Oszimilian/Kabeltester/03_Dokumente/02_Projektdokumentation/01_Dokumentation_Latex/Abschlussprojekt_LaTeX_002/BA_Auftragsdurchführung.tex

%%%%%%%%%%%%%%%%%%%%%%%%%%%%%%%%%%%%%%%%%%%%%%%%%%%%%%%%%%%%%%%%%%%%%%%%%%%%%%%%%%%%%%%%%%%%%%%%%%%%%%%%%%%%%%%%%%%%%%%%%																																						%
%														Versorgung														%
%																														%
%%%%%%%%%%%%%%%%%%%%%%%%%%%%%%%%%%%%%%%%%%%%%%%%%%%%%%%%%%%%%%%%%%%%%%%%%%%%%%%%%%%%%%%%%%%%%%%%%%%%%%%%%%%%%%%%%%%%%%%%%

\section{Schaltplanentwurf}

In den hier abgebildeten Schaltplanausschnitte werden vereinzelt Fehler markiert. Diese sind dabei schon behoben und werden im Kapitel Fehleranalyse behandelt. 

\subsection{Versorgung}

\subsubsection{Schutzbeschaltung}

\begin{center}
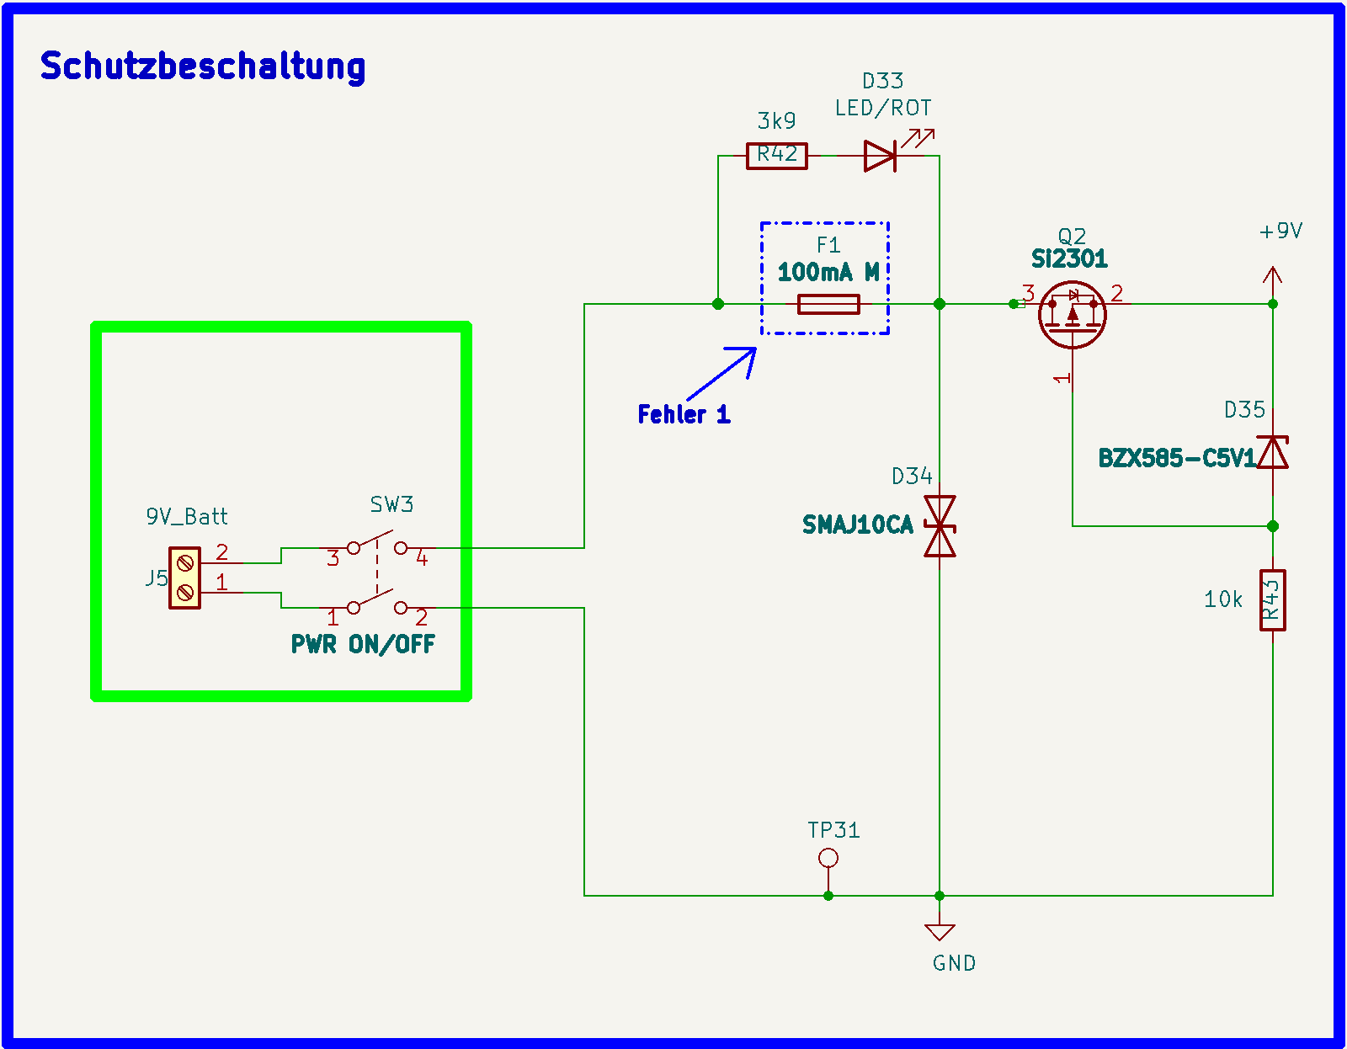
[picture p1: 03_Dokumente/02_Projektdokumentation/01_Dokumentation_Latex/Abschlussprojekt_LaTeX_002/Bilder/Schutzbeschaltung.png]

\end{center}

Um die Schaltung zu schützen wurde auf eine umfangreiche Eingangsschutzbeschaltung gesetzt. Die Versorgungsspannung kann dabei zweipolig durch den Schalter \glqq Power ON/OFF SW3 \grqq{} abgeschaltet werden.
\\
\\
Die mittelträge Sicherung F1 ist für den Überstromschutz verantwortlich. Löst diese aus, so fließt ein Strom über R42 und D33. Dabei wird der gesamte Stromfluss in der Schaltung auf ein Maximum von 2mA begrenzt. Als Ergebnis leuchtet D33 rot.
\\
Im Normalbetrieb werden R42 und D33 durch den ohmschen Widerstand der Sicherung F1 (12R) überbrückt.
\\
\\
Um den Eingang des DC/DC Wandlers vor Überspannungsspitzen zu schützen, kommt eine 10V TVS Diode zum Einsatz. Die Eingangsspannung dieser Schaltung wird dadurch auf ein Spannungsmaximum von 10V begrenzt. 
\\
\\
Da es bei einer Batterieanwendung sehr schnell zu einer ungewollten Verpolung der Anschlüsse kommen kann, wird ein Verpolungsschutz benötigt.
\\
Liegt eine korrekt gepolte Spannung an, so fließt der Strom durch die Z-Diode D35 und den strombegrenzenden Widerstand R43. Die über die Z-Diode abfallende Spannung von 5,1V liegt somit auch an den Anschlüssen \glqq Source\grqq{} und \glqq Gate\grqq des P-Channel MOSFET Q2 an.
In diesem Fall liegt eine um ca. 5V negativere Spannung an Gate gegenüber Source an. Die Drain-Source Strecke leitet und es kann Strom fließen.
\\ 
Wird die Versorgungsspannung verpolt, so fließt der Strom durch den Widerstand R43 und durch die Diode D35. Die Diode D35 befindet sich dabei in Durchlassrichtung und besitzt somit die Eigenschaften einer Si-Diode.
Die Spannung an dem Gate ist dabei um ca. 5V positiver gegenüber Source. Der P-Channel MOSFET sperrt und unterbindet einen Stromfluss.
\\

\subsubsection{DC/DC Wandler}

\begin{center}
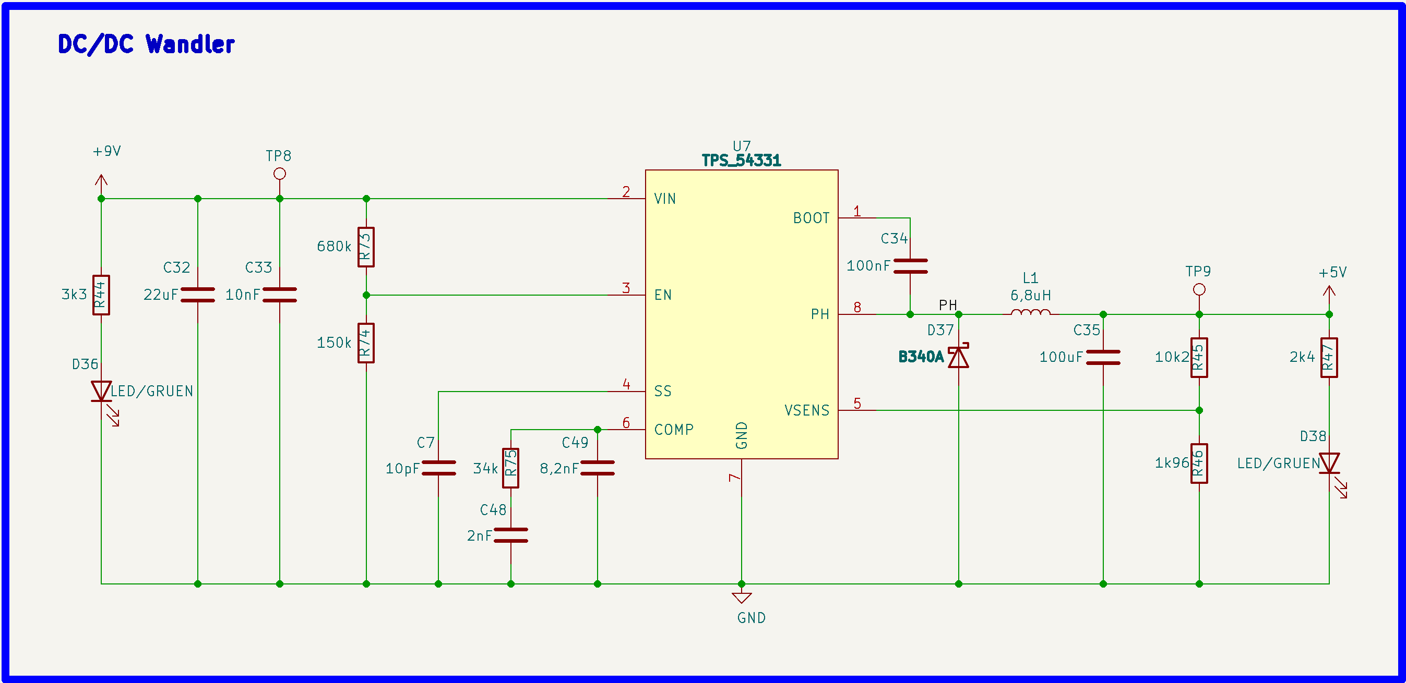
[picture p2: 03_Dokumente/02_Projektdokumentation/01_Dokumentation_Latex/Abschlussprojekt_LaTeX_002/Bilder/DCDCWandler.png]

\end{center}

Bei der Auswahl des DC/DC Wandlers wurde auf die Verfügbarkeit bei BMK im Haus geachtet.
\\
Die Dimensionierung der externen Bauelemente wurde mit Hilfe des \glqq Texas Instruments Power Designer\grqq{} Web-Tool durchgeführt.
\\
Die grünen LED's D36 und D38 sorgen für ein optisches Feedback der Versorgungsspannungen.
\\
Allgemein wurde der Wandler für eine Ausgangsspannung von +5V und einen Ausgangsstrom von ca. 1,5A dimensioniert. Mit den Widerständen R73 und R74 kann der Schaltregler bei Über/-Unterspannung abschalten. Dafür wird eine oberer sowie untere Schaltschwelle berechnet.

\begin{center}
\begin{align*}
	R73 &= \dfrac{V_{\Delta}}{3uA} = \dfrac{2V}{3uA} = 666k  \Rightarrow 680k\\
	\\
	R74 &= \dfrac{1,25V}{\dfrac{Vs - 1,25V}{R73} + 1uA} = \dfrac{1,25V}{\dfrac{8V - 1,25V}{680k} + 1uA} = 126k \Rightarrow 150k	\\
	\\
	V_{OUT}	&= V_{REF} + (\dfrac{R45}{R46} + 1) = 0,8V + (\dfrac{10,2k}{1,96k} + 1) = 4,96V
\end{align*}
\end{center}

\newpage

%%%%%%%%%%%%%%%%%%%%%%%%%%%%%%%%%%%%%%%%%%%%%%%%%%%%%%%%%%%%%%%%%%%%%%%%%%%%%%%%%%%%%%%%%%%%%%%%%%%%%%%%%%%%%%%%%%%%%%%%%																																						%
%														NE555 Taktgeber													%
%																														%
%%%%%%%%%%%%%%%%%%%%%%%%%%%%%%%%%%%%%%%%%%%%%%%%%%%%%%%%%%%%%%%%%%%%%%%%%%%%%%%%%%%%%%%%%%%%%%%%%%%%%%%%%%%%%%%%%%%%%%%%%

\subsection{NE555 Taktgeber}

\subsubsection{Takt}

\begin{center}
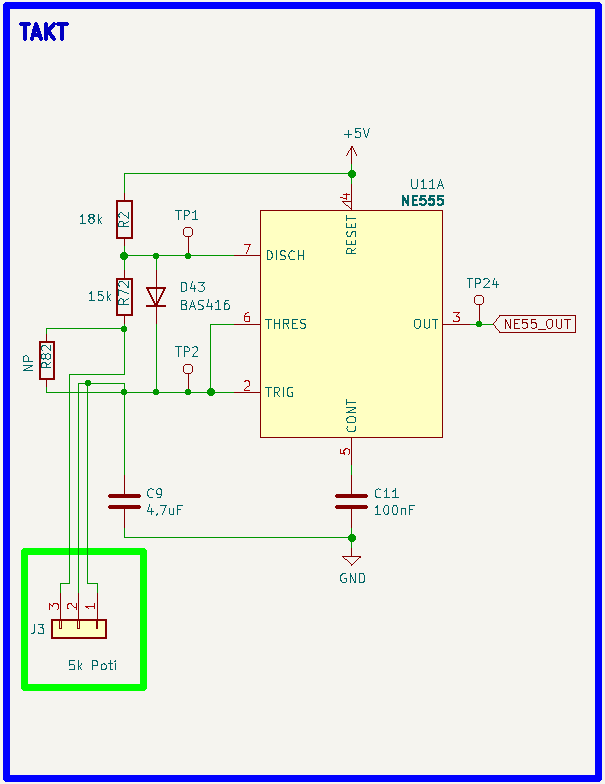
[picture p3: 03_Dokumente/02_Projektdokumentation/01_Dokumentation_Latex/Abschlussprojekt_LaTeX_002/Bilder/Takt.png]

\end{center}

Als Taktgeber kommt der \glqq NE555 \grqq{} zum Einsatz. Dieser wird als astabile Kippstufe betrieben und versorgt die Schaltung mit einem rechteckförmigen Taktsignal. Mit Hilfe der Diode D43 kommt eis zu einem symetrischen Verhältnis des Tastgrad. Über das Poti (Connector) J3 soll die Ausgangsfrequenz auf ca. 10Hz eingestellt werden können. 
\\
\\
Im Einschaltmoment ist C9 entladen (Kurzschluss). Somit liegt das Signal am Triggereingang (PIN 2) unterhalb von $\frac{1}{3} VCC$. Das interne FlipFlop wird gesetzt und der Ausgang (PIN 3) erfährt einen High-Pegel. Der Kondensator C9 lädt sich nun über R2, J3 und D43 auf. Der Ladevorgang hält so lange an, bis das Spannungspotential an Pin 6 (Threshold) einen höheren Wert als $\frac{2}{3} VCC$ aufweist. Das interne FlipFlop wird zurückgesetzt und der Ausgang schaltet auf Low. Der Kondensator C9 entlädt sich nun über R72 und den (auf GND durchgeschaltenen) Pin 7 (Discharge). Hat sich der Kondensator nun wieder auf ein Spannungspotential unterhalb von $\frac{1}{3}$ entladen, so wird er Ausgang erneut gesetzt und der Entladevorgang über Pin 7 unterbunden. Dieser Vorgang wiederholt sich solange eine Versorgungsspannung anliegt. 

\begin{center}
\begin{align*}
	f_{OUT} &= \dfrac{1}{0,69*R2*C9 + 0,69*(R72+R_{J3})* C9} = \dfrac{1}{0,69*18k*4,7uF*2} = 8,5Hz
\end{align*} 
\end{center}

\newpage
\subsubsection{Taktumschaltung}

\begin{center}
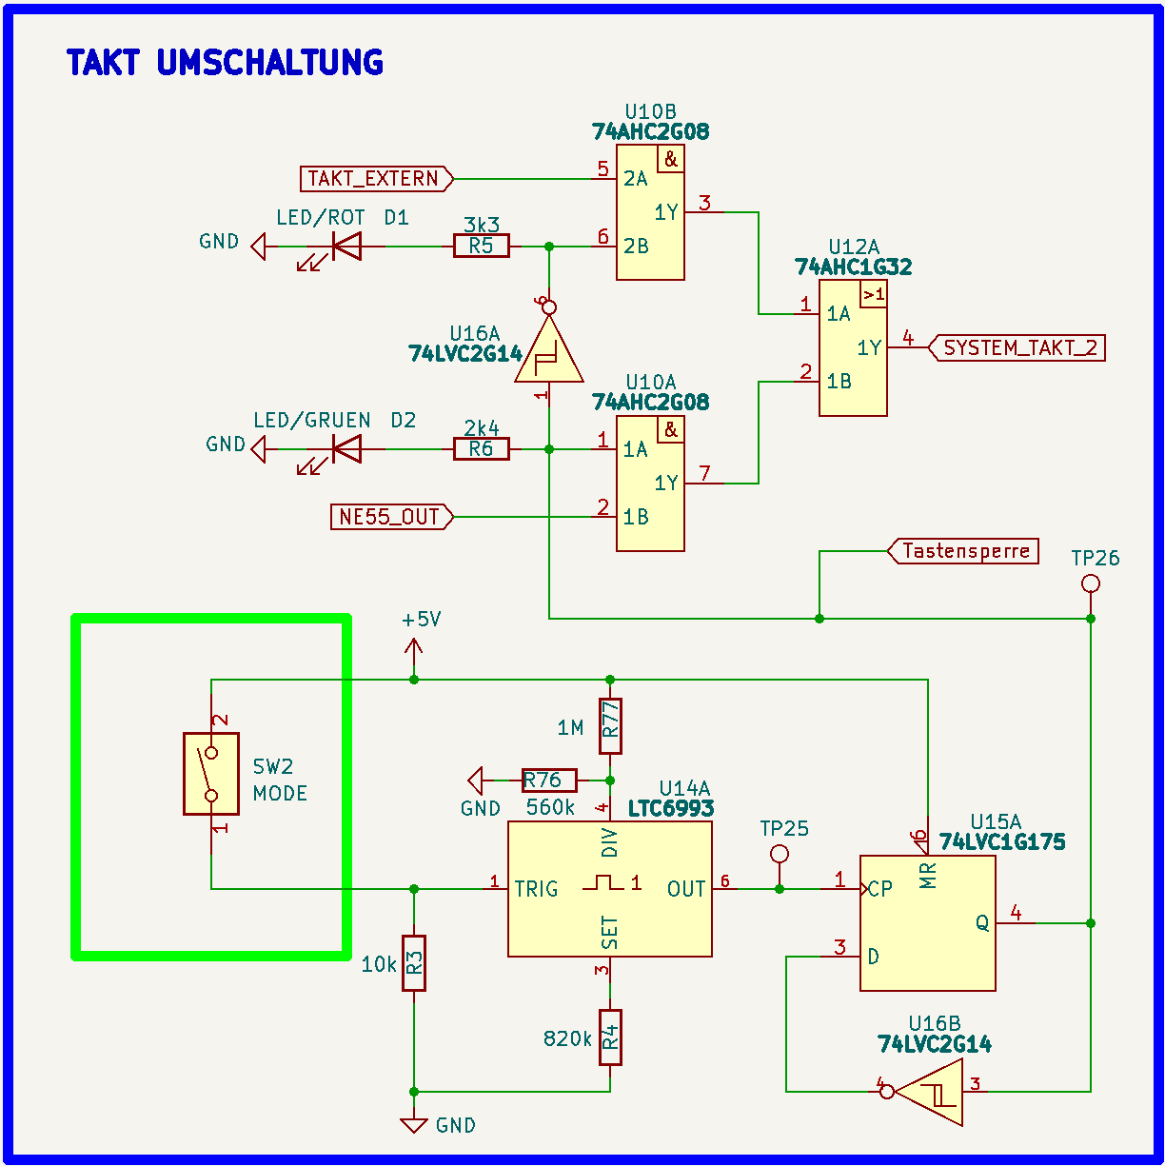
[picture p4: 03_Dokumente/02_Projektdokumentation/01_Dokumentation_Latex/Abschlussprojekt_LaTeX_002/Bilder/Taktumschaltung.png]

\end{center}

\textbf{Funktionsbeschreibung LTC6993 U14}
\\
Das IC „LTC6993“ ist eine monostabile Kippstufe mit einer einstellbaren Pulsweite von 1us – 33,6s. Dabei wird bei einem Impuls über den Trigger-Eingang (Pin 1) der Ausgangszustand für eine einstellbare Zeit gespeichert, bevor der Ausgang wieder in den stabilen Zustand zurück kippt. Über die Außenbeschaltung der Pins „DIV“ und „SET“ kann die Pulsweite (Kipp-Zeit) konfiguriert werden. Der Pin „DIV“ ist dabei intern mit einem 4 Bit A/D-Wandler beschalten. Dieser führt drei seiner Datenleitungen einem Taktteiler zu. Dieser Taktteiler ist dadurch zwischen 1 und 2 097 152 einstellbar. Die vierte Datenleitung (MSB) übergibt ihren Zustand dem Block „Output Polarity“. Dieser bestimmt den stabilen Ausgangspegel des Monoflops. Ein Widerstand zwischen GND und dem Pin „SET“ ist dabei für die Oszillator-Frequenz zuständig. Die Spannung zwischen „SET“ und GND wird dabei konstant auf 1V gehalten, was einen konstanten Stromfluss hervorruft. Die dabei möglichen Widerstandswerte liegen zwischen 50k und 800k (1,25uA-20uA), was einem Frequenzbereich von 1Mhz bis 62,5kHz entspricht. Die durch den Taktteiler geteilte Oszillatorfrequenz setzt dabei ein RS-FlipFlop periodisch zurück. Ein Impuls am Trigger-Eingang setzt das FlipFlop, so dass es erst nach einer bestimmten Kipp-Zeit zurückgesetzt werden kann. Der FlipFlop-Ausgang ist dabei über den „Output Polarity“ Block mit dem Ausgang des IC‘s verbunden.

\newpage

\textbf{Funktion}
\\
Der Schaltungsteil \glqq Taktumschaltung \grqq{} ist für das Umschalten der zwei Taktquellen verantwortlich. Es kann zwischen den intern (durch den NE555 generierten) Takt und externen (durch eine vorgeschaltene Messplatine zugeführten) Takt umgeschalten werden . Ausschlaggebend dafür sind zwei Schaltungsteile. Durch betätigen des Tasters SW2 (MODE), wird zwischen den Taktquellen umgeschaltet. Da jede Tasterbetätigung ein mechanisch verursachtes Prellen der Kontakte verursacht, muss dies durch das nachgeschaltete  Monoflop (U14) unterbunden werden. Die Zeit, die das Monoflop benötigt mit seinem Ausgang auf einen eingangsseitigen Triggerimpuls zu reagieren, dauert länger als das prellende Signal selbst. Somit kommt am Ausgang des Monoflops eine saubere Signalflanke zustande. 
\\
\\
Das nachgeschaltete D-FlipFlop ist in seiner Verschaltung mit den auf den Dateneingang zurückgeführten invertierten Ausgang als Toggle FlipFlop zu betrachten. Für einen Pegelwechsel am Ausgang Q des Toggle-FlipFlops ist eine steigende und fallende Flanke notwendig. Eine Betätigung mit zwei dynamischen Flanken verursacht demnach einen ausgangsseitigen Pegelwechsel an TP28 mit nur einer Flanke. 
\\
\\
Die auf TP28 folgende Schaltung bildet eine zweifach TOR-Schaltung mit nur einem Steuereingang.
\\
Ein High-Signal an TP28 führt dazu, dass die an den Pin 2 (U10A) anliegenden Taktsignale auf den Ausgang übertragen werden. Durch die Invertierung von TP28 werden Taktsignale, die an Pin 5 (U10B) anliegen, unterdrückt. Der Ausgang bleibt Low.
\\
Ein Low-Signal an TP28 führt zur Unterdrückung der an Pin 2 (U10A) anliegenden Signale. Das durch eine vorgeschaltene Messplatine der Schaltung zugeführte Signal an Pin 5 (U10B) wird nun an den Ausgang übertragen.
\\
Das Oder-Gatter überträgt entweder das Signal von U10B oder das Signal von U10A auf seinen Ausgang. 
\\
\\
\textbf{Kippzeit für $N_{DIV} = 32 768$}
\\
\begin{align*}
	t_{Kipp} &= \frac{N_{DIV * R4}}{50k} * 1us = \frac{32768 * 820k}{50k} * 1us = 537ms
\end{align*}

\newpage

\subsubsection{Taktteilung}

\begin{center}
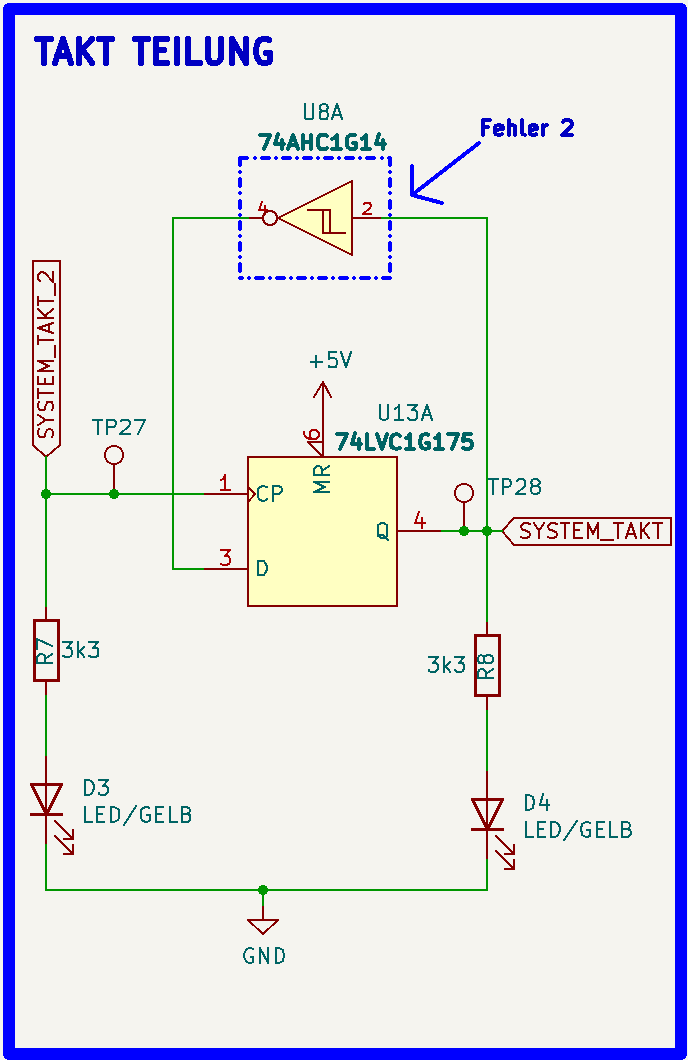
[picture p5: 03_Dokumente/02_Projektdokumentation/01_Dokumentation_Latex/Abschlussprojekt_LaTeX_002/Bilder/Taktteilung.png]

\end{center}

Für einen folgenden Schaltungsteil wird ein Takt, welcher die doppelte Frequenz des Messtaktes besitzt benötigt. Dazu wird der Grundtakt durch zwei geteilt und als Messtakt verwendet. Der externe oder interne Grundtakt wird vom folgenden Schaltungsteil verwendet.
\\
D3 und D4 geben ein optisches Feedback des Mess- und Grundtaktes. 

\subsection{Dezimal Zähler}

\subsubsection{Messung starten}

\begin{center}
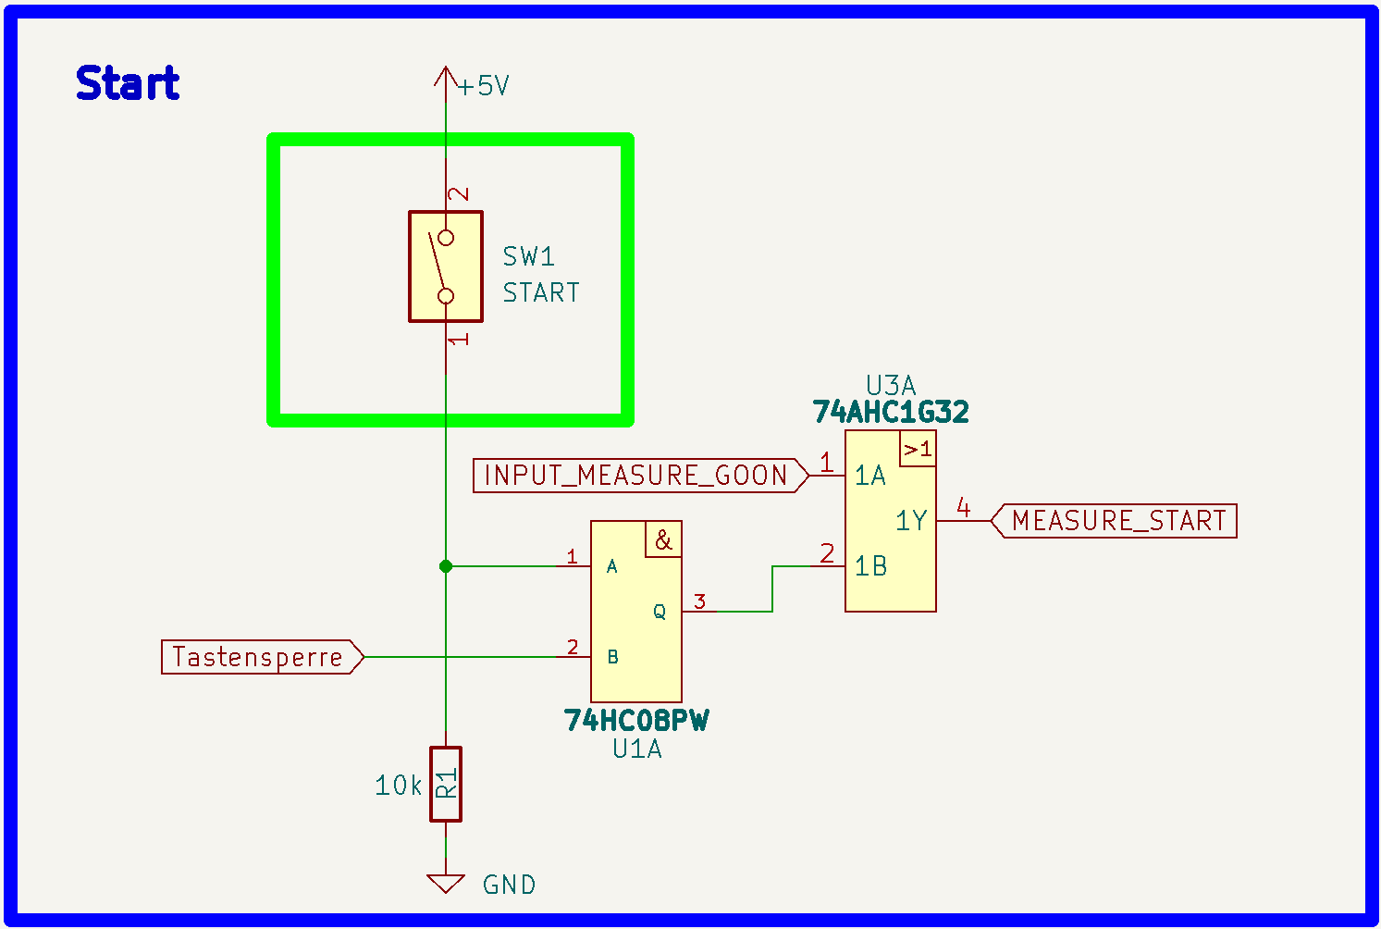
[picture p6: 03_Dokumente/02_Projektdokumentation/01_Dokumentation_Latex/Abschlussprojekt_LaTeX_002/Bilder/Start.png]

\end{center}

Die Messung kann über Betätigung des Tasters SW1 (START) oder über ein externes Signal (Label: INPUT MEASURE GOON) gestartet werden. In einem Verbund aus mehreren Messplatinen hintereinander, führt der Abschlussimpuls einer Messung auf einer Messplatine, auch zu einem Startimpuls für weitere Messplatinen.
\\
\\ 
Befindet sich die Messplatine im \glqq Master Mode / \grqq{} (\textbf{Master Mode:}  Grundtakt = Interner Takt \textbf{Slave Mode:} Grundtakt = Externer Takt), so kann die Messung durch den Tasters SW1 gestartet werden. Befindet sich die Messplatine im \glqq Slave Mode \grqq{} so kann nur durch ein externes Signal die Messung gestartet werden. Der Taster SW1 (START) ist gesperrt.

\newpage
\subsubsection{Reset}

\begin{center}
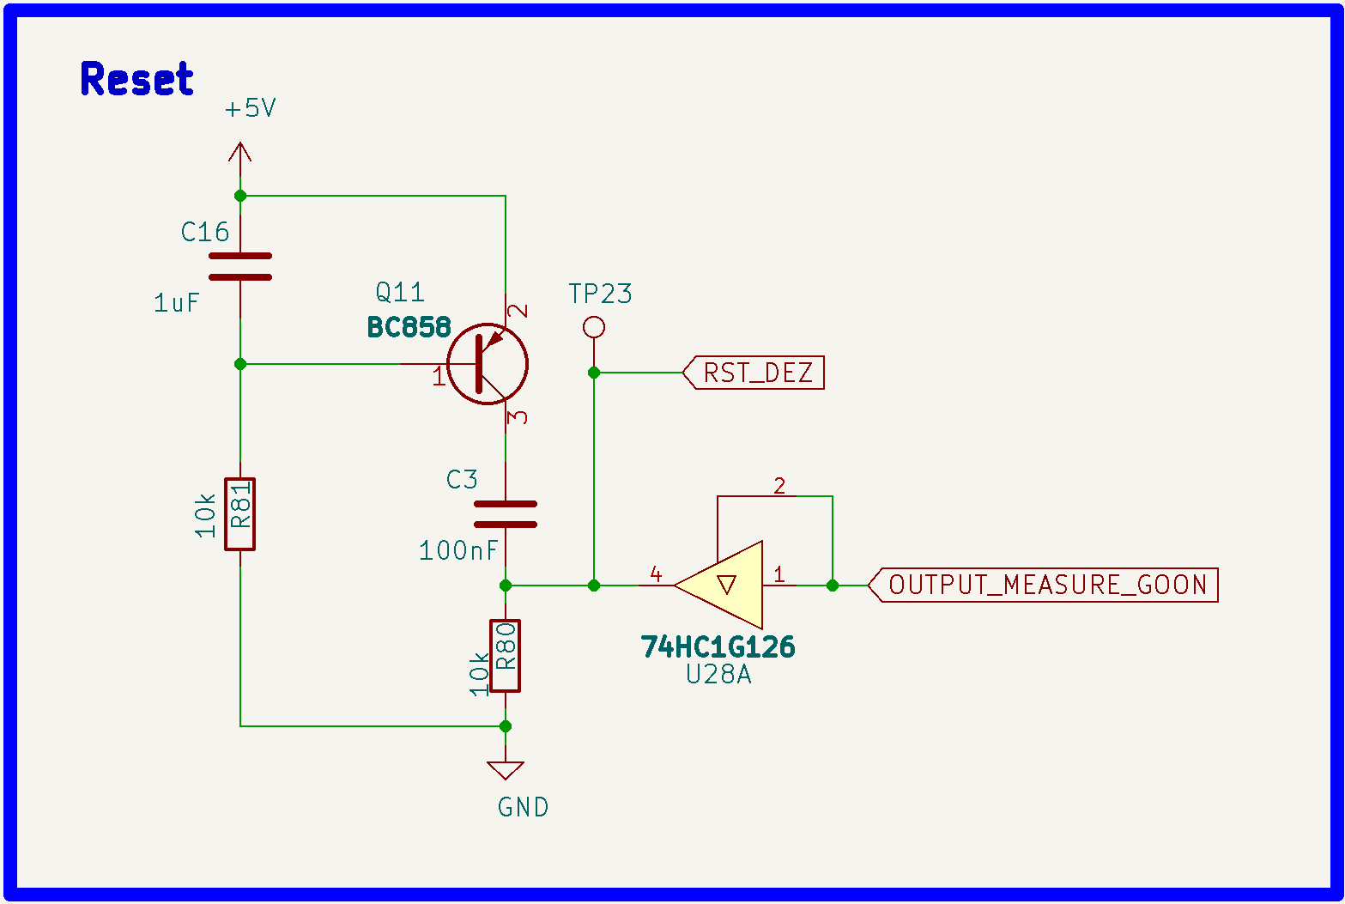
[picture p7: 03_Dokumente/02_Projektdokumentation/01_Dokumentation_Latex/Abschlussprojekt_LaTeX_002/Bilder/Reset.png]

\end{center}

Die Aufgabe dieser Schaltung besteht darin, kurze Zeit nach dem Einschalten einen Reset-Impuls für bestimmte Schaltungsteile zu generieren. Wird dies nicht gemacht, so kann es unter Umständen dazu kommen, dass die Messung nicht gestartet werden kann.
\\
\\
Im Einschaltmoment fließt Strom über C16 und R81. C16 liegt dabei parallel zu den Anschlüssen \glqq Emitter\grqq{} und \glqq Basis\grqq{} des PNP-Transistors Q11. Da im Einschaltmoment C16 als Kurzschluss zu betrachten ist, liegen Emitter und Basis auf dem selben Potential. Ein Stromfluss ist daher nicht möglich und der Transistor Q11 sperrt. C16 beginnt sich langsam aufzuladen. Liegt ein bestimmtes Spannungspotetial über C16 an (ca. 0,7V $U_{BE}$), so ist ein Stromfluss durch die Basis möglich. Nach einer bestimmten Verzögerung ist nun auch ein Stromfluss durch den Transistor Q11, durch den Kondensator C5 und den Widerstand R80 möglich. Da C3 ebenfalls im ersten Moment als Kurzschluss zu betrachten ist, fällt über R80 anfänglich ein 5V Pegel ab. Die Spannung über C3 baut sich dabei sehr schnell auf, was einen kurzen Nadelimpuls zur Folge hat. Das globale Label \glqq RST DEZ\grqq{} resetet die Schaltungsteile.  
\\
\\
Das IC U28A (IC mit Tri-State Funktion) dient zur Stromkreisentkopplung und soll beim Resetvorgang einen Kurzschluss vermeiden. Der Strom kann dabei nur in eine Richtung fließen.

\newpage
\subsubsection{Ablauf Steuerung}

\begin{center}
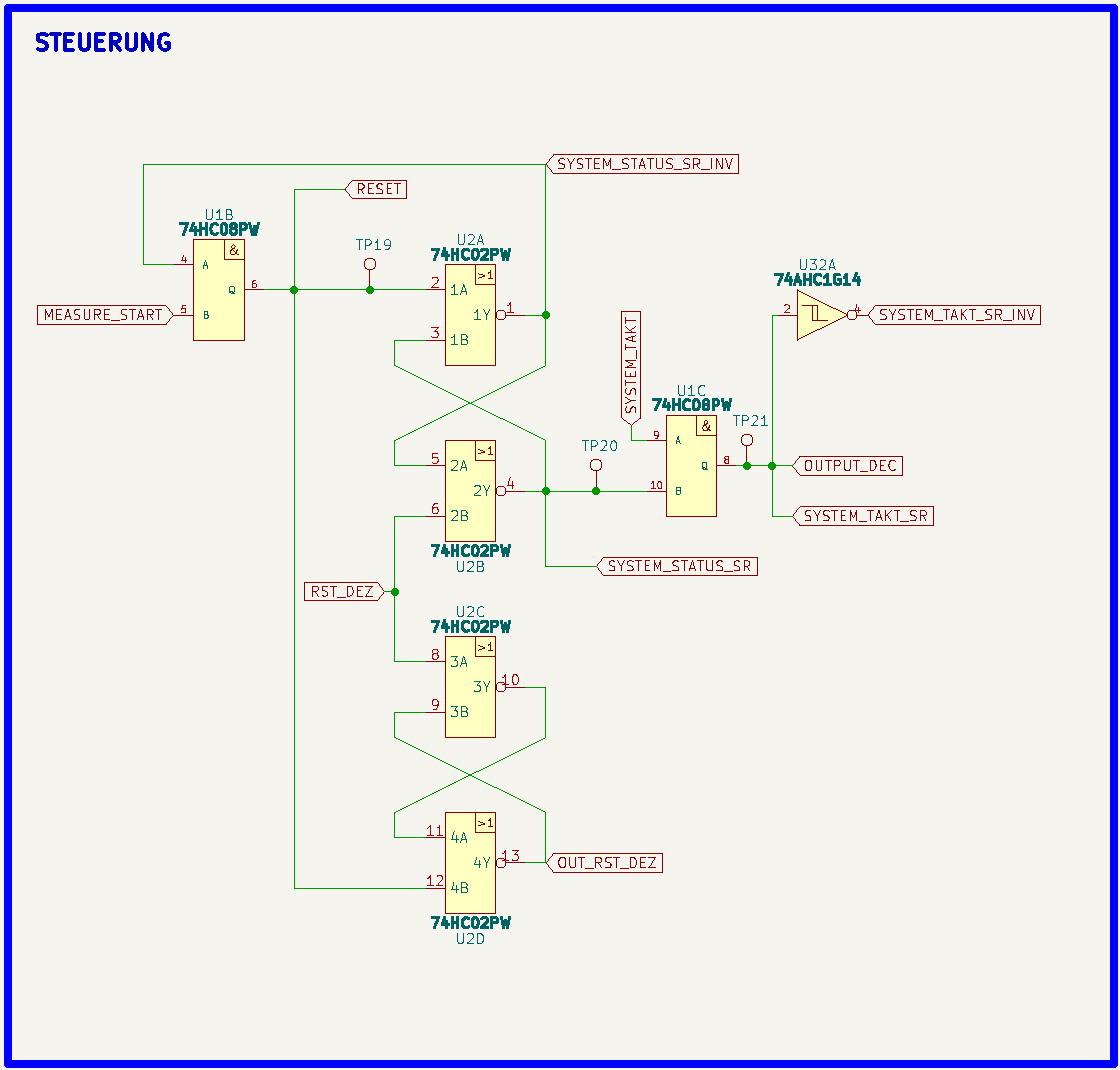
[picture p8: 03_Dokumente/02_Projektdokumentation/01_Dokumentation_Latex/Abschlussprojekt_LaTeX_002/Bilder/Controlling.png]

\end{center}

Durch die voran gegangene Schaltung, welche die FlipFlops \textbf{FF1:} U2A und U2B und \textbf{FF2:} U2C und U2D in die definierten Ausgangszustände bringt, kann nun ein einwandfreier Start der Messung durchgeführt werden. 
\\
\\
Zum Start der Messung muss das IC U2A einen ausgangsseitigen High-Pegel ausgeben. Der Ausgang ist dabei auf den Steuereingang des TOR-Gatter zurückgeführt.
\\
Das TOR-Gatter U1C erfährt an seinem Steuereingang Pin 10 einen Low-Pegel. Der anliegende Messtakt wird gesperrt.
\\
An dem Ausgang des IC U2D liegt ein Low-Signal an. Dieses Low-Signal resetet die folgende Schaltung dauerhaft.  
\\
\\
Ein High-Signal am Pin 5 (U1B \textbf{LABEL:} MEASURE START) wird auf den Ausgang übertragen. Das an TP19 zu messende High-Signal bleibt so lange aktiv, wie das folgende FlipFlop (U2A und U2B) für das Rücksetzen des Ausganges Pin 1 bzw. für das Setzen des Ausganges Pin 4 benötigt (Gatterlaufzeit). Ein eventuell prellendes Signal an U1B wird somit sofort unterdrückt.
\\
Das High-Signal an TP20 führt dazu, dass der Messtakt an Pin 8 (U1C) auf den Ausgang übertragen wird. 
\\ 
Der Nadelimpuls an TP19, führt dadurch zu einem Rücksetzen des IC U2D. Das daraus resultierende Low-Signal gibt die Folgeschaltung frei.

\newpage
\subsubsection{Dezimalzähler}

\begin{center}
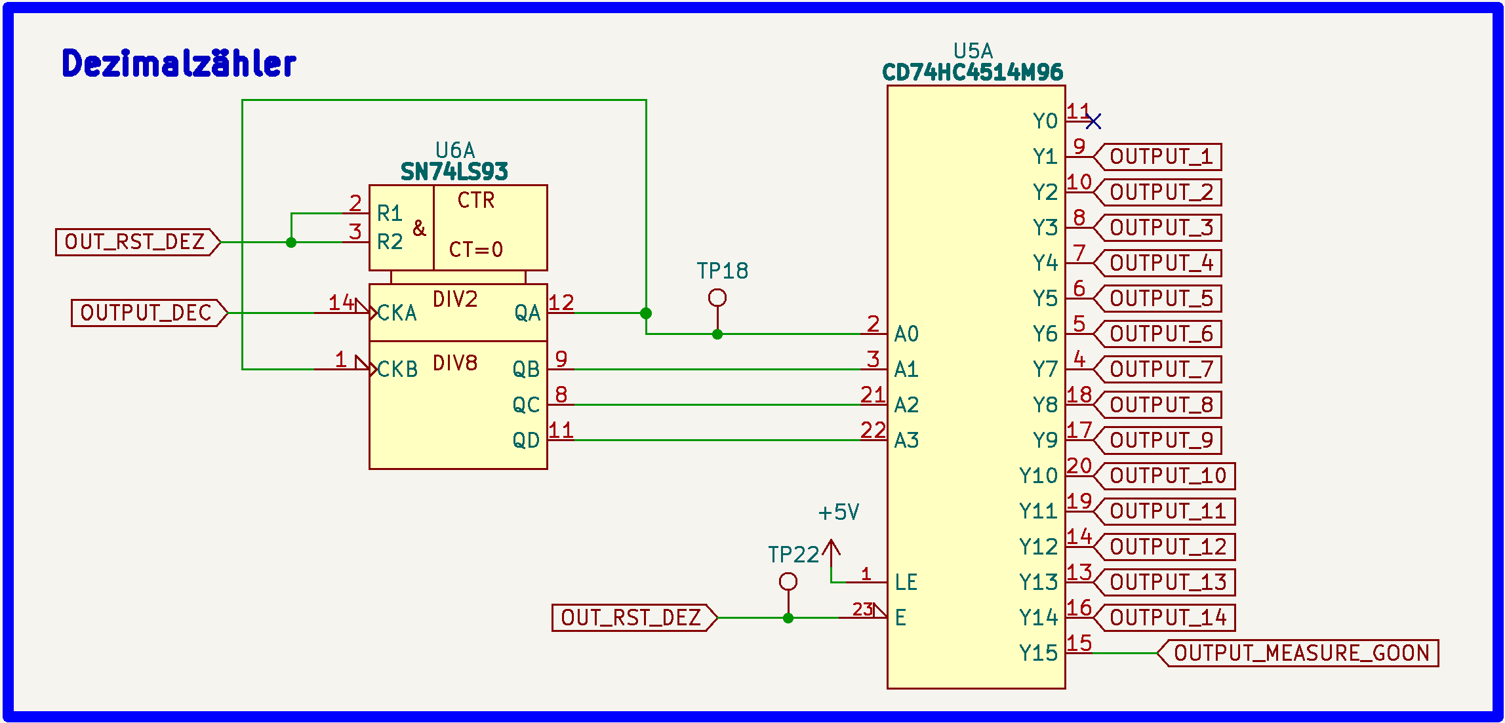
[picture p9: 03_Dokumente/02_Projektdokumentation/01_Dokumentation_Latex/Abschlussprojekt_LaTeX_002/Bilder/Dezimalzähler.png]

\end{center}

Die Aufgabe dieser Schaltung besteht darin, durch ein Eingangssignal \glqq OUTPUT DEC\grqq  von 0 bis 15 dezimal hochzuzählen. Dabei sollen alle Leitungen des zu prüfenden Kabels der Reihe nach ein Messsignal erhalten.
\\
\\
U6A ist dabei ein Binärzähler. Liegt an Pin 2 und 3 ein Low-Signal an, kann das Signal an Pin 4 binär hochgezählt werden. Liegt an Pin 2 und 3 ein High-Signal an,\\ werden die Ausgänge zurückgesetzt.
\\
\\
Der Encoder U5A wandelt dabei das 4 Bit Binärsignal in ein 16 Fach Dezimal Signal um. Liegt an Pin 23 ein Low-Signal, so werden alle Ausgänge freigeschalten. Liegt ein High-Signal an, werden die Ausgänge gesperrt.
\\
\\
Der Ausgang Y0 (Pin11) wird für die Messung nicht verwendet, da die Länge dieses Signales nicht konstant ist. 
\\
\\
Erreicht der Dezimalzähler den Wert 16, so wird die Schaltung zurückgesetzt und gegebenenfalls die Messung einer weiteren Messplatine gestartet.

\newpage
\subsection{Leitungstreiber und Umschaltung}

\begin{center}
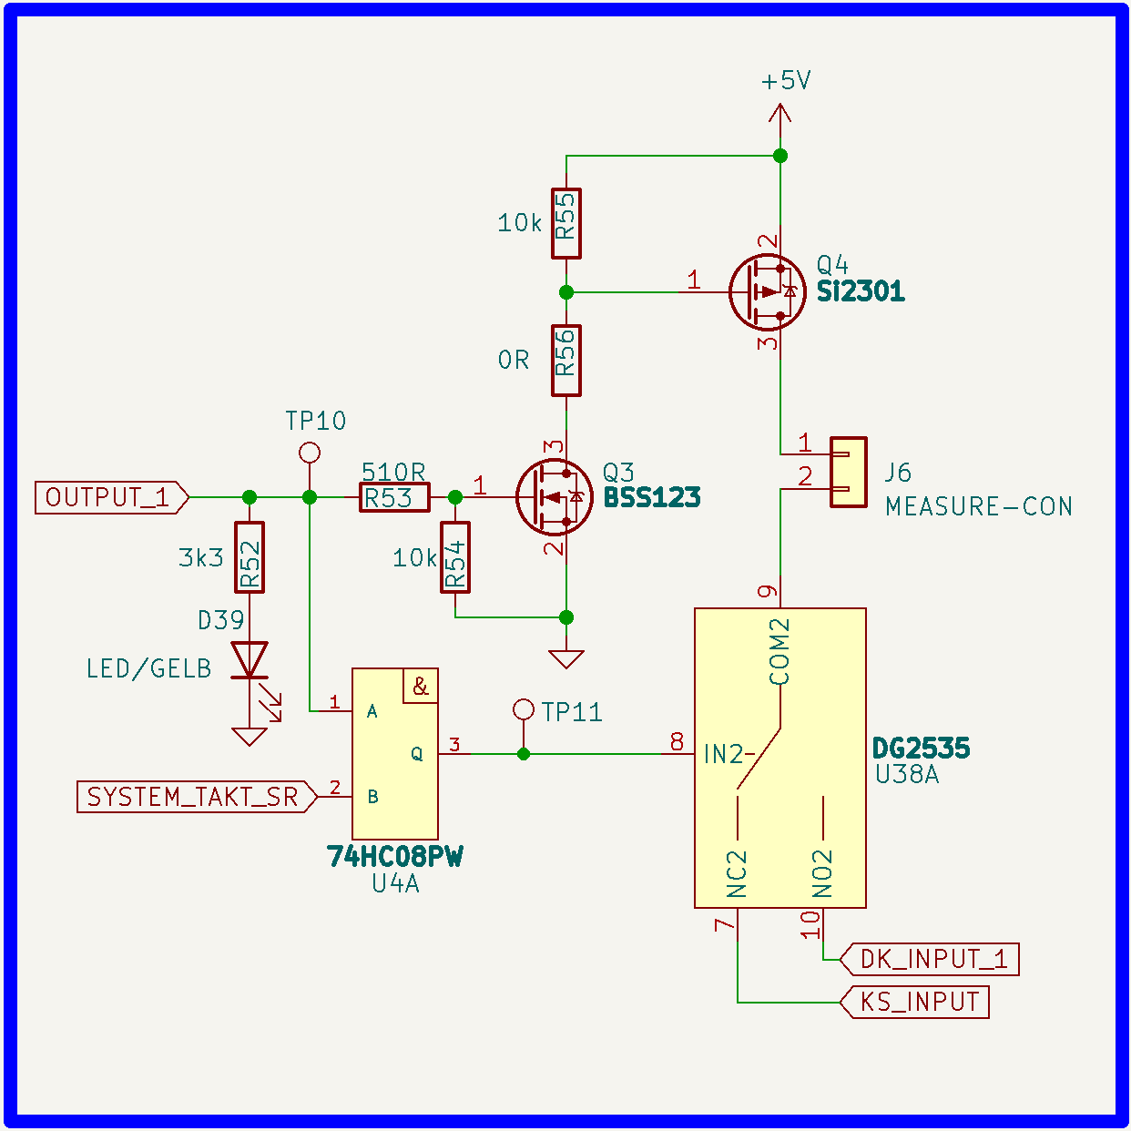
[picture p10: 03_Dokumente/02_Projektdokumentation/01_Dokumentation_Latex/Abschlussprojekt_LaTeX_002/Bilder/Leitungstreiber.png]

\end{center}

Liegt an TP10 ein High-Signal an, so leuchtet die LED D39.
\\
Q3 wird in Folge dessen leitend und zieht das Gate des P-Channel MOSFET auf GND. 
\\
Dadurch erlangt das Gate ein negativeres Potential als Source. Die Drain-Source Strecke von Q4 wird dadurch leitend. Ein 5V Messsignal liegt am Kabel zwischen J6 an. 
\\
\\
Nach der Hälfte des Messzyklus wechselt das Signal an TP11 durch das Signal an Pin 2 (U4A) von Low nach High. 
\\
Der Analogschalter ändert somit den Messbetrieb von Konstantstrommessung auf Durchgangs- und Kurzschlussmessung.
\\
Bei der Auswahl des Analogschalters, wurde auf einen geringen $R_{Switch-ON}$ Widerstand geachtet. Mit typ. 300mR bei 5V VCC wird diese Anforderung erfüllt. 

\newpage
\subsection{Durchgangs und Kurzschlussprüfung}

\begin{center}
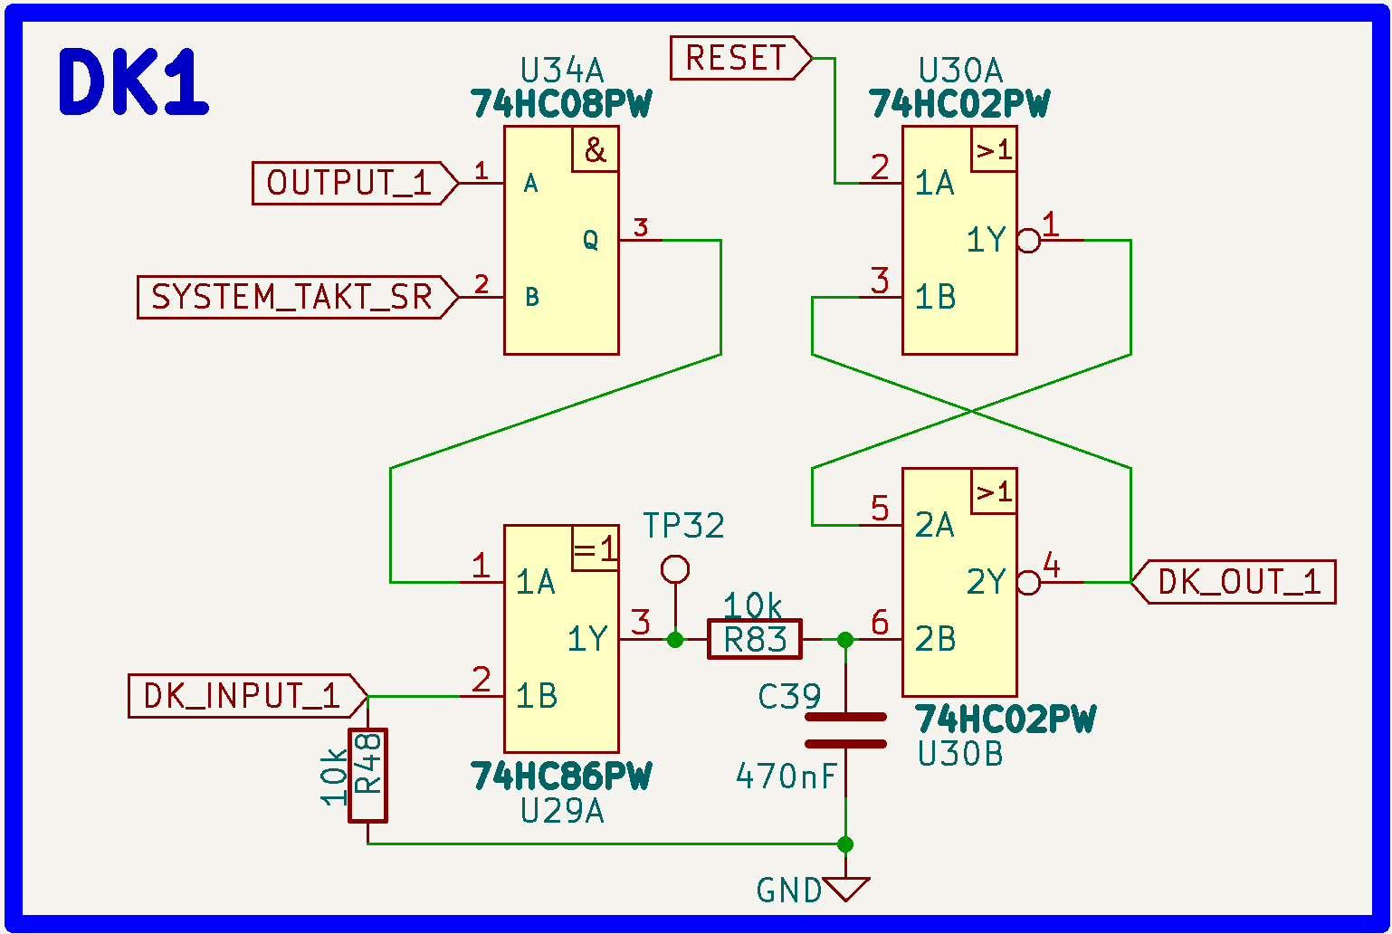
[picture p11: 03_Dokumente/02_Projektdokumentation/01_Dokumentation_Latex/Abschlussprojekt_LaTeX_002/Bilder/Durchgangsprüfung.png]

\end{center}

Beim Start der Messung wird durch das Signal an Pin 2 (U30A) der Ausgang Pin 4 (U30B) des FlipFlop gesetzt. 
\\
\\
Dabei gibt es folgende Zustände:

\begin{itemize}
	\item{Liegt an den Eingängen Pin 1 und 2 (U29A) ein High-Signal,  so hat der Ausgang Pin 3 einen Low-Pegel. Das FlipFlop wird nicht zurückgesetzt.}
	
	\item{Liegt an Pin 2 durch eine Fehler des Kabel ein Low-Signal an, so hat der Ausgang Pin 3 einen High-Pegel. Das FlipFlop wird dabei zurückgesetzt.}
	
	\item{Liegt durch einen Kurzschluss an Pin 2 ein High-Signal und an Pin 1 kein High-Signal, so hat der Ausgang Pin 3 ebenfalls ein High-Pegel vorzuweisen. Das FlipFlop wird zurückgesetzt.}
\end{itemize}

\newpage
\subsection{Konstantstrommessung}

\subsubsection{Konstantstrommessung}
\begin{center}
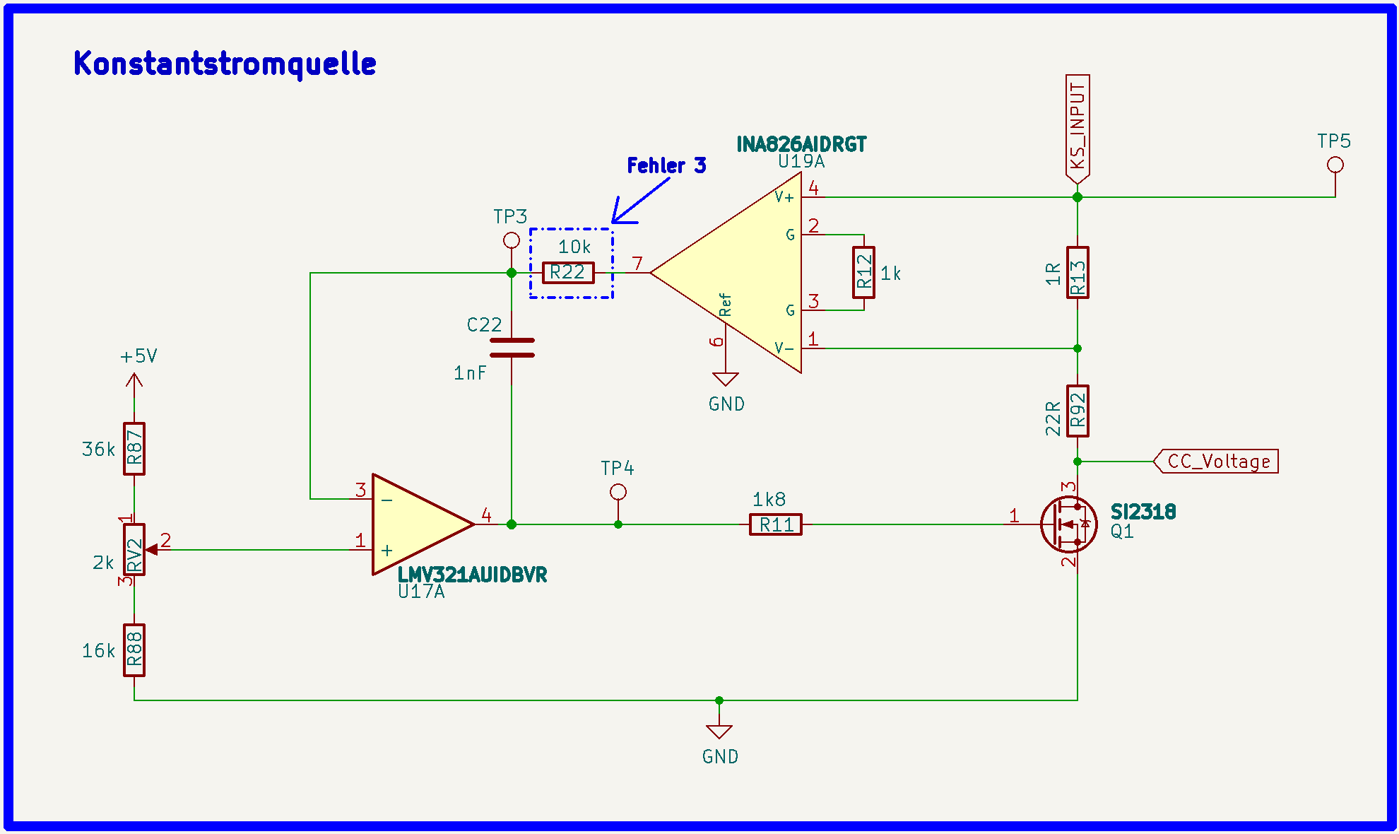
[picture p12: 03_Dokumente/02_Projektdokumentation/01_Dokumentation_Latex/Abschlussprojekt_LaTeX_002/Bilder/Konstantstromquelle.png]

\end{center}

Der Instrumentenverstärker U19A misst durch den Spannungsfall an R13 den durch das zu messende Kabel fließenden Strom. Das Kabel liegt dabei zwischen +5V und dam Label: KS INPUT.
\\
\\
Der Spannungsfall wird durch den INA um den Faktor 50,9 verstärkt. Diese Spannung wird dem\\ Operationsverstärker U17A zugeführt. Dieser versucht durch sein Regelverhalten, den Stromfluss durch das Kabel so anzupassen, dass keine Spannungsdifferenz zwischen seinen Eingängen anliegt.
\\
\\
Über den Spannungsteiler R88, RV2 und R87 wird der Messstrom eingestellt. 
\\
R92 begrenzt den Einschaltstrom, bis der Strom ausgeregelt ist. 
\\
Mit Hilfe der Spannung über Q1 wird der ohmsche Widerstand der Messleitung indirekt erfasst.
\\
\\
\textbf{30mA Messstrom}
\\
\begin{center}
\begin{align*}
	U_{PIN1_{U17A}} &= (1 + \dfrac{49,9k}{R12}) * (R13 * 0,03A) = (1 + \dfrac{49,9k}{1k}) * (1R * 0,03A) = 1,53V
\end{align*} 
\end{center}

\newpage
\subsubsection{Auswertung}
\begin{center}
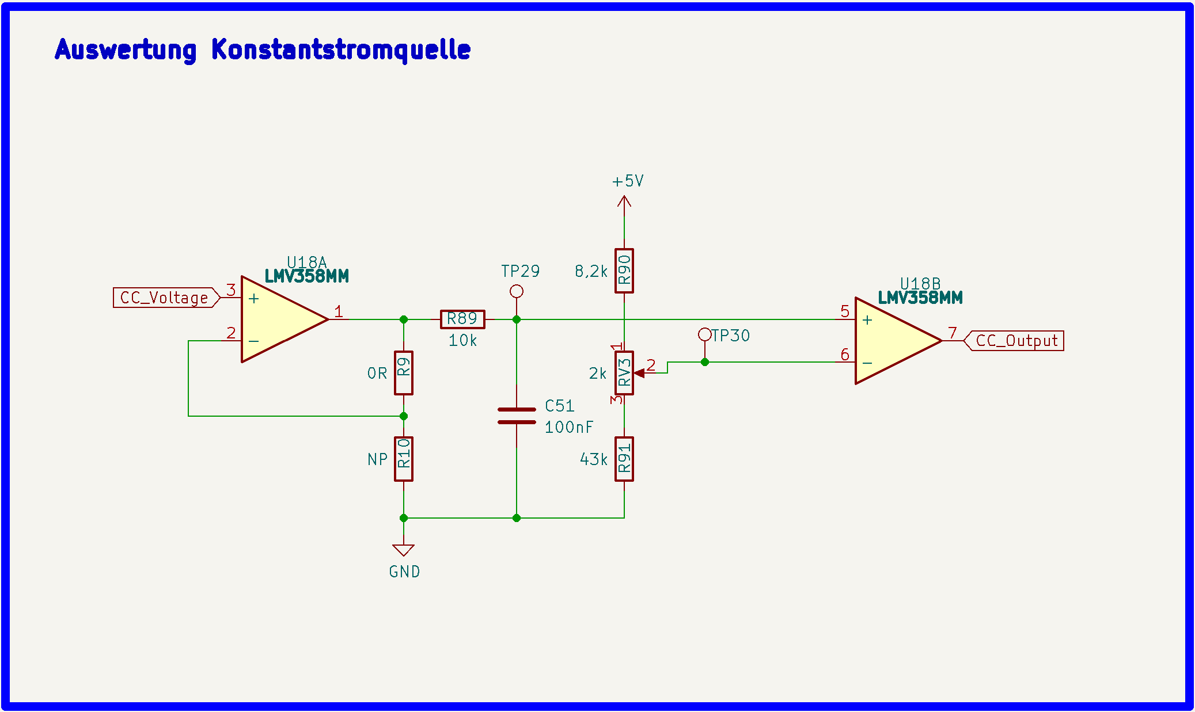
[picture p13: 03_Dokumente/02_Projektdokumentation/01_Dokumentation_Latex/Abschlussprojekt_LaTeX_002/Bilder/Auswertung.png]

\end{center}
NP = Not Placed
\\
\\
Der Operationsverstärker greift diese Spannung hochohmig an Q1 ab. 
\\
Über den nachfolgenden Low-Pass Filter R89 und C51, werden Störungen gefiltert.
\\
Der Komparator U18B vergleicht diese Spannung mit einer durch den Spannungsteiler R90, RV3 und R91 eingestellten Reverenzspannung. 
\\
Diese Reverenzspannung gibt den maximal zulässigen Leitungswiderstand des Prüflings an. 
\\
\\
\textbf{5R max. Aderwiderstand}
\\
\begin{center}
\begin{align*}
	U_{TP30} &= (\dfrac{5V}{30mA} - (R_{L_{MAX}} + R13 + R92)) * 0,03A = (\dfrac{5V}{30mA} - (5R + 1R + 22R)) * 0,03A = 4,16V
\end{align*}
\end{center}
\textbf{Grenzfrequenz:}
\begin{center}
\begin{align*}
	f_{g} &= \dfrac{1}{2 * \pi * R_{89} * C_{51}} = \dfrac{1}{2 * \pi * 10k * 100nF} = 159Hz
\end{align*}
\end{center}

\newpage
\subsubsection{Ausgabe}
\begin{center}
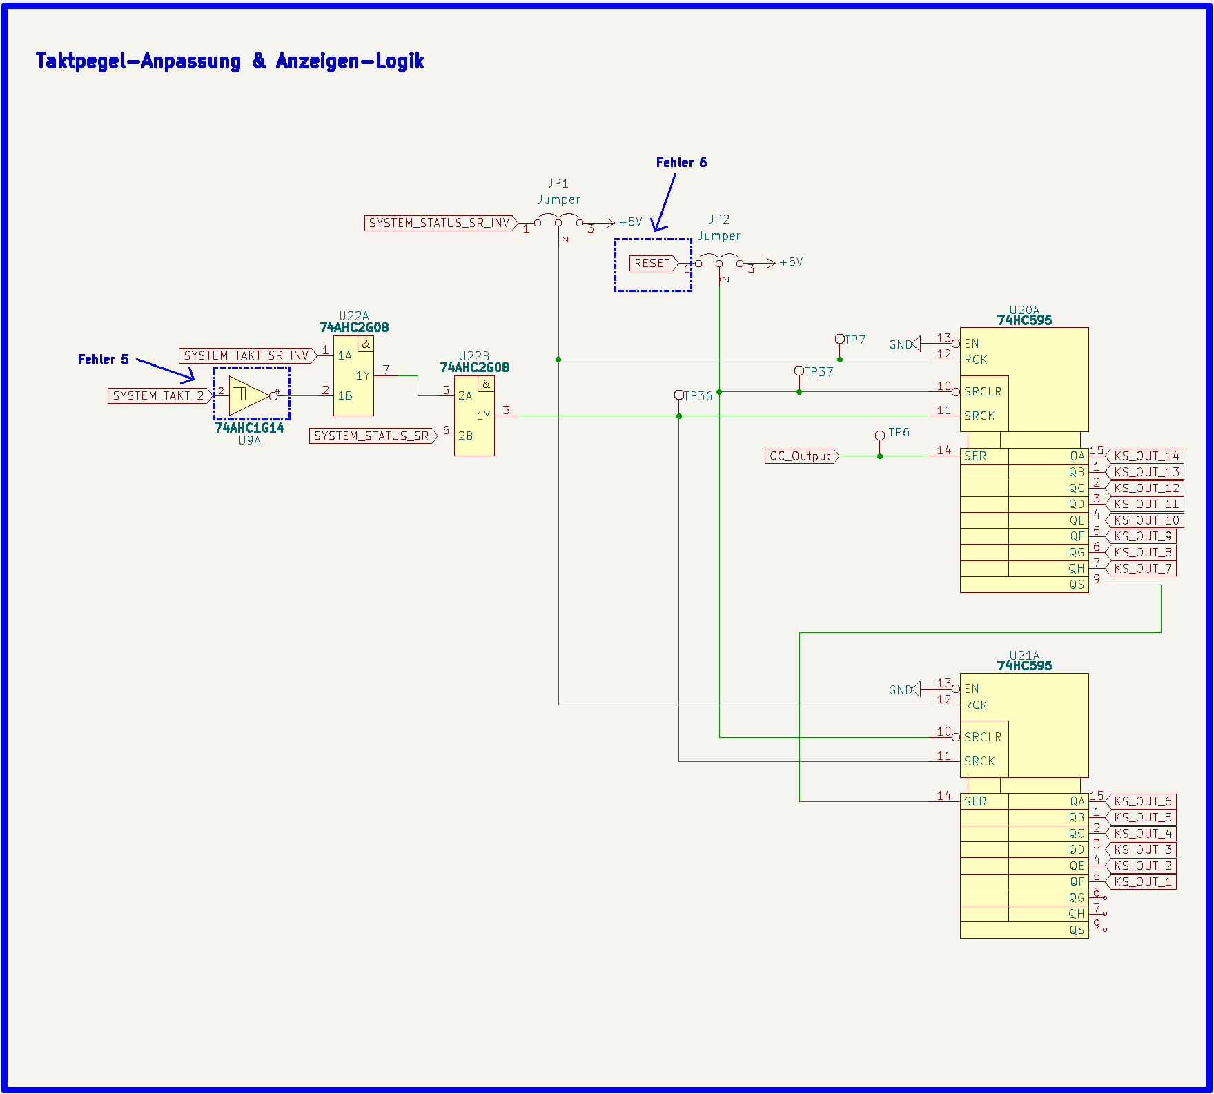
[picture p14: 03_Dokumente/02_Projektdokumentation/01_Dokumentation_Latex/Abschlussprojekt_LaTeX_002/Bilder/Anzeige-Logik.png]

\end{center}

Die Aufgabe der Schaltung ist es, die seriellen Widerstandsmessergebnisse parallel darzustellen. 
\\
Da das Schieberegister U20A die seriellen Daten mit steigender Taktflanke übernimmt und die Konstantstromquelle eine bestimmte Regelzeit zum Einstellen des Stromes benötigt, muss der Schiebetakt verzögert zur Messung erfolgen. Durch eine Teilung des NE555-Taktes kann nun durch Invertierung dieses Taktes eine Speicherung nach der Hälfte des Messzyklus der Konstantstromquelle erfolgen.
\\
Ist der Jumpermittelpunkt JP1 mit dem Label \glqq SYSTEM STATUS SR INV \grqq{} verbunden, so erfolgt die Ausgabe/Übergabe der Daten mit dem Ende der Messung. Ist der Jumper mit +5V verbunden, so werden die Daten sofort auf den Ausgang übertragen.
\\
Wird der Jumpermittelpunkt mit dem Label \glqq RESET \grqq{} verbunden, wird die Schaltung nicht funktionieren (Behandlung in Fehleranalyse). Eine Verbindung mit +5V führt zu keinem Rücksetzen.
\\
\\
U9A, U22A und U22B erzeugen den Takt für das Schieberegister. 

\newpage
\subsection{Anzeige}

\begin{center}
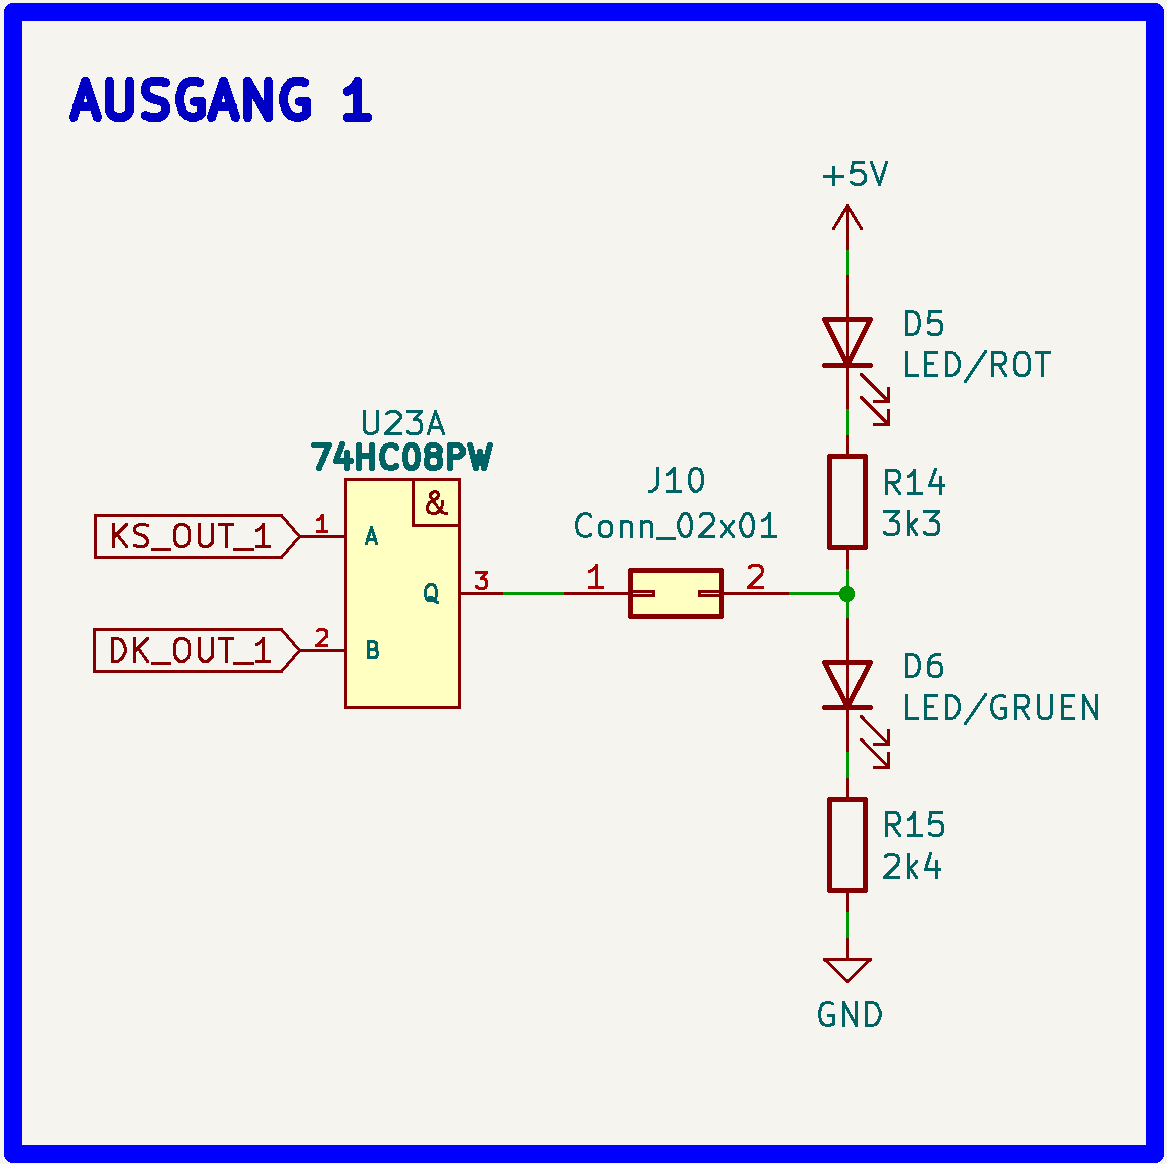
[picture p15: 03_Dokumente/02_Projektdokumentation/01_Dokumentation_Latex/Abschlussprojekt_LaTeX_002/Bilder/Anzeige.png]

\end{center}

Ist das Ergebnis beider Messungen positiv, so gibt das AND-Gatter U23A ein High-Signal aus. Die LED D6 leuchtet demnach grün. 
Ist das Ergebnis einer oder beider Messungen negativ, so liegt an dem Ausgang des AND-Gatter ein Low-Pegel. Die LED D5 leuchtet rot.
