Oszimilian/Kabeltester/03_Dokumente/02_Projektdokumentation/01_Dokumentation_Latex/Abschlussprojekt_LaTeX_002/BA_Ausgangssituation.tex

\section{Ausgangssituation}

\subsection{BMK-Entwicklung}
Neben der Tätigkeit als EMS-Dienstleister (Electronics Manufacturing Services), bietet die \glqq BMK Group GmbH  Co. KG\grqq{} auch eine kundenspezifische Elektronikentwicklung an. Die Entwicklung von Software, Hardware und Layout erfolgt unter dem Namen \glqq BMK-Entwicklung\grqq{} . 
Zu meinen Aufgaben in der BMK-Entwicklung gehört es, den Hardwareentwicklern und Softwareentwicklern bei ihren täglichen Aufgaben zur Seite zu stehen. 

\subsection{BMK-Testentwicklung / Testentwicklungslabor}
Eine weitere Dienstleistung der \glqq BMK Group\grqq{} ist die \glqq Testentwicklung\grqq{}. Im Haus gefertigte Baugruppen durchlaufen während des Fertigungsprozesses verschiedene Testschritte. Die Entwicklung von Testadaptern wird auf Kundenwunsch von der BMK-Testentwicklung übernommen. Standardisierte Testverfahren hierbei sind: ICT-Test (Integrated Circuit Test), FKT-Test (Funktionstest) und Boundary-Scan. Der Aufbau eines Testadapters wird dabei durch das Testentwicklungslabor übernommen. 

\subsection{Aktuelles Testverfahren für Programmierkabel sowie Flachbandkabel}
Das derzeitige Testverfahren für Programmierkabel in der Softwareentwicklung erfolgt nach dem \glqq Try and Error – Prinzip\grqq{} . Kann der Softwareentwickler mit dem BMK-IOT-Modul über einen Programmer keine Verbindung  aufbauen, so muss das Problem zeitaufwendig analysiert werden.
\\
Ist ein Testadapter des Testentwicklungslabors fertiggestellt, so wird dieser abschließend durch einen anderen Mitarbeiter überprüft. Dabei wird jede einzelne Leitung mit Hilfe eines Multimeters anhand des Schaltplanes überprüft. Flachbandkabel, welche Adapterkassette und Nadelbett miteinander verbinden, mussten sich bisher keinen Prüfungsprozess unterziehen.
