Oszimilian/Kabeltester/03_Dokumente/02_Projektdokumentation/01_Dokumentation_Latex/Abschlussprojekt_LaTeX_002/BA_Blockschaltplan.tex

\section{Blockschaltbild}
	
\begin{center}
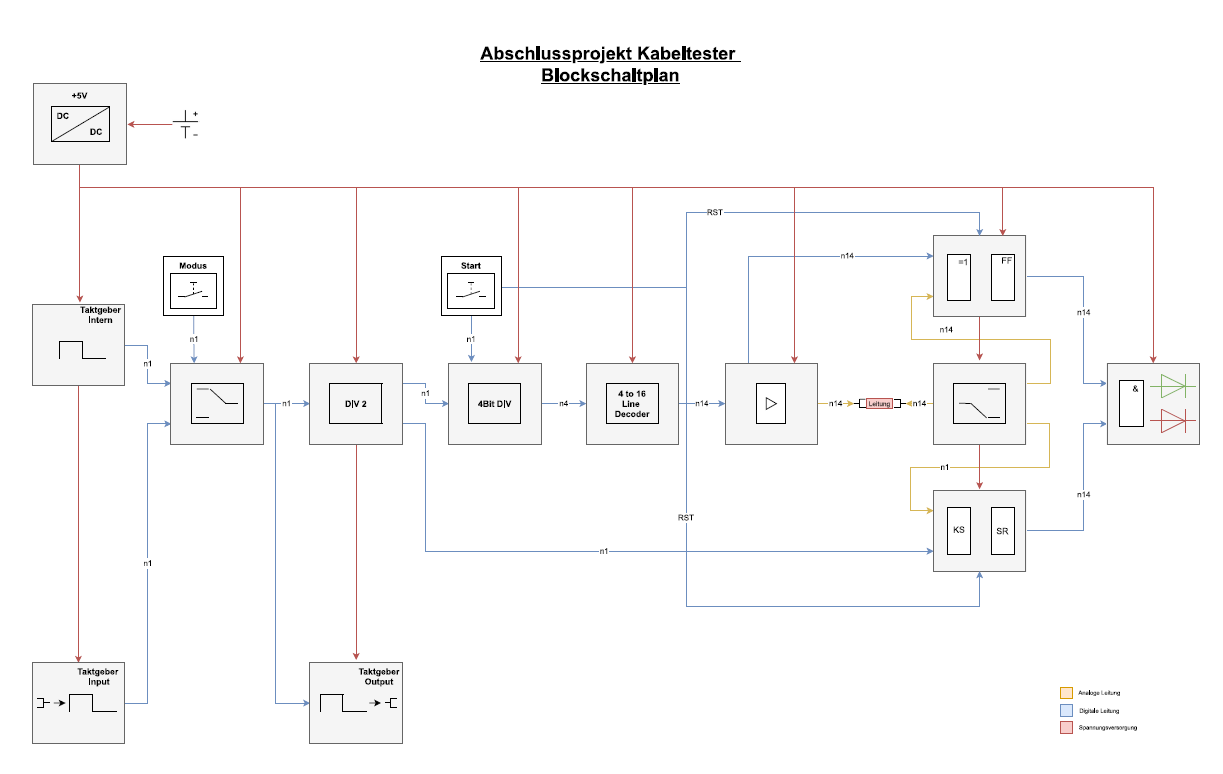
[picture p27: 03_Dokumente/02_Projektdokumentation/01_Dokumentation_Latex/Abschlussprojekt_LaTeX_002/Bilder/Blockschaltplan.png]

\end{center}

\newpage

\begin{center}
Die Kernfunktion der Messplatine wird in diesem Dokumentationsteil anhand des Blockschaltbildes erklärt. 
\end{center}

Die Versorgung der Platine wird aufgrund des niedrigen Verbrauches durch einen 9V Batterieblock erfolgen. Ein DC/DC-Wandler, wandelt dabei die Eingangsspannung auf einen 5V TTL Pegel. 
\\
\\
Ein interner sowie externen Takt kann Wahlweise als Systemtakt verwendet werden. Mit einem Taster wird zwischen den beiden Taktquellen umgeschaltet. Werden mehrere Messplatinen zusammengeschaltet, so wird der interne Takt der ersten Messplatine, als Takt für folgende Platinen verwendet. 
\\
\\
Um den Systemtakt auf mehreren hintereinander geschalteten Messplatinen verwenden zu können, wird dieser über einen Stecker herausgeführt.
\\
\\
Der Systemtakt wird nun durch den Faktor zwei geteilt und bildet den Messtakt. Synchron zu diesen Takt werden die einzelnen Adern geprüft.
\\
\\
Um jede einzelne Ader nacheinander messen zu können, wird mit Hilfe des Messtaktes durch einen 4 Bit Zählerbaustein von 0 bis 15 hochgezählt. Über einen Taster wird der Zählvorgang gestartet.
\\
\\
Der 4Bit Decoder schaltet dabei für jeden möglichen Zählerstand den passenden Ausgang auf High. Läuft keine Messung, so weisen alle Ausgänge ein Low-Pegel auf. 
\\
\\
Da bei der Konstantstrommessung ein Strom bis zu 100mA durch das Kabel fließen kann, steuert der 4 Bit Decoder mit seinen Ausgängen die Leistungsstufen an.
\\
\\
Zwischen den Leistungsstufen und dem Analogschalter wird das zu messende Kabel  (Ader) gesteckt. 
\\
\\
Der Analogschalter ist dafür verantwortlich, zwischen der Konstantstrommessung, der Kurzschlussmessung, sowie der Durchgangsmessung während der Prüfung umzuschalten. 
\\
\\
Während der Pausenzeit des Messtaktes, wird ein konstanter Strom durch das Kabel fließen. Mit Hilfe des Spannungsfalls über den strombegrenzenden MOSFET der Konstantstromquelle kann indirekt der Kabelwiderstand bestimmt werden. Das serielle Ergebnis dieser  Messung wird durch ein Schieberegister parallel ausgegeben. Da die Konstantstromquelle bei jedem Kabel den Strom neu regeln muss, wird durch den zugeführten Systemtakt erst nach der Hälfte der Messzeit das Ergebnis via Schiebetakt übernommen.
\\
\\
Während der Impulszeit des Messtaktes, wird das Kabel auf Kurzschluss sowie Durchgängigkeit überprüft. 
\\
\\
Liefern beide Messungen einer Ader ein High-Signal, leuchtet eine grüne LED. Liefert eine oder beide Messungen ein Low-Signal, leuchtet die rote LED.
