Oszimilian/Kabeltester/03_Dokumente/02_Projektdokumentation/02_Teilbereiche/09_Sonstiges/Leitungswiderstand/BA_Kabelanalyse.tex

\documentclass[a4paper,11pt]{scrartcl}

\usepackage[utf8]{inputenc}
\usepackage[ngerman]{babel}
\usepackage[T1]{fontenc}
\usepackage{amsmath}
\usepackage{graphicx}
\usepackage{tabularx}
\usepackage[a4paper, left=2cm, right=2cm, top=2.8cm, bottom=2.8cm]{geometry}
\usepackage{tikz}   
\usepackage[scaled]{helvet}
\usepackage{tabto} 
\usepackage{fancyhdr}
\usepackage{multirow}

\renewcommand*{\familydefault}{\sfdefault}

\pagestyle{fancy}

\setkomafont{section}{\huge}
\setkomafont{subsection}{\Large}

\lhead{Maximilian Hoffmann}
\chead{Betrieblicher Auftrag \\ \textbf{Kabeltester}}
\rhead{}

\begin{document}

\section{Analyse Leitungswiderstandes}

Ein weiterer Teilbereich dieser Dokumentation, ist die theoretische Analyse des maximal zulässigen Leitungswiderstandes eines Programmierkabels. Dabei wurde mit Hilfe des Simulationsprogramm \glqq LT-Spice\grqq{} ein Ersatzschaltbild eines typischen Programmieraufbaus erstellt.\\

\begin{center}
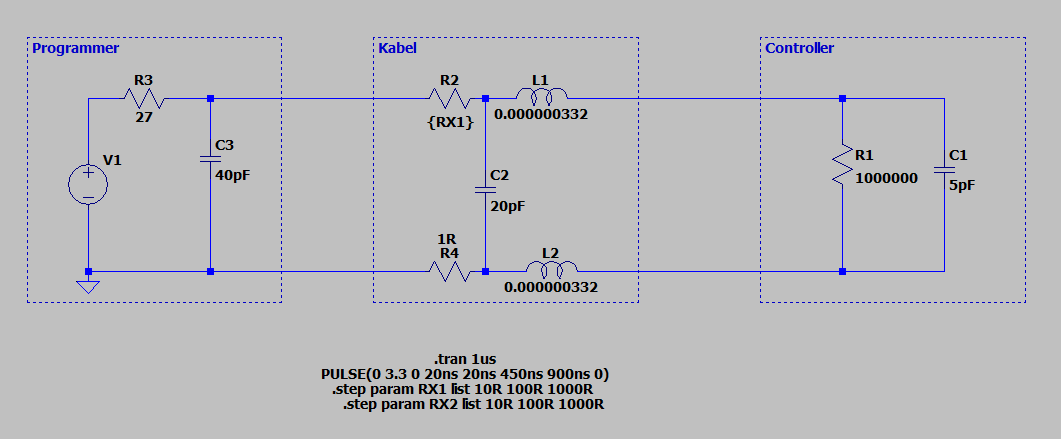
[picture p28: 03_Dokumente/02_Projektdokumentation/02_Teilbereiche/09_Sonstiges/Leitungswiderstand/Bilder/LTC-SCHALTBILD.png]

\end{center}

Anhand der Datenblätter, welche die Eingangs und Ausgangs Eigenschaften von Controller und Programmer der Firma ST beschreiben, wurden Ersatzschaltbilder erstellt. Die passenden Induktivitäten und Kapazitäten des Programmierkabels wurden mit Hilfe eines Online-Rechner für ein 20cm Kabel berechnet.
\\
\\
Um den Programmiervorgang simulieren zu können gibt die Spannungsquelle V1 ein Rechtecksignal mit ca. 1,1MHz aus. Dies entspricht laut Datenblatt den maximalen Programmiertakt eines ST-Link Programmer. Die zeitliche Dauer einer Signalflanke wurde dabei mit ca.20ns kalkuliert.
\\
\\
Bei der Betrachtung der Signalflanken über Programmer und Controller, mit 10R, 100R und 1000R Leitungswiderstand, wurde mir persönlich nicht sofort klar, warum ein geringer Leitungswiderstand so wichtig für den Programmiervorgang ist. 

\begin{center}
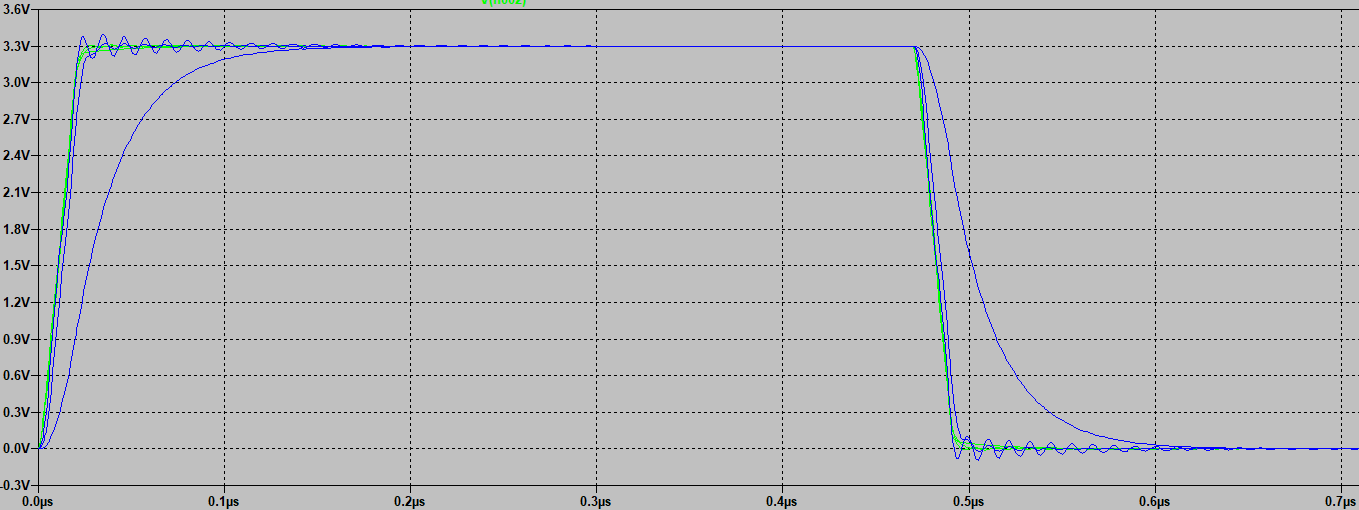
[picture p29: 03_Dokumente/02_Projektdokumentation/02_Teilbereiche/09_Sonstiges/Leitungswiderstand/Bilder/LTC-SIGNALVERLAUF1.png]

\end{center}

\newpage

Ein differenzielle Messung zwischen Programmer und Controller mit 10R, 100R und 1000R Leitungswiderstand  zeigt den Spannungsunterschied zwischen den beiden Punkten zur selben Zeit. Hierbei zeigt sich, dass während einer Signalflanke kurzzeitig zwischen Programmer und Kontroller einer Potentialunterschied auftritt. Dieser wird mit steigenden Leitungswiderstand größer. Der kleinste Ausbruch tritt bei einem Leitungswiderstand von 10R auf.

\begin{center}
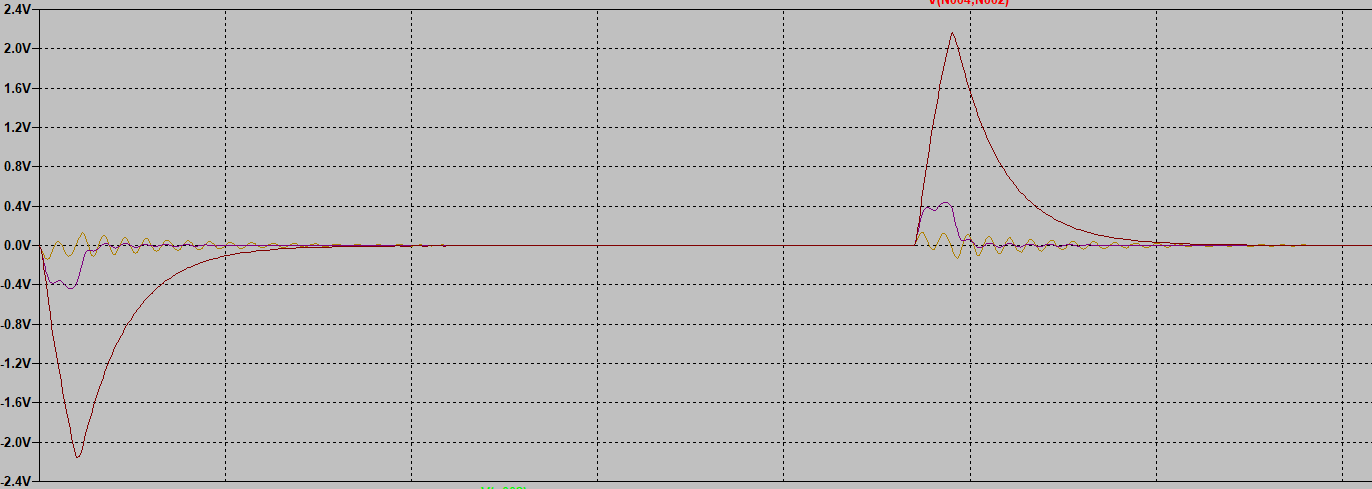
[picture p30: 03_Dokumente/02_Projektdokumentation/02_Teilbereiche/09_Sonstiges/Leitungswiderstand/Bilder/LTC-SIGNALVERLAUF2.png]

\end{center}

Hierbei handelt es sich um parasitäre Effekte. 
\\
Sie sind unerwünscht und entstehen durch die physikalischen Eigenschaften der Bauelemente. Besonders bei hochfrequenten Anwendungen stellen diese Effekte ein großes Problem dar.
\\
Durch elektrische und magnetische Felder zwischen zwei Punkten, können andere Leitungen gestört werden. Dabei kann es zu Datenübertragungsfehlern kommen.
\\
\\
Aus meiner Simulation geht hervor, das die parasitären Effekte bis zu einem Leitungswiderstand von 10R vernachlässigbar sind. Das von mir entwickelte Prüfgerät wurde daher auf einen Grenzwert von 5R eingestellt. 

\end{document}
