Oszimilian/Kabeltester/03_Dokumente/02_Projektdokumentation/01_Dokumentation_Latex/Abschlussprojekt_LaTeX_002/Extern/Lastenheft_LaTeX/BA_Lastenheft.tex

\documentclass[a4paper,11pt]{scrartcl}

\usepackage[utf8]{inputenc}
\usepackage[ngerman]{babel}
\usepackage[T1]{fontenc}
\usepackage{amsmath}
\usepackage{graphicx}
\usepackage{tabularx}
\usepackage[a4paper, left=2cm, right=2cm, top=2.5cm, bottom=2.5cm]{geometry}
\usepackage{tikz}   
%\usetikzlibrary{calc}

%defaultfam

%\usepackage[light]{montserrat}
%\usepackage{libertine}
\usepackage[scaled]{helvet}
%\usepackage[scaled]{uarial}

\renewcommand*{\familydefault}{\sfdefault}

\usepackage{tabto} 

\usepackage{fancyhdr}
\pagestyle{fancy}
\lhead{Robert Schulz}
\chead{Betrieblicher Auftrag \\ \textbf{Kabeltester}}
\rhead{}

\begin{document}

\begin{center}
	\begin{huge}
	\textcolor{white}{\tiny{Platzhalter wenn ein Kapitel auf einer neuen Seite beginnt\\}}
	\textbf{Lastenheft}
	\end{huge}
\end{center}

\textbf{Auftraggeber:}
Robert Schulz, BMK-Entwicklung

\textbf{Auftragnehmer:}
Maximilian Hoffmann, Entwicklung Labor

\section{Zielsetzung}

\begin{itemize}
	\item{Entwicklung eines Prototypen zum prüfen von Flachbandkabel und BMK-Interne standardisierter Programmierkabel.}
\end{itemize}

\section{Anwendungsgebiet}

\begin{itemize}
	\item{BMK-Testentwicklungslabor: Prüfung der Flachbandkabel, welche Adapterkassette und \\ Nadelbrett miteinander verbinden.}
	
	\item{BMK-Entwicklung: Prüfung standardisierter Programmierkabel, für STMicroelectronics und \\ Texas Instruments Mikrocontroller.}
\end{itemize}

\section{Technische Anforderungen}

\begin{itemize}
	\item{Kurzschluss- und Durchgangsprüfung.}
	\item{Prüfung auf Ohmschen Widerstand der Adern.}
	\item{Minimale Anzahl der parallelen Leitungen pro Messvorgang: 10 Stk.}
	\item{Versorgung durch Akku oder Batteriebetrieb.}
	\item{Einfache Erweiterung der zu testenden Leitungen pro Kabel.}
\end{itemize}

\section{Sonstige Anforderungen}

\begin{itemize}
	\item{Analyse des maximal zulässigen Leitungswiderstandes während des Programmiervorganges.}
	\item{Lebenszeitberechnung im Akku/ Batteriebetrieb.}
	\item{Bedienungsanleitung für den allgemeinen Gebrauch des Prüfgerätes.}	
\end{itemize}

\section{Rahmenbedingungen}

\begin{itemize}
	\item{Abgabetermin Dokumentation IHK:	\tab	21.Mai 2021}	
	
	\item{Abgabetermin Prototyp BMK-Entwicklung:	\tab	14.Mai 2021}	
\end{itemize}

\vspace{1,5cm}
\begin{tabularx}{\textwidth}[b]{ p{5cm} } \cline{1-1} 
Ort, Datum
\end{tabularx}

\vspace{1,5cm}
\begin{tabularx}{\textwidth}[b]{ p{5cm} X p{5cm} } \cline{1-1} \cline{3-3} 
Unterschrift Auftraggeber & & Unterschrift Auftragnehmer
\end{tabularx}

\end{document}
