Oszimilian/Kabeltester/03_Dokumente/02_Projektdokumentation/01_Dokumentation_Latex/Abschlussprojekt_LaTeX_002/Extern/Übergabe/BA_Uebergabe.tex

\documentclass[a4paper,11pt]{scrartcl}

\usepackage[utf8]{inputenc}
\usepackage[ngerman]{babel}
\usepackage[T1]{fontenc}
\usepackage{amsmath}
\usepackage{graphicx}
\usepackage{tabularx}
\usepackage[a4paper, left=2cm, right=2cm, top=2.5cm, bottom=2.5cm]{geometry}
\usepackage{tikz}   
%\usetikzlibrary{calc}

%defaultfam

%\usepackage[light]{montserrat}
%\usepackage{libertine}
\usepackage[scaled]{helvet}
%\usepackage[scaled]{uarial}

\renewcommand*{\familydefault}{\sfdefault}

\usepackage{tabto} 

\usepackage{fancyhdr}
\pagestyle{fancy}
\lhead{Maximilian Hoffmann}
\chead{Betrieblicher Auftrag \\ \textbf{Kabeltester}}
\rhead{}

\begin{document}
\begin{center}
	\begin{huge}
	\textcolor{white}{\tiny{Platzhalter wenn ein Kapitel auf einer neuen Seite beginnt\\}}
	\textbf{Übergabeprotokoll}
	\end{huge}
\end{center}

\textbf{Auftraggeber:}\\
Robert Schulz\\
BMK Group GmbH Co. KG\\
Entwicklung \\

\vspace{0,5cm}

\textbf{Auftragsnehmer:}\\
Maximilian Hoffmann\\
BMK Group GmbH Co. KG\\
Entwicklung Labor

\section{Übergabe}

\begin{itemize}
	\item{Übergabedatum: 14.5.2021}
	
	\item{Übergabeort: BMK-Entwicklung Labor}
\end{itemize}

\section{Produktvorführung}

\begin{itemize}
	\item{Vorführung der verschiedenen Funktionen.}
	
	\item{Verschiedene Messungen mit dem Oszilloskop durchgeführt.}
\end{itemize}

\section{Fazit}

\begin{itemize}
	\item{Allgemeines Fazit ist von Seiten des Auftraggebers sehr positiv ausgefallen.}
	
	\item{Der Auftraggeber hat die Ungenauigkeit der Widerstandsauswertung bemängelt. Eine Verbesserung dieses Schaltungsteils ist bis zum 28.5.2021 gewünscht.}
	
	\item{Nach dem 28.5.2021 entscheidet der Auftraggeber, ob eine Weiterentwicklung der Schaltung durchgeführt werden soll.}
\end{itemize}

\vspace{2,5cm}
\begin{tabularx}{\textwidth}[b]{ p{5cm} } \cline{1-1} 
Ort, Datum
\end{tabularx}

\vspace{1,5cm}
\begin{tabularx}{\textwidth}[b]{ p{5cm} X p{5cm} } \cline{1-1} \cline{3-3} 
Unterschrift Auftraggeber & & Unterschrift Auftragnehmer
\end{tabularx}

\end{document}
