Oszimilian/Kabeltester/03_Dokumente/02_Projektdokumentation/02_Teilbereiche/03_Auftragsplanung/Teilaufträge/Teilauftrag_Bestückung/BA_Teilauftrag.tex

\documentclass[a4paper,11pt]{scrartcl}

\usepackage[utf8]{inputenc}
\usepackage[ngerman]{babel}
\usepackage[T1]{fontenc}
\usepackage{amsmath}
\usepackage{graphicx}
\usepackage{tabularx}
\usepackage[a4paper, left=2cm, right=2cm, top=2.8cm, bottom=2.8cm]{geometry}
\usepackage{tikz}   
\usepackage[scaled]{helvet}
\usepackage{tabto} 
\usepackage{fancyhdr}
\usepackage{multirow}

\renewcommand*{\familydefault}{\sfdefault}

\pagestyle{fancy}

\setkomafont{section}{\huge}
\setkomafont{subsection}{\Large}

\lhead{Maximilian Hoffmann}
\chead{Betrieblicher Auftrag \\ \textbf{Kabeltester}}
\rhead{}

\begin{document}

\begin{center}
	\begin{huge}
	\textcolor{white}{\tiny{Platzhalter wenn ein Kapitel auf einer neuen Seite beginnt\\}}
	\textbf{Teilauftrag Bestückung}
	\end{huge}
\end{center}

\textbf{Auftraggeber}	\\
Maximilian Hoffmann		\\
BMK Group GmbH Co.KG	\\
Entwicklung Labor		\\
\\

\textbf{Auftragsnehmer}	\\
Andreas Hild	\\
BMK Group GmbH Co.KG	\\
Entwicklung Labor		\\

\section{Beschreibung}
Aufbau der Prototypen nach Bestückungsplan. Der Aufbau des ersten Prototyps erfolgt schrittweise. Die einzelnen Teilschaltungen werden nacheinander durch den Auftraggeber in Betrieb genommen. 

\section{Anforderungen}

\begin{itemize}
	\item{Zu bestücken: 2 Stück.}
	
	\item{SMD und THT Bestückung.}
	
	\item{Bestückung von U19 (BGA) in der Zentralen Reparatur.}
\end{itemize}

\section{Anlagen}

\begin{itemize}
	\item{Bestückungsplan}
	
	\item{Bauteile}
\end{itemize}

\vspace{1,5cm}
\begin{tabularx}{\textwidth}[b]{ p{5cm} } \cline{1-1} 
Ort, Datum
\end{tabularx}

\vspace{1,5cm}
\begin{tabularx}{\textwidth}[b]{ p{5cm} X p{5cm} } \cline{1-1} \cline{3-3} 
Unterschrift Auftraggeber & & Unterschrift Auftragnehmer
\end{tabularx}

\end{document}
