Oszimilian/Kabeltester/03_Dokumente/02_Projektdokumentation/02_Teilbereiche/02_Ausgangssituation/Ausgangssituation.odt

Beschreibung der Ausgangssituation

BMK-Entwicklung:

Neben der Tätigkeit als EMS-Dienstleister (Electronics Manufacturing Services), bietet die „BMK Group GmbH & Co. KG“ auch eine kundenspezifische Elektronikentwicklung an. Die Entwicklung von Software, Hardware und Layout erfolgt unter dem Namen „BMK-Entwicklung“.

Zu meinen Aufgaben in der BMK-Entwicklung gehört es, den Hardwareentwicklern und Softwareentwicklern bei ihren täglichen Aufgaben bei Seite zu stehen.

BMK-Testentwicklung / Testentwicklungslabor:

Eine weitere Dienstleistung der „BMK Group“ ist die „Testentwicklung“. Im Haus gefertigte Baugruppen, durchlaufen während des Fertigungsprozesses verschiedene Testschritte. Die Entwicklung von Testadaptern, wird auf Kundenwunsch von der BMK-Testentwicklung übernommen. Standardisierte Testverfahren hierbei sind: ICT-Test (Integrated Circuit Test), FKT-Test (Funktionstest) und Boundary-Scan. Der Aufbau eines Testadapters wird dabei durch das Testentwicklungslabor übernommen.

Aktuelles Testverfahren für Programmierkabel sowie Flachbandkabel

Das derzeitige Testverfahren für Programmierkabel in der Softwareentwicklung erfolgt nach dem „Try and Error – Prinzip“. Kann der Softwareentwickler keine Verbindung mit den gefertigten Programmierkabeln zwischen Controller und Programer aufbauen, so muss das Problem zeitaufwendig analysiert werden.

Ist ein Testadapter des Testentwicklungslabors fertiggestellt, so wird dieser abschließend durch einen anderen Mitarbeiter überprüft. Dabei wird jede einzelne Leitung mit Hilfe eines Multimeters anhand des Schaltplanes überprüft. Flachbandkabel, welche Adapterkassette und Nadelbett miteinander verbinden, mussten sich bisher keinen Prüfungsprozess unterziehen.
