Oszimilian/Kabeltester/03_Dokumente/02_Projektdokumentation/02_Teilbereiche/05_Inbetriebnahme/Inbetriebnahme_LaTeX/BA_Inbetriebnahme.pdf

Maximilian Hoffmann

Betrieblicher Auftrag
Kabeltester

# 1 Inbetriebname

Die Inbetriebnahme der Schaltung erfolgt blockweise. Um gegebenenfalls Fehler in der Schaltung analysieren zu können, werden die einzelnen Schaltungsteile nacheinander aufgebaut und in betrieb genommen. Die Funktion der zu prüfenden Schaltungsteile wird oberhalb der Tabelle in Stichpunkten erläutert. Bei fehlerhafter Funktion wird diese in der Sektion "Fehleranalyse"behandelt.

## 1.1 Spannungsversorgung

- Spannungen sowie Ströme sind hierbei mit einem Multimeter zu messen.
- Die Funktion der "Meldeleuchte Sicherung"wird durch das entnehmen der Sicherung aus dem Sockel geprüft. Leuchtet die LED D33 auf, so ist die Funktion dieses Schaltungsteiles gegeben.
- Die Funktion des Verpolungsschutz wird durch das Anlegen einer verpolten Spannung geprüft. Dabei sollte die Strombegrenzung des Labornetzteiles auf ca. 5mA eingestellt sein. Geht das Netzteil bei diesem Test nicht in die Strombegrenzung, so ist die Funktion dieses Schaltungsteiles gegeben.
| | i.o | n.i.o
Stromaufnahme | IG: | [ ] | [ ]

Spannungen

U0: | [ ] | [ ]
UT P8: | [ ] | [ ]
UT P9: | [ ] | [ ]

Funktionen

Meldeleuchte Sicherung: | [ ] | [ ]
Verpolungsschutz: | [ ] | [ ]

## 1.2 Taktgeber

- Überprüfung der Systemtakte mithilfe eines Logikanalysators.
- Über das Poti soll an TP24 eine Frequenz von 8,5Hz (+-10%) mit einem Tastgrad von 0,5 eingestellt werden.
- Durch betätigen von SW2 kann der Pegel von TP26 gewechselt werden, was durch das optische Signal von D1 oder D2 erkennbar wird.
- Die Aufgabe von U14 ist die Signalentprellung des Tasters SW2. Diese Funktion wird durch das oszillieren der Signale U14 Pin 1 und TP25 überprüft. Die Kippzeit des Monoflop’s soll ca. 500ms betragen.
- Leuchtet D2 (Grün), so soll an TP27 die Frequenz von TP24 zu messen sein. Die zu messende Frequenz von TP28 soll dabei die Hälfte von TP27 betragen. Leuchtet D1 (Rot), so soll (sofern kein Verbund aus zwei Messplatinen besteht) keine Frequenz an TP27 und TP28 zu messen sein.
| | i.o | n.i.o
Stromaufnahme | IG: | [ ] | [ ]

Frequenz NE555

fT P24: | [ ] | [ ]
gT P24: | [ ] | [ ]

Taktumschaltung

Taktumschaltung: | [ ] | [ ]
tKippzeit: | [ ] | [ ]

Funktionen

Funktion wenn D2 (Grün) leuchtet: | [ ] | [ ]
fT P28: | [ ] | [ ]
Funktion wenn D1 (ROT) leuchtet: | [ ] | [ ]

## 1.3 DEZ-Zähler

- Wenn die LED D2 (Grün) leuchtet, kann durch Betätigung von SW1 (START) der Messvorgang gestartet werden. Dies macht sich durch das Lauflicht (bestehend aus D39, D40, D41, D42) bemerkbar.
- Nach einer Zeit von ca. 3s (Messbar durch Impulszeit von TP20) soll das ganze System durch Betätigung von SW1 erneut gestartet werden können.
- Im Einschaltmoment soll ein verspäteter Nadelimpuls für das korrekte Setzen(default-states) der Schaltung am TP23 gemessen werden können.
- Leuchtet die LED D1 (Rot), so soll ein Starten der Messung durch Betätigung von SW1 (START) nicht möglich sein.
| | i.o | n.i.o
Stromaufnahme | IG: | [ ] | [ ]

Start Messung

LED D2 und SW1 -> Messung Startet | [ ] | [ ]
tT estzeit: | [ ] | [ ]

Nadelimpuls

| tDelay: | [ ] | [ ]
| tin: | [ ] | [ ]
Tastensperre | LED D1 und SW1 -> Messung Startet nicht | [ ] | [ ]

## 1.4 Leitungstreiber und Umschaltung

- Bei einem High-Signal an TP10 muss das 5V Potenzial auf den Pin 1 von J6 durchgeschaltet werden. Diese Messung muss mit einem Oszilloskop erfolgen, um Pegelschwankungen eindeutig erkennen zu können.
- Nach der Hälfte des High-Signals an TP10 muss auch ein High-Signal an TP11 gemessen werden können.
- Um die Funktion des Analogschalters bestätigen zu können, muss bei gestecktem Jumper (J6) ein 5V Signal für tT P10
2

an TP5 und TP32 anliegen.

| | i.o | n.i.o
Stromaufnahme | IG: | [ ] | [ ]

Messspannung

tT P10: | [ ] | [ ]
UJ6: | [ ] | [ ]

Umschaltsignal

tdelay−T P11 | [ ] | [ ]
| tT P11: | [ ] | [ ]
Umschaltung | Umschaltung von U38A: | [ ] | [ ]

## 1.5 Durchgangsprüfung und Kurzschlussmessung

- Analyse des Reset-Impulses, welcher die Schaltung in einen einheitlichen Startzustand bringt.
- Überprüfung der Nadelimpulsunterdrückung durch gleichzeitiges messen an TP32 und Pin 6 von U30.
| | i.o | n.i.o
Stromaufnahme | IG: | [ ] | [ ]
Reset-Impuls | tRST : | [ ] | [ ]

Nadel-Impuls

tT P32Nadel−Impuls : | [ ] | [ ]
UP in6U30Nadel−Impuls : | [ ] | [ ]

## 1.6 Konstantstrommessung

- Funktion der Konstantstromquelle prüfen durch Stecken eines Jumpers auf J6 und Starten eines Messvorganges. Wenn RV2 und RV3 in Mittelstellung sind, dann ist an TP 6 ein High-Impuls zu erwarten.
- Prüfen, ob die richtigen Takte bzw. Steuersignale an dem Schieberegister anliegen.
- Prüftabelle mit verschiedenen Kabelwiderständen und den dazugehörigen rechnerischen Werten anlegen.
| | i.o | n.i.o
Stromaufnahme | IG: | [ ] | [ ]
Konstantstromquelle | Funktion der Konstantstromquelle: | [ ] | [ ]
Schieberegister Takte | Funktion der Steuersignale: | [ ] | [ ]

Bemerkung:
Die Inbetriebnahme dieses Schaltungsteiles hat auf Grund von verschiedenen Fehler einen größeren Zeitraum, als geplant eingenommen. Im Kapitel Fehleranalyse wird zwar auf die Fehler und deren Behebung eingegangen, aus zeitlichen Gründen ist dieser Teil aber kein offizieller Teil meines betrieblichen Auftrages.
