Oszimilian/Kabeltester/03_Dokumente/02_Projektdokumentation/02_Teilbereiche/04_Auftragsdurchführung/Schaltplan/BA_Auftragsdurchführung.pdf

Maximilian Hoffmann

Betrieblicher Auftrag
Kabeltester

# 1 Schaltplanentwurf

## 1.1 Versorgung

### 1.1.1 Schutzbeschaltung


Um die Schaltung zu schützen, wurde auf eine umfangreiche Eingangsschutzbeschaltung gesetzt. Die Versorgungsspannung kann dabei zweipolig durch den Schalter „Power ON/OFF SW3 “ abgeschaltet werden.

Die mittelträge Sicherung F1, ist für den Überstromschutz verantwortlich. Löst diese aus, so fließt ein Strom über R42 und D33. Dabei wird der gesamte Stromfluss in der Schaltung auf ein Maximum von 2mA begrenzt. Als Ergebnis leuchtet D33 rot.
Im Normalbetrieb werden R42 und D33 durch den ohmschen Widerstand der Sicherung F1 (12R) überbrückt.

Um den Eingang des DC/DC Wandlers vor Überspannungsspitzen zu schützen, kommt eine 10V TVS Diode zum Einsatz. Die Eingangsspannung dieser Schaltung wird dadurch auf ein Spannungsmaximum von 10V begrenzt.

Da es bei einer Batterieanwendung sehr schnell zu einer ungewollten Verpolung der Anschlüsse kommen kann, wird ein Verpolungsschutz benötigt.
Liegt eine korrekt gepolte Spannung an, so fließt der Strom durch die Z-Diode D35 und den strombegrenzenden Widerstand R43. Die über die Z-Diode abfallende Spannung von 5,1V, liegt somit auch an den Anschlüssen „Source und Gate “ des P-Channel MOSFET Q2 an. In diesem Fall, liegt eine um ca. 5V negativere Spannung an Gate gegenüber Source an. Die Drain-Source Strecke leitet und es kann Strom fließen.
Wird die Versorgungsspannung verpolt, so fließt der Strom durch den Widerstand R43 und durch die Diode D35. Die Diode D35 befindet sich dabei in Durchlassrichtung und besitzt somit die Eigenschaften einer Si-Diode. Die Spannung an dem Gate ist dabei um ca. 5V positiver gegenüber Source. Der P-Channel MOSFET sperrt und unterbindet einen Stromfluss.

### 1.1.2 DC/DC Wandler

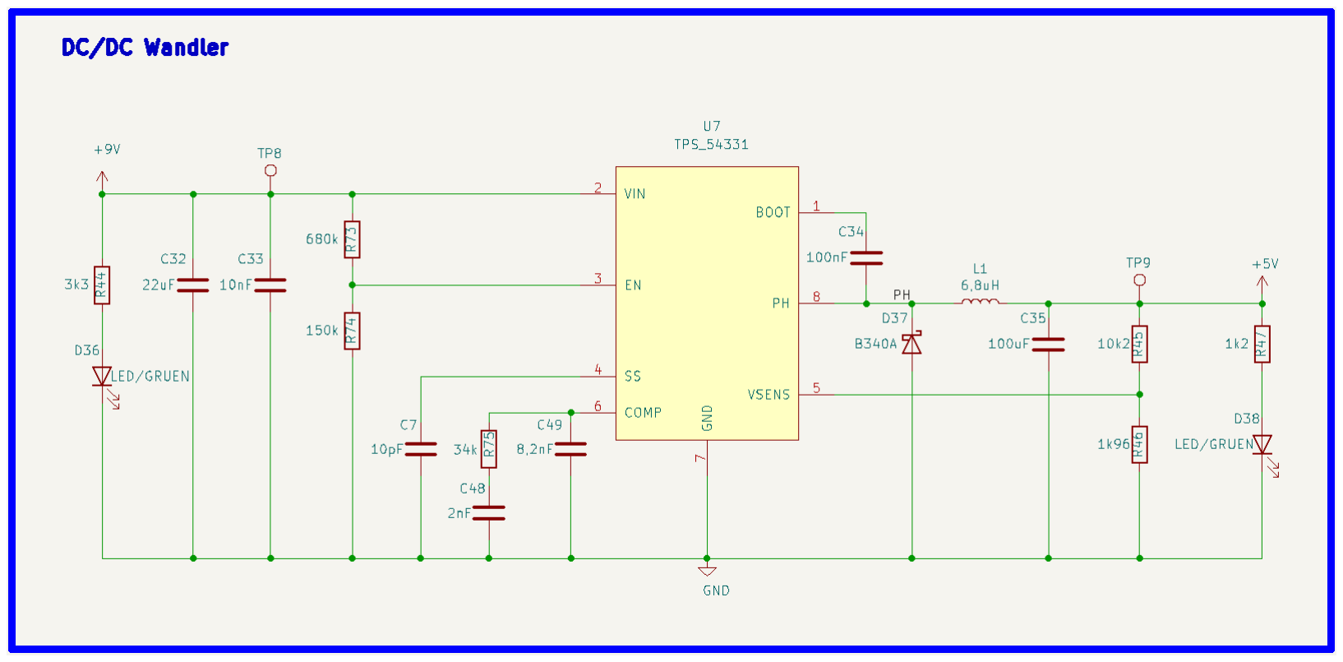
[picture p49: figure]

Bei der Auswahl des DC/DC Wandlers wurde auf die Verfügbarkeit bei BMK im Haus geachtet.
Die Dimensionierung der externen Bauelemente wurde mit Hilfe des „Texas Instruments Power Designer“ Web-Tool durchgeführt.
Die grünen LED’s D36 und D38 sorgen für ein optisches Feedback der Versorgungsspannungen. Allgemein wurde der Wandler für eine Ausgangsspannung von +5V und einen Ausgangsstrom von ca. 1,5A dimensioniert. Mit den Widerständen R73 und R74 kann der Schaltregler bei Über/-Unterspannung abschalten. Dafür wird eine oberer sowie untere Schaltschwelle berechnet.

R73 =

V∆
3uA =

2V
3uA = 666k ⇒ 680k | (1)
R74 = | 1, 25V
V s − 1, 25V
R73

+ 1uA

=

1, 25V
8V − 1, 25V
680k

+ 1uA

= 126k ⇒ 150k | (2)

VOUT = VREF + (R45
R46

+ 1) = 0, 8V + (¹⁰, 2k
1, 96k
+ 1) = 4, 96V | (3)

## 1.2 NE555 Taktgeber

### 1.2.1 Takt


Als Taktgeber kommt der „NE555 “ zum Einsatz. Dieser wird als astabile Kippstufe betrieben. Mit Hilfe der Diode D43 kommt eis zu einem symetrischen Verhältnis des Tastgrad. Über das Poti (Connector) J3 soll die Ausgangsfrequenz auf ca. 10Hz eingestellt werden können.

Im Einschaltmoment ist C9 entladen. Somit liegt das Signal am Triggereingang (PIN 2) unterhalb von 1/3 V CC. Das interne FlipFlop wird gesetzt und der Ausgang (PIN 3) erfährt einen High-Pegel. Der Kondensator C9 lädt sich nun über R2, J3 und D43 auf. Der Ladevorgang hält so lange an, bis das Spannungspotential an Pin 6 (Threshold) einen höheren Wert als 2
3

V CC aufweist. Das interne FlipFlop’s wird zurückgesetzt und der Ausgang schaltet auf Low. Der Kondensator C9 entlädt sich nun über R72 und den (auf GND durchgeschaltenen) Pin 7 (Discharge). Hat sich der Kondensator nun wieder auf ein Spannungspotential unterhalb von 1
3

entladen, so wird er Ausgang wieder gesetzt und der Entladevorgang über Pin 7 unterbunden. Dieser Vorgang wiederholt sich solange eine Versorgungsspannung anliegt.

fOUT =

1
0, 69 ∗ R2 ∗ C9 + 0, 69 ∗ (R72 + RJ3) ∗ C9

=

1
0, 69 ∗ 18k ∗ 3, 9uF ∗ 2

= 10, 3Hz (4)

### 1.2.2 Taktumschaltung


Funktionsbeschreibung LTC6993 U14
Das IC „LTC6993“ ist eine Monostabile Kippstufe mit einer einstellbaren Pulsweite von 1us – 33,6s. Dabei wird bei einem Impuls über den Trigger-Eingang (Pin 1), der Ausgangszustand für eine einstellbare Zeit gespeichert bevor der Ausgang wieder in den stabilen Zustand zurück kippt. Über die Außenbeschaltung der Pin’s „DIV“ und „SET“ kann die Pulsweite (Kipp-Zeit) konfiguriert werden. Der Pin „DIV“ ist dabei intern mit einem 4 Bit A/D-Wandler beschalten. Dieser führt drei seiner Datenleitungen einem Taktteiler zu. Dieser Taktteiler ist dadurch zwischen 1 und 2 097 152 einstellbar. Die vierte Datenleitung (MSB) übergibt ihren Zustand dem Block „Output Polarity“. Dieser bestimmt den stabilen Ausgangspegel des Monoflops. Ein Widerstand zwischen GND und dem Pin „SET“ ist dabei für die Oszillator-Frequenz zuständig. Die Spannung zwischen „SET“ und GND wird dabei konstant auf 1V gehalten, was einen konstanten Stromfluss hervorruft. Die dabei möglichen Widerstandswerte liegen zwischen 50k und 800k (1,25uA-20uA), was einem Frequenzbereich von 1Mhz bis 62,5kHz entspricht. Die durch den Taktteiler geteilte Oszillatorfrequenz, setzt dabei ein RS-FlipFlop periodisch zurück. Ein Impuls am Trigger-Eingang setzt das FlipFlop, so dass es erst nach einer bestimmten Kipp-Zeit zurückgesetzt werden kann. Der FlipFlop-Ausgang ist dabei über den „Output Polarity“ Block mit dem Ausgang des IC‘s verbunden.

Funktion
Der Schaltungsteil „Taktumschaltung “ ist für das Umschalten der zwei Taktquellen verantwortlich. Es kann zwischen den intern (durch den NE555 generierten) Takt und externen (durch eine vorgeschaltene Messplatine zugeführten) Takt umgeschalten werden . Ausschlaggebend dafür sind zwei Schaltungsteile. Durch betätigen des Tasters SW2 (MODE), wird zwischen den Taktquellen umgeschaltet. Da jede Tasterbetätigung ein mechanisch verursachtes prellen der Kontakte verursacht, muss dies durch das nachgeschaltete Monoflop (U14) unterbunden werden. Die Zeit, die das Monoflop benötigt mit seinem Ausgang auf einen eingangsseitigen Triggerimpuls zu reagieren, dauert länger als das prellende Signal selbst. Somit kommt am Ausgang des Monoflops eine saubere Signalflanke zustande.

Das nachgeschaltete D-FlipFlop ist in seiner Verschaltung, mit den auf den Dateneingang zurückgeführten invertierten Ausgang, als Toggle FlipFlop zu betrachten. Für einen Pegelwechsel am Ausgang Q des Toggle-FlipFlop ist eine steigende und fallende Flanke notwendig. Eine Betätigung mit zwei dynamischen Flanken verursacht demnach einen ausgangsseitigen Pegelwechsel an TP28 mit nur einer Flanke.

Die auf TP28 folgende Schaltung bildet eine zweifach TOR-Schaltung mit nur einem Steuereingang zu verstehen.
Ein High-Signal an TP28 führt dazu, dass die an den Pin 2 (U10A) anliegenden Taktsignale auf den Ausgang übertragen werden. Durch die Invertierung von TP28 werden Taktsignale, die an Pin 5 (U10B) anliegen unterdrückt. Der Ausgang bleibt Low.
Ein Low-Signal an TP28 führt zur unterdrückung der an Pin2 (U10A) anliegenden Signale. Das durch eine vorgeschaltene Messplatine der Schaltung zugeführte Signal an Pin 5 (U10B) wird nun an den Ausgang übertragen.
Das Oder-Gatter überträgt entweder das Signal von U10B oder das Signal von U10A auf seinen Ausgang.

Kippzeit für NDIV = 32768

tKipp =

NDIV ∗R4
50k

∗ 1us =

N32768∗820k
50k
∗ 1us = 537ms | (5)

### 1.2.3 Taktteilung

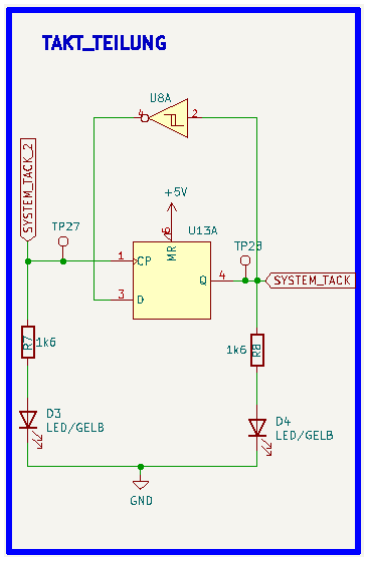
[picture p50: figure]

Für einen folgenden Schaltungsteil wird ein Takt, welcher die doppelte Frequenz des Messtaktes besitzt benötigt. Dazu wird der Grundtakt durch zwei geteilt und als Messtakt verwendet. Der externe oder interne Grundtakt wird vom folgenden Schaltungsteil verwendet.
D3 und D4 geben ein optisches Feedback des Mess- und Grundtaktes.

## 1.3 Dezimal Zähler

### 1.3.1 Messung Starten

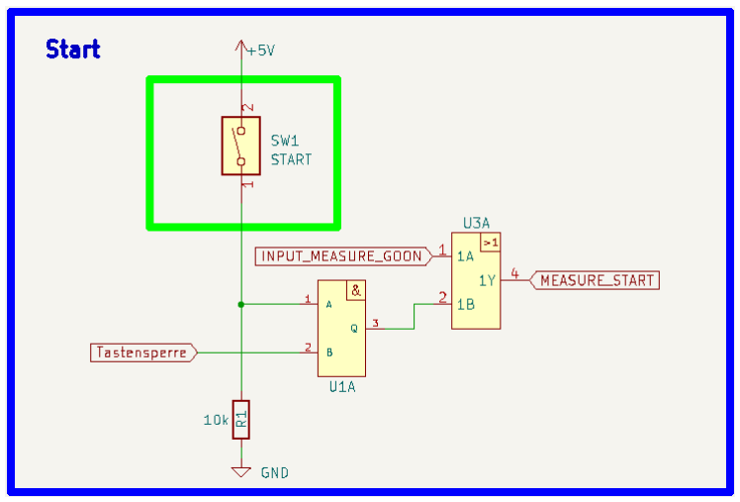
[picture p51: figure]

Die Messung kann über Betätigung des Tasters SW1 (START) oder über ein externes Signal (Label: INPUT MEASURE GOON) gestartet werden. Befindet sich die Messplatine im „Master Mode “ (Master Mode: Grundtakt = Interner Takt Slave Mode: Grundtakt = Externer Takt), so kann die Messung durch den Tasters SW1 gestartet werden. Befindet sich die Messplatine im „Slave Mode “ so kann nur durch ein externes Signal die Messung gestartet werden. Der Taster SW1 (START) ist gesperrt.

### 1.3.2 Reset


Die Aufgabe dieser Schaltung besteht darin, kurze Zeit nach dem Einschalten einen Reset-Impuls für bestimmte Schaltungsteile zu generieren. Wird dies nicht gemacht, so kann es unter Umständen dazu kommen, dass die Messung nicht gestartet werden kann.

Im Einschaltmoment fließt Strom über C16 und R81. C16 liegt dabei parallel zu den Anschlüssen „Emitter und Basis“ des PNP-Transistors Q11. Da im Einschaltmoment C16 als Kurzschluss zu betrachten ist, liegen Emitter und Basis auf dem selben Potential. Ein Stromfluss ist daher nicht möglich und der Transistor Q11 sperrt. C16 beginnt sich über die Zeit langsam aufzuladen. Liegt ein bestimmtes Spannungspotetial über C16 an (ca. 0,7V UBE), so ist ein Stromfluss durch die Basis möglich. Nach einer bestimmten Verzögerung ist nun auch ein Stromfluss durch den Transistor Q11, durch den Kondensator C5 und dem Widerstand R80) möglich. Da C3 ebenfalls im ersten Moment als Kurzschluss zu betrachten ist, fällt über R80 angfänglich ein 5V pegel ab. Die Spannung über C3 baut sich dabei sehr schnell auf, was einen kurzen Nadelimpuls zur folge hat. Das globale Label „RST DEZ“ resetet die Schaltungsteile.

Das IC U28A (IC mit Tri-Sate Funktion) dient zur Stromkreisentkopplung und soll beim Resetvorgang einen Kurzschluss vermeiden. Der Strom kann dabei nur in eine Richtung fließen.

### 1.3.3 Ablauf Steuerung


Durch die voran gegangene Schaltung, welche die FlipFlops FF1: U2A und U2B FF2: U2C und U2D in die definierten Ausgangszustände bringt, kann nun ein einwandfreier Start der Messung durchgeführt werden.

Zum Start der Messung muss das IC U2A einen Ausgangsseitigen High-Pegel ausgeben. Der Ausgang ist dabei auf den Steuereingang des TOR-Gatter zurückgeführt.
Das TOR-Gatter U1C erfährt an seinem Steuereingang Pin 10 einen Low-Pegel. Der anliegende Messtakt wird gesperrt.
An dem Ausgang des IC U2D liegt ein Low-Signal an. Dieses Low-Signal resetet die folgende Schaltung dauerhaft.

Ein High-Signal am Pin 5 (U1B LABEL: MEASURE START) wird auf den Ausgang übertragen. Das an TP19 zu messende High-Signal bleibt so lange aktiv, wie das folgende FlipFlop (U2A und U2B) für das Rücksetzen des Ausganges Pin 1 bzw. für das Setzen des Ausganges Pin 4 benötigt (Gatterlaufzeit). Ein eventuell prellendes Signal an U1B wird somit sofort unterdrückt.
Das High-Signal an TP20 führt dazu, dass der Messtakt an Pin 8 (U1C) auf den Ausgang übertragen wird. Der Nadelimpuls an TP19, führt somit zu einem Rücksetzen des IC U2D. Das daraus resultierende Low-Signal gibt die Folgeschaltung somit frei.

### 1.3.4 Dezimalzähler


Die Aufgabe dieser Schaltung besteht darin, durch ein Eingangssignal ÖUTPUT DEC"von 0 bis 15 dezimal hoch zu zählen. Dabei sollen alle Leitungen, des zu prüfenden Kabels ein, der Reihe nach ein Messsignal erhalten.

U6A ist dabei ein Binärzähler. Liegt an Pin 2 und 3 ein Low-Signal an, kann das Signal an Pin 4 binär hochgezählt werden. Liegt an Pin 2 und 3 ein High-Signal an, werden die Ausgänge zurückgesetzt.

Der Encoder U5A wandelt dabei das 4 Bit Binärsignal in ein 16 Fach Dezimal Signal um. Liegt an Pin 23 ein Low-Signal, so werden alle Ausgänge frei geschalten. Liegt ein High-Signal an, werden die Ausgänge gesperrt.

der Ausgang Y0 (Pin11) wird für die Messung nicht verwendet, da die länge dieses Signales nicht konstant ist.
Erreicht der Dezimalzähler den Wert 16, so wird die Schaltung zurückgesetzt und gegebenenfalls die Messung einer weiteren Messplatine gestartet.

## 1.4 Leitungstreiber und Umschaltung


Liegt an TP10 ein High-Signal an, so leuchtet die LED D39.
Q3 wird in Folge dessen leitend und zieht das Gate des P-Channel MOSFET auf GND.
Dadurch erlangt das Gate ein negativeres Potential als Source. Die Drain-Source Strecke von Q4 wird dadurch leitend. Ein 5V Messsignal liegt am Kabel zwischen J6 an.

Nach der Hälfte des Messzyklus, wechselt das Signal an TP11 durch das Signal an Pin 2 (U4A) von Low nach High.
Der Analogschalter wechselt somit den Messbetrieb von Konstantstrommessung auf Durchgangs- und Kurzschlussmessung.

## 1.5 Durchgangs und Kurzschlussprüfung


Beim Start der Messung, wird durch das Signal an Pin 2 (U30A) der Ausgang Pin 4 (U30B) des FlipFlop gesetzt.

Dabei gibt es folgende Zustände:

- Liegt an den Eingängen Pin 1 und 2 (U29A) ein High-Signal, so hat der Ausgang Pin 3 einen Low-Pegel. Das FlipFlop wird nicht zurück gesetzt.
- Liegt an Pin 2 durch eine Fehler des Kabel ein Low-Signal an, so hat der Ausgang Pin 3 einen High-Pegel. Das FlipFlop wird dabei zurück gesetzt.
- Liegt durch einen Kurzschluss an Pin 2 ein High-Signal und an Pin 1 kein High-Signal, so hat der Ausgang Pin 3 ebenfalls ein High-Pegel vorzuweisen. Das FlipFlop wird zurück gesetzt.

## 1.6 Konstantstrommessung

### 1.6.1 Konstantstrommessung


Der Instrumentenverstärker U19A misst durch den Spannungsfall an R13 den durch das zu messende Kabel fließenden Strom. Das Kabel liegt dabei zwischen +5V und dam Label: KS INPUT.

Der Spannungsfall wird durch den INA um den Faktor 50,9 verstärkt. Diese Spannung wird dem Operationsverstärker U17A zugeführt. Dieser versucht durch sein Regelverhalten, den Stromfluss durch das Kabel so anzupassen, dass keine Spannungsdifferenz zwischen seinen Eingängen anliegt.

Über den Spannungsteiler R88, RV2 und R87 wird der Messstrom eingestelt.
R92 begrenzt den Einschaltstrom, bis der Strom ausgeregelt ist.
Mit Hilfe der Spannung über Q1 wird der ohmsche Widerstand der Messleitung indirekt erfasst.

30mA Messstrom

UP IN1U17A = (1 + 49, 9k
R12

) ∗ (R13 ∗ 0, 03A) = (1 + 49, 9k 1k

) ∗ (1R ∗ 0, 03A) = 1, 53V | (6)

### 1.6.2 Auswertung


Der Operationsverstärker greift diese Spannung hochohmig an Q1 ab.
Über den nachfolgenden Low-Pass Filter R89 und C51, werden Störungen gefiltert.
Der Komparator U18B vergleicht diese Spannung mit einer durch den Spannungsteiler R90, RV3 und R91 eigestelten Reverenzspannung.
Diese Reverenzspannung gibt den maximal zulässigen Leitungswiderstand des Prüflings an.

5R max. Aderwiderstand

UT P30 = ( 5V

30mA − (RLMAX + R13 + R92)) ∗ 0, 03A = ( 5V 30mA − (5R + 1R + 22R)) ∗ 0, 03A = 4, 16V

(7)

### 1.6.3 Ausgabe


Aufgabe der Schaltung ist es, die seriellen Widerstandsmessergebnise parallel dazustellen.

U9A, U22A und U22B erzeugen den Takt für das Schieberegister.

## 1.7 Anzeige


Ist das Ergebnis der Konstantstrommessung und der Durchgangsmessung in Ordnung (KS OUT n = 1 und DK OUT n = 1) leuchtet die grüne LED D6.

Andernfalls leuchtet die rot LED D5 und signalisiert somit einen Fehler in der Ader.
