Oszimilian/Kabeltester/03_Dokumente/02_Projektdokumentation/02_Teilbereiche/03_Auftragsplanung/Auftragsplanung_LaTeX/BA_Auftragsplaung.tex

\documentclass[a4paper,11pt]{scrartcl}

\usepackage[utf8]{inputenc}
\usepackage[ngerman]{babel}
\usepackage[T1]{fontenc}
\usepackage{amsmath}
\usepackage{graphicx}
\usepackage{tabularx}
\usepackage[a4paper, left=2cm, right=2cm, top=2.8cm, bottom=2.8cm]{geometry}
\usepackage{tikz}   
\usepackage[scaled]{helvet}
\usepackage{tabto} 
\usepackage{fancyhdr}
\usepackage{multirow}

\renewcommand*{\familydefault}{\sfdefault}

\pagestyle{fancy}

\setkomafont{section}{\huge}
\setkomafont{subsection}{\Large}

\lhead{Maximilian Hoffmann}
\chead{Betrieblicher Auftrag \\ \textbf{Kabeltester}}
\rhead{}

%%%%%%%%%%%%%%%%%%%%%%%%%%%%%%%%%%%%%%%%%%%%%%%%%%%%%%%%%%%%%%%%%%%%%%%%%%%%%%%%%%%%%%%%%%%%%%%%%%%%%%%%%%%%%%%%%%%%%%%%%%%%%%%%%%%%%%%%%%%%%%%																																			 %
%														Auftragsplanung																     	 %
%																																		     %
%%%%%%%%%%%%%%%%%%%%%%%%%%%%%%%%%%%%%%%%%%%%%%%%%%%%%%%%%%%%%%%%%%%%%%%%%%%%%%%%%%%%%%%%%%%%%%%%%%%%%%%%%%%%%%%%%%%%%%%%%%%%%%%%%%%%%%%%%%%%%%
\begin{document}

\section{Auftragsplanung}

\begin{center}
Ursprünglich war das Einsatzumfeld meines betrieblichen Auftrages für die BMK-Entwicklung vorgesehen. Während der Erstellung eines Lastenheftes stellte sich heraus, dass auch das Testentwicklungslobor an einem solchen Prüfgerät Interesse hat. 
\end{center}

%%%%%%%%%%%%%%%%%%%%%%%%%%%%%%%%%%%%%%%%%%%%%%%%%%%%%%%%%%%%%%%%%%%%%%%%%%%%%%%%%%%%%%%%%%%%%%%%%%%%%%%%%%%%%%%%%%%%%%%%%																																				%
%														Auftragsziel													%
%																														%
%%%%%%%%%%%%%%%%%%%%%%%%%%%%%%%%%%%%%%%%%%%%%%%%%%%%%%%%%%%%%%%%%%%%%%%%%%%%%%%%%%%%%%%%%%%%%%%%%%%%%%%%%%%%%%%%%%%%%%%%%

\subsection{Auftragsziel}

Ziel des betrieblichen Auftrages ist die Entwicklung eines Prüfkonzeptes, sowie den dazugehörigen Prototypen einer Prüfvorrichtung zum Prüfen verschiedener konfektionierter Kabel. Das Prüfkonzept dieses Prototyps soll im Endzustand eine Prüfung verschiedener BMK-Standard-Programmierkabeln und Flachbandkabeln übernehmen können. 
In Zukunft soll dadurch eine Menge Zeit bei der Fehlersuche eingespart werden können. Die Übergabe von fehlerhaften Programmierkabeln an einen Softwareentwickler soll ausgeschlossen werden.
Das Prüfgerät soll nach dem „stand alone“ -Prinzip funktionieren und für den Anwender einfach zu bedienen sein.

%%%%%%%%%%%%%%%%%%%%%%%%%%%%%%%%%%%%%%%%%%%%%%%%%%%%%%%%%%%%%%%%%%%%%%%%%%%%%%%%%%%%%%%%%%%%%%%%%%%%%%%%%%%%%%%%%%%%%%%%%																																				%
%														Anforderung														%
%																														%
%%%%%%%%%%%%%%%%%%%%%%%%%%%%%%%%%%%%%%%%%%%%%%%%%%%%%%%%%%%%%%%%%%%%%%%%%%%%%%%%%%%%%%%%%%%%%%%%%%%%%%%%%%%%%%%%%%%%%%%%%

\subsection{Anforderungen}

Durch Rücksprache mit dem Auftraggeber wurden folgende Details ausgearbeitet. Diese wurden außerdem in einem offiziellen Pflichtenheft festgehalten. 

\begin{itemize}
	\item{Die extern angelegte Versorgungsspannung (Akku oder Batterie) soll möglichst verlustfrei auf einen 5V TTL-Pegel gewandelt werden. }

	\item{Die Leitungen sollen auf Durchgängigkeit, sowie auf Kurzschlüsse untereinander geprüft werden.}
	
	\item{Mit Hilfe eines konstanten Stromfluss, soll der ohmsche Widerstand jeder einzelnen Ader anhand eines festen Vergleichswertes überprüft werden.}
	
	\item{Anzahl der sich auf einer Prüfvorrichtung befindenden Messlinien: 14 Stück.
Erster Prototyp ist auf 4 Messlinien begrenzt!}

	\item{Einfache Erweiterung der Messlinien durch Verbindung zweier Prüfvorrichtungen.}
\end{itemize}

%%%%%%%%%%%%%%%%%%%%%%%%%%%%%%%%%%%%%%%%%%%%%%%%%%%%%%%%%%%%%%%%%%%%%%%%%%%%%%%%%%%%%%%%%%%%%%%%%%%%%%%%%%%%%%%%%%%%%%%%%																																				%
%														Teilaufträge													%
%																														%
%%%%%%%%%%%%%%%%%%%%%%%%%%%%%%%%%%%%%%%%%%%%%%%%%%%%%%%%%%%%%%%%%%%%%%%%%%%%%%%%%%%%%%%%%%%%%%%%%%%%%%%%%%%%%%%%%%%%%%%%%

\subsection{Teilaufträge}
Um das Projekt im Rahmen des Zeitplanes voranzutreiben, werde ich im Bereich Layout und Bestückung der Platinen von meiner Abteilung unterstützt. Diesen Teilbereichen widme ich in meiner Dokumentation keine Aufmerksamkeit. Es wird lediglich die Anforderung an den jeweiligen Teilbereich schriftlich festgehalten.

%%%%%%%%%%%%%%%%%%%%%%%%%%%%%%%%%%%%%%%%%%%%%%%%%%%%%%%%%%%%%%%%%%%%%%%%%%%%%%%%%%%%%%%%%%%%%%%%%%%%%%%%%%%%%%%%%%%%%%%%%																																				%
%														Zeitplanung														%
%																														%
%%%%%%%%%%%%%%%%%%%%%%%%%%%%%%%%%%%%%%%%%%%%%%%%%%%%%%%%%%%%%%%%%%%%%%%%%%%%%%%%%%%%%%%%%%%%%%%%%%%%%%%%%%%%%%%%%%%%%%%%%
\newpage

\renewcommand{\arraystretch}{2}
\subsection{Zeitplanung}

\begin{tabularx}{\textwidth}{p{0.7\textwidth}|  p{0.1\textwidth} | p{0.2\textwidth}}

\textbf{Arbeitsschritt} 	&	\textbf{Geplant}	&	\textbf{Benötigt}	\\

\hline

Gespräch mit Auftraggeber über das Lastenheft	&	1	&	1\\

\hline

Erstes technisches Konzept erstellen			&	1	&	1\\

\hline

Erstellen eines Pflichtenheft					&	1	&	1\\

\hline 

Technische Planung der Schaltungsteile			&	1	&	1\\

\hline 

Bauteilrecherche  								&	1	&	1\\

\hline

Erstellen eines Blockschaltplanes				&	1	&	1\\

\hline

Zeichen der Einzelnen Schaltplanteile			&	1	&	1\\

\hline 

Bestimmen der Bauteilreferenzen					&	1	&	1\\

\hline

Übergabe an Layoutabteilung						&	1	&	1\\

\hline

Übergabe an Bestückung							&	1	&	1\\

\hline

Inbetriebnahme									&	1	&	1\\

\hline

Fehleranalyse und Fehlerbehebung				&	1	&	1\\

\hline 

Übergabe an Auftraggeber						&	1	&	1\\

&&\\

\textbf{Gesamt}	&	36h		&	xh

\end{tabularx}
\renewcommand{\arraystretch}{1}

\end{document}
