Oszimilian/Kabeltester/03_Dokumente/02_Projektdokumentation/02_Teilbereiche/05_Inbetriebnahme/Inbetriebnahme_LaTeX/BA_Inbetriebnahme.tex

\documentclass[a4paper,11pt]{scrartcl}

\usepackage[utf8]{inputenc}
\usepackage[ngerman]{babel}
\usepackage[T1]{fontenc}
\usepackage{amsmath}
\usepackage{graphicx}
\usepackage{tabularx}
\usepackage[a4paper, left=2cm, right=2cm, top=2.8cm, bottom=2.8cm]{geometry}
\usepackage{tikz}   
\usepackage[scaled]{helvet}
\usepackage{tabto} 
\usepackage{fancyhdr}
\usepackage{multirow}

\renewcommand*{\familydefault}{\sfdefault}

\pagestyle{fancy}

\setkomafont{section}{\huge}
\setkomafont{subsection}{\Large}

\lhead{Maximilian Hoffmann}
\chead{Betrieblicher Auftrag \\ \textbf{Kabeltester}}
\rhead{}

%%%%%%%%%%%%%%%%%%%%%%%%%%%%%%%%%%%%%%%%%%%%%%%%%%%%%%%%%%%%%%%%%%%%%%%%%%%%%%%%%%%%%%%%%%%%%%%%%%%%%%%%%%%%%%%%%%%%%%%%%%%%%%%%%%%%%%%%%%%%%%%																																			 %
%														Inbetriebnahme																     	 %
%																																		     %
%%%%%%%%%%%%%%%%%%%%%%%%%%%%%%%%%%%%%%%%%%%%%%%%%%%%%%%%%%%%%%%%%%%%%%%%%%%%%%%%%%%%%%%%%%%%%%%%%%%%%%%%%%%%%%%%%%%%%%%%%%%%%%%%%%%%%%%%%%%%%%
\begin{document}

\section{Inbetriebname}

\begin{center}
Die Inbetriebnahme der Schaltung erfolgt blockweise. Um gegebenenfalls Fehler in der Schaltung analysieren zu können, werden die einzelnen Schaltungsteile nacheinander aufgebaut und in betrieb genommen. Die Funktion der zu prüfenden Schaltungsteile wird oberhalb der Tabelle in Stichpunkten erläutert. Bei fehlerhafter Funktion wird diese in der Sektion "Fehleranalyse" behandelt.
\end{center}

%%%%%%%%%%%%%%%%%%%%%%%%%%%%%%%%%%%%%%%%%%%%%%%%%%%%%%%%%%%%%%%%%%%%%%%%%%%%%%%%%%%%%%%%%%%%%%%%%%%%%%%%%%%%%%%%%%%%%%%%%																																				%
%														Spannungsversorgung												%
%																														%
%%%%%%%%%%%%%%%%%%%%%%%%%%%%%%%%%%%%%%%%%%%%%%%%%%%%%%%%%%%%%%%%%%%%%%%%%%%%%%%%%%%%%%%%%%%%%%%%%%%%%%%%%%%%%%%%%%%%%%%%%

\subsection{Spannungsversorgung}

%%%%%%%%%%%%%%%%%%%%%%%%%%%%%%%%%%%%%%%%%%%%%%%%%%%%%%%%%%%%%%%%%%%%%%%%%%%%%%%
%																			  %
%								Vorgaben									  %
%																			  %
%%%%%%%%%%%%%%%%%%%%%%%%%%%%%%%%%%%%%%%%%%%%%%%%%%%%%%%%%%%%%%%%%%%%%%%%%%%%%%%

\begin{itemize}
	\item{Spannungen sowie Ströme sind hierbei mit einem Multimeter zu messen.}
	
	\item{Die Funktion der "Meldeleuchte Sicherung" wird durch das entnehmen der Sicherung aus dem Sockel geprüft. Leuchtet die LED D33 auf, so ist die Funktion dieses Schaltungsteiles gegeben.}
	
	\item{Die Funktion des Verpolungsschutz wird durch das Anlegen einer verpolten Spannung geprüft. Dabei sollte die Strombegrenzung des Labornetzteiles auf ca. 5mA eingestellt sein. Geht das Netzteil bei diesem Test nicht in die Strombegrenzung, so ist die Funktion dieses Schaltungsteiles gegeben.}
\end{itemize}

%%%%%%%%%%%%%%%%%%%%%%%%%%%%%%%%%%%%%%%%%%%%%%%%%%%%%%%%%%%%%%%%%%%%%%%%%%%%%%%
%																			  %
%								Tabelle  									  %
%																			  %
%%%%%%%%%%%%%%%%%%%%%%%%%%%%%%%%%%%%%%%%%%%%%%%%%%%%%%%%%%%%%%%%%%%%%%%%%%%%%%%

\renewcommand{\arraystretch}{2}
\begin{tabularx}{\textwidth}{p{0.2\textwidth}| p{0.6\textwidth} | p{0.05\textwidth} | p{0.1\textwidth}}

 &  & i.o & n.i.o \\

\hline

Stromaufnahme & $I_{G}$: & [ ] & [ ] \\

\hline

\multirow{3}{*}{Spannungen}
		& $U_{0}$:					&	[ ] & [ ] 	\\
		& $U_{TP8}$: 				&	[ ]	& [ ] 	\\
		& $U_{TP9}$: 				&	[ ] & [ ]  	\\
		
\hline		
		
\multirow{2}{*}{Funktionen}
		& Meldeleuchte Sicherung:  	& [ ] & [ ] 	\\
		& Verpolungsschutz:				& [ ] & [ ] 	\\ 

\end{tabularx}
\renewcommand{\arraystretch}{1}

%%%%%%%%%%%%%%%%%%%%%%%%%%%%%%%%%%%%%%%%%%%%%%%%%%%%%%%%%%%%%%%%%%%%%%%%%%%%%%%%%%%%%%%%%%%%%%%%%%%%%%%%%%%%%%%%%%%%%%%%%																																				%
%														Taktgeber       												%
%																														%
%%%%%%%%%%%%%%%%%%%%%%%%%%%%%%%%%%%%%%%%%%%%%%%%%%%%%%%%%%%%%%%%%%%%%%%%%%%%%%%%%%%%%%%%%%%%%%%%%%%%%%%%%%%%%%%%%%%%%%%%%

\newpage
\subsection{Taktgeber}

%%%%%%%%%%%%%%%%%%%%%%%%%%%%%%%%%%%%%%%%%%%%%%%%%%%%%%%%%%%%%%%%%%%%%%%%%%%%%%%
%																			  %
%								Vorgaben									  %
%																			  %
%%%%%%%%%%%%%%%%%%%%%%%%%%%%%%%%%%%%%%%%%%%%%%%%%%%%%%%%%%%%%%%%%%%%%%%%%%%%%%%

\begin{itemize}
	\item{Überprüfung der Systemtakte mithilfe eines Logikanalysators.}
	
	 \item{Über das Poti soll an TP24 eine Frequenz von 8,5Hz (+-$10\%$) mit einem Tastgrad von 0,5 eingestellt werden.}
	 
	 \item{Durch betätigen von SW2 kann der Pegel von TP26 gewechselt werden, was durch das optische Signal von D1 oder D2 erkennbar wird.}
	 
	 \item{Die Aufgabe von U14 ist die Signalentprellung des Tasters SW2. Diese Funktion wird durch das oszillieren der Signale U14 Pin 1 und TP25 überprüft. Die Kippzeit des Monoflop's soll ca. 500ms betragen.}
	 
	 \item{Leuchtet D2 (Grün), so soll an TP27 die Frequenz von TP24 zu messen sein. Die zu messende Frequenz von TP28 soll dabei die Hälfte von TP27 betragen. Leuchtet D1 (Rot), so soll (sofern kein Verbund aus zwei Messplatinen besteht) keine Frequenz an TP27 und TP28 zu messen sein.}	 
\end{itemize}

%%%%%%%%%%%%%%%%%%%%%%%%%%%%%%%%%%%%%%%%%%%%%%%%%%%%%%%%%%%%%%%%%%%%%%%%%%%%%%%
%																			  %
%								Tabelle  									  %
%																			  %
%%%%%%%%%%%%%%%%%%%%%%%%%%%%%%%%%%%%%%%%%%%%%%%%%%%%%%%%%%%%%%%%%%%%%%%%%%%%%%%

\renewcommand{\arraystretch}{2}
\begin{tabularx}{\textwidth}{p{0.2\textwidth}| p{0.6\textwidth} | p{0.05\textwidth} | p{0.1\textwidth}}

 &  & i.o & n.i.o \\

\hline

Stromaufnahme & $I_{G}$: & [ ] & [ ] \\

\hline

\multirow{2}{*}{Frequenz NE555 }
		& $f_{TP24}$: 				& [ ] & [ ] \\
		& $g_{TP24}$:				& [ ] & [ ] \\

\hline

\multirow{2}{*}{Taktumschaltung}
		& Taktumschaltung:				&	[ ] & [ ] 	\\
		& $t_{Kippzeit}$: 				&	[ ]	& [ ] 	\\
	
\hline		
		
\multirow{3}{*}{Funktionen}
		& Funktion wenn D2 (Grün) leuchtet:  			& [ ] & [ ] 	\\
		& $f_{TP28}$: 									& [ ] & [ ] 	\\
		& Funktion wenn D1 (ROT) leuchtet:				& [ ] & [ ] 	\\ 

\end{tabularx}
\renewcommand{\arraystretch}{1}

%%%%%%%%%%%%%%%%%%%%%%%%%%%%%%%%%%%%%%%%%%%%%%%%%%%%%%%%%%%%%%%%%%%%%%%%%%%%%%%%%%%%%%%%%%%%%%%%%%%%%%%%%%%%%%%%%%%%%%%%%																																				%
%														Taktgeber       												%
%																														%
%%%%%%%%%%%%%%%%%%%%%%%%%%%%%%%%%%%%%%%%%%%%%%%%%%%%%%%%%%%%%%%%%%%%%%%%%%%%%%%%%%%%%%%%%%%%%%%%%%%%%%%%%%%%%%%%%%%%%%%%%

\newpage
\subsection{DEZ-Zähler}

%%%%%%%%%%%%%%%%%%%%%%%%%%%%%%%%%%%%%%%%%%%%%%%%%%%%%%%%%%%%%%%%%%%%%%%%%%%%%%%
%																			  %
%								Vorgaben									  %
%																			  %
%%%%%%%%%%%%%%%%%%%%%%%%%%%%%%%%%%%%%%%%%%%%%%%%%%%%%%%%%%%%%%%%%%%%%%%%%%%%%%%

\begin{itemize}
	\item{Wenn die LED D2 (Grün) leuchtet, kann durch Betätigung von SW1 (START) der Messvorgang gestartet werden. Dies macht sich durch das Lauflicht (bestehend aus D39, D40, D41, D42) bemerkbar.}
	
	\item{Nach einer Zeit von ca. 3s (Messbar durch Impulszeit von TP20) soll das ganze System durch Betätigung von SW1 erneut gestartet werden können.}
	
	\item{Im Einschaltmoment soll ein verspäteter Nadelimpuls für das korrekte Setzen(default-states) der Schaltung am TP23 gemessen werden können.}
	
	 \item{Leuchtet die LED D1 (Rot), so soll ein Starten der Messung durch Betätigung von SW1 (START) nicht möglich sein.}
\end{itemize}

%%%%%%%%%%%%%%%%%%%%%%%%%%%%%%%%%%%%%%%%%%%%%%%%%%%%%%%%%%%%%%%%%%%%%%%%%%%%%%%
%																			  %
%								Tabelle  									  %
%																			  %
%%%%%%%%%%%%%%%%%%%%%%%%%%%%%%%%%%%%%%%%%%%%%%%%%%%%%%%%%%%%%%%%%%%%%%%%%%%%%%%

\renewcommand{\arraystretch}{2}
\begin{tabularx}{\textwidth}{p{0.2\textwidth}| p{0.6\textwidth} | p{0.05\textwidth} | p{0.1\textwidth}}

 &  & i.o & n.i.o \\

\hline

Stromaufnahme & $I_{G}$: & [ ] & [ ] \\

\hline

\multirow{2}{*}{Start Messung}
		& LED D2 und SW1 -> Messung Startet		 							& [ ] & [ ] \\
		& $t_{Testzeit}$:														& [ ] & [ ] \\

\hline

\multirow{2}{*}{Nadelimpuls}
		& $t_{Delay}$:				&	[ ] & [ ] 	\\
		& $t_{in}$: 				&	[ ]	& [ ] 	\\
		
\hline

Tastensperre & LED D1 und SW1 -> Messung Startet nicht & [ ] & [ ] \\
		
\end{tabularx}
\renewcommand{\arraystretch}{1}

%%%%%%%%%%%%%%%%%%%%%%%%%%%%%%%%%%%%%%%%%%%%%%%%%%%%%%%%%%%%%%%%%%%%%%%%%%%%%%%%%%%%%%%%%%%%%%%%%%%%%%%%%%%%%%%%%%%%%%%%%																																				%
%														Taktgeber       												%
%																														%
%%%%%%%%%%%%%%%%%%%%%%%%%%%%%%%%%%%%%%%%%%%%%%%%%%%%%%%%%%%%%%%%%%%%%%%%%%%%%%%%%%%%%%%%%%%%%%%%%%%%%%%%%%%%%%%%%%%%%%%%%

\newpage
\subsection{Leitungstreiber und Umschaltung}

%%%%%%%%%%%%%%%%%%%%%%%%%%%%%%%%%%%%%%%%%%%%%%%%%%%%%%%%%%%%%%%%%%%%%%%%%%%%%%%
%																			  %
%								Vorgaben									  %
%																			  %
%%%%%%%%%%%%%%%%%%%%%%%%%%%%%%%%%%%%%%%%%%%%%%%%%%%%%%%%%%%%%%%%%%%%%%%%%%%%%%%

\begin{itemize}
	\item{Bei einem High-Signal an TP10 muss das 5V Potenzial auf den Pin 1 von J6 durchgeschaltet werden. Diese Messung muss mit einem Oszilloskop erfolgen, um Pegelschwankungen eindeutig erkennen zu können.}
	
	\item{Nach der Hälfte des High-Signals an TP10 muss auch ein High-Signal an TP11 gemessen werden können.}
	
	\item{Um die Funktion des Analogschalters bestätigen zu können, muss bei gestecktem Jumper (J6) ein 5V Signal für $\dfrac{t_{TP10}}{2}$ an TP5 und TP32 anliegen.}
\end{itemize}

%%%%%%%%%%%%%%%%%%%%%%%%%%%%%%%%%%%%%%%%%%%%%%%%%%%%%%%%%%%%%%%%%%%%%%%%%%%%%%%
%																			  %
%								Tabelle  									  %
%																			  %
%%%%%%%%%%%%%%%%%%%%%%%%%%%%%%%%%%%%%%%%%%%%%%%%%%%%%%%%%%%%%%%%%%%%%%%%%%%%%%%

\renewcommand{\arraystretch}{2}
\begin{tabularx}{\textwidth}{p{0.2\textwidth}| p{0.6\textwidth} | p{0.05\textwidth} | p{0.1\textwidth}}

 &  & i.o & n.i.o \\

\hline

Stromaufnahme & $I_{G}$: & [ ] & [ ] \\

\hline

\multirow{2}{*}{Messspannung}
		& $t_{TP10}$:						& [ ] & [ ] \\
		& $U_{J6}$: 						& [ ] & [ ] \\

\hline

\multirow{2}{*}{Umschaltsignal}
		& $t_{delay-TP11}$	 				& [ ] & [ ] \\
		& $t_{TP11}$:						& [ ] & [ ] \\

\hline

Umschaltung & Umschaltung von U38A:	& [ ] & [ ] \\
		
\end{tabularx}
\renewcommand{\arraystretch}{1}

%%%%%%%%%%%%%%%%%%%%%%%%%%%%%%%%%%%%%%%%%%%%%%%%%%%%%%%%%%%%%%%%%%%%%%%%%%%%%%%%%%%%%%%%%%%%%%%%%%%%%%%%%%%%%%%%%%%%%%%%%																																				%
%														Taktgeber       												%
%																														%
%%%%%%%%%%%%%%%%%%%%%%%%%%%%%%%%%%%%%%%%%%%%%%%%%%%%%%%%%%%%%%%%%%%%%%%%%%%%%%%%%%%%%%%%%%%%%%%%%%%%%%%%%%%%%%%%%%%%%%%%%

%\newpage
\subsection{Durchgangsprüfung und Kurzschlussmessung}

%%%%%%%%%%%%%%%%%%%%%%%%%%%%%%%%%%%%%%%%%%%%%%%%%%%%%%%%%%%%%%%%%%%%%%%%%%%%%%%
%																			  %
%								Vorgaben									  %
%																			  %
%%%%%%%%%%%%%%%%%%%%%%%%%%%%%%%%%%%%%%%%%%%%%%%%%%%%%%%%%%%%%%%%%%%%%%%%%%%%%%%

\begin{itemize}
	\item{Analyse des Reset-Impulses, welcher die Schaltung in einen einheitlichen Startzustand bringt.}
	
	\item{Überprüfung der Nadelimpulsunterdrückung durch gleichzeitiges messen an TP32 und Pin 6 von U30.}
\end{itemize}

%%%%%%%%%%%%%%%%%%%%%%%%%%%%%%%%%%%%%%%%%%%%%%%%%%%%%%%%%%%%%%%%%%%%%%%%%%%%%%%
%																			  %
%								Tabelle  									  %
%																			  %
%%%%%%%%%%%%%%%%%%%%%%%%%%%%%%%%%%%%%%%%%%%%%%%%%%%%%%%%%%%%%%%%%%%%%%%%%%%%%%%

\renewcommand{\arraystretch}{2}
\begin{tabularx}{\textwidth}{p{0.2\textwidth}| p{0.6\textwidth} | p{0.05\textwidth} | p{0.1\textwidth}}

 &  & i.o & n.i.o \\

\hline

Stromaufnahme & $I_{G}$: & [ ] & [ ] \\

\hline

Reset-Impuls & $t_{RST}$: & [ ] & [ ] \\

\hline

\multirow{2}{*}{Nadel-Impuls}
		& $t_{TP32_{Nadel-Impuls}}$:	 				& [ ] & [ ] \\
		& $U_{Pin6 U30_{Nadel-Impuls}}$:				& [ ] & [ ] \\
		
\end{tabularx}
\renewcommand{\arraystretch}{1}

%%%%%%%%%%%%%%%%%%%%%%%%%%%%%%%%%%%%%%%%%%%%%%%%%%%%%%%%%%%%%%%%%%%%%%%%%%%%%%%%%%%%%%%%%%%%%%%%%%%%%%%%%%%%%%%%%%%%%%%%%																																				%
%														Taktgeber       												%
%																														%
%%%%%%%%%%%%%%%%%%%%%%%%%%%%%%%%%%%%%%%%%%%%%%%%%%%%%%%%%%%%%%%%%%%%%%%%%%%%%%%%%%%%%%%%%%%%%%%%%%%%%%%%%%%%%%%%%%%%%%%%%

\newpage
\subsection{Konstantstrommessung}

%%%%%%%%%%%%%%%%%%%%%%%%%%%%%%%%%%%%%%%%%%%%%%%%%%%%%%%%%%%%%%%%%%%%%%%%%%%%%%%
%																			  %
%								Vorgaben									  %
%																			  %
%%%%%%%%%%%%%%%%%%%%%%%%%%%%%%%%%%%%%%%%%%%%%%%%%%%%%%%%%%%%%%%%%%%%%%%%%%%%%%%

\begin{itemize}
	\item{Funktion der Konstantstromquelle prüfen durch Stecken eines Jumpers auf J6 und Starten eines Messvorganges. Wenn RV2 und RV3 in Mittelstellung sind, dann ist an TP 6 ein High-Impuls zu erwarten.}
	
	\item{Prüfen, ob die richtigen Takte bzw. Steuersignale an dem Schieberegister anliegen.}
	
	\item{Prüftabelle mit verschiedenen Kabelwiderständen und den dazugehörigen rechnerischen Werten anlegen.}
\end{itemize}

%%%%%%%%%%%%%%%%%%%%%%%%%%%%%%%%%%%%%%%%%%%%%%%%%%%%%%%%%%%%%%%%%%%%%%%%%%%%%%%
%																			  %
%								Tabelle  									  %
%																			  %
%%%%%%%%%%%%%%%%%%%%%%%%%%%%%%%%%%%%%%%%%%%%%%%%%%%%%%%%%%%%%%%%%%%%%%%%%%%%%%%

\renewcommand{\arraystretch}{2}
\begin{tabularx}{\textwidth}{p{0.25\textwidth}| p{0.55\textwidth} | p{0.05\textwidth} | p{0.1\textwidth}}

 &  & i.o & n.i.o \\

\hline

Stromaufnahme & $I_{G}$: & [ ] & [ ] \\

\hline

Konstantstromquelle & Funktion der Konstantstromquelle: 	& [ ] & [ ] \\

\hline

Schieberegister Takte & Funktion der Steuersignale: 		& [ ] & [ ] \\
		
\end{tabularx}
\renewcommand{\arraystretch}{1}

\vspace{1,5cm}
\textbf{Bemerkung:}
\\
Die Inbetriebnahme dieses Schaltungsteiles hat auf Grund von verschiedenen Fehler einen größeren Zeitraum, als geplant eingenommen. Im Kapitel Fehleranalyse wird zwar auf die Fehler und deren Behebung eingegangen, aus zeitlichen Gründen ist dieser Teil aber kein offizieller Teil meines betrieblichen Auftrages.

\end{document}
