Oszimilian/Kabeltester/03_Dokumente/01_Antrag/02_Antrag-Schriftlich/Flusstext_Antrag.odt

Ausgangszustand, Ziel, Rahmenbedingungen

Zu entwickeln ist eine Messvorrichtung, welche die Prüfung verschiedener konfektionierter Kabel z. B. Flachbandkabel übernehmen soll. Dies ist erforderlich, da in den meisten Fällen, Flachbandkabel nicht einem Prüfungsprozess unterzogen werden. Treten Fehler in einer elektronischen Schaltung auf, so ist das Nachmessen eines Flachbandkabels, vermutlich einer der letzten Schritte der Fehlersuche. Durch meinen betrieblichen Auftrag soll in Zukunft der Zeitaufwand auf ein Minimum reduziert werden, um im Vorfeld einen Fehler ausschließen zu können.

Die technischen Anforderungen sind dabei, das Überprüfen auf Kurzschlüsse der parallel verlaufenden Leitungen und das Messen jeder einzelnen Leitung, mit einem konstanten Strom. Liegt ein Fehler vor, so sollen Signalleuchten dem Bediener die eindeutige Position der fehlerhaften Adern anzeigen. Konstanter Messstrom, Widerstandsgrenzwert und Messgeschwindigkeit sollen dabei einstellbar sein.

Zur Überprüfung von Programmierkabeln mit ungleichen Steckerbelegungen, soll ebenfalls eine Möglichkeit bestehen diese nach ihrer Fertigung prüfen zu können. Die dafür notwendige Hard- und Software, soll zwar zu Projektende vorhanden sein, ist aber kein Teil des betrieblichen Auftrages. Der dafür benötigte Zeitaufwand in Kombination mit der Entwicklung der restlichen Hardware, ist nicht mit den Vorgaben der Prüfungsvorschrift zu vereinbaren.

Informationen und Auftragsplanung

- Informationen zum Auftrag bei Auftragsgebern einholen.

- Technische Anforderungen des Auftraggebers, werden in einem Lastenheft mir übergeben.

- Erstellen eines Pflichtenheftes nach Anforderungen des Lastenheftes.

- Information zur technischen Realisierung einholen.

- Auswahl geeigneter Bauteile treffen und auf Verfügbarkeit prüfen.

Auftragsdurchführung

- Erstellen eines Blockschaltbildes.

- Entwickeln eines Schaltplanes.

- Funktionsprüfung einzelner Schaltungsteile durch Aufbau und Simulation.

- Teilauftrag an Layoutabteilung.

- Erstellen einer Dokumentation.

- Erstellen einer Bedienungsanleitung für den allgemeinen Gebrauch.

Auftragskontrolle

- Inbetriebnahme der Schaltung.

- Funktionstest durchführen.

- Prüfprotokoll erstellen und ausfüllen.

- Abschließende Dokumentation über Arbeitszeit und Materialverbrauch / Kosten.

- Übergabe an die Auftragsgeber.
