Oszimilian/Kabeltester/03_Dokumente/02_Projektdokumentation/02_Teilbereiche/07_Praxisbegleitende Unterlaben/Praxisbegleitendeunterlagen.docx

Berufsbezeichnung: Elektroniker für Geräte und Systeme Einsatzgebiet Prüftechnik | | | Abschlussprüfung: Sommer 2021 Prüf-Nr.: Prüfungsausschuss-Nr.:
| | | Sie finden diese Angaben/Nummern auf Ihrem Genehmigungsschreiben.
Prüfling: Vorname, Name: Maximilian Hoffmann Straße, Hausnr.: Falkensteinstraße. 8 PLZ, Ort: 86316 Friedberg Telefon: 0821 718272 Fax: 0821 7807502 E-Mail: maximilian@hoffmann-maximilian.net | | | Ausbildungsbetrieb: Firma: BMK Group GmbH & Co. KG Straße, Hausnr.: Werner-von-Siemens-Straße 6 PLZ, Ort: 86159 Augsburg Telefon: 0821 20788 0 Fax: 0821 20788 101 E-Mail: info@bmk-group.com

Bezeichnung des Betrieblichen Auftrags:

Kabeltester

Information und Auftragsplanung (Kurzbeschreibung): ca. 24 h

-Die Durchführung des Projektes erfolgt in der BMK-Entwicklung.

-Technische Anforderungen des Lastenheftes mit dem Auftraggeber besprechen.

-Grundlegende schaltungsspezifische Funktionen planen.

-Auswahl geeigneter Bauteile treffen und auf Verfügbarkeit prüfen.

Auftragsdurchführung (Kurzbeschreibung): ca. 24 h

-Erstellen eines Pflichtenhefts nach Anforderungen des Lastenheftes.

-Erstellen eines Blockschaltbildes.

-Entwickeln eines Schaltplanes.

-Funktionsprüfung einzelner Schaltungsteile durch Aufbau und Simulation.

-Teilauftrag an Layoutabteilung.

-Erstellen einer Dokumentation.

-Erstellen einer Bedienungsanleitung für den allgemeinen Gebrauch.

Auftragskontrolle (Kurzbeschreibung): ca. 32 h

-Inbetriebnahme der Schaltung nach Vorgaben des Prüfprotokolls.

-Abschließende Dokumentation über Arbeitszeit und Materialverbrauch / Kosten.

-Übergabe an den Auftraggeber.

Übersicht der verwendeten und erstellten praxisbegleitenden Unterlagen (Anlagen):
Phasen | Bezeichnung der Dokumente und Unterlagen
| Anlage Nr. | Titel/Bezeichnung | | Seite(n)
Information | Kapitel: 1 | Klärung der Begrifflichkeiten
| Kapitel: 2 | Ausgangssituation
Planung | Kapitel: 3.1 | Auftragsziel
| Kapitel 3.2: | Anforderungen
| Kapitel: 3.3 | Teilaufträge
| Kapitel: 3.4 | Bauteilbeschaffung
| Kapitel: 3.5 | Zeitplanung
Durchführung | Kapitel: 10.2 | Pflichtenheft
| Kapitel: 4 | Blockschaltbild
| Kapitel: 5 | Schaltplanentwurf
| Kapitel: 10.6 | Bedienungsanleitung
Kontrolle | Kapitel: 6 | Inbetriebnahme
| Kapitel: 7 | Fehleranalyse
| Kapitel: 9 | Leistungsaufnahme

* Die maximale Anzahl der praxisbegleitenden Unterlagen, Dokumente etc. ist nicht vorgegeben, jedoch sollten es pro Phase mindestens zwei Dokumente sein.

Sonstige Unterlagen, sachdienliche Hinweise:

19.05.2021 Seite 2 von 2 www.schwaben.ihk.de

Seite 1 von 3 www.schwaben.ihk.de

Seite 2 von 3 www.schwaben.ihk.de

Praxisbegleitende Unterlagen
