Oszimilian/Kabeltester/03_Dokumente/02_Projektdokumentation/03_Sonstiges/Layout_Kabeltester.pdf

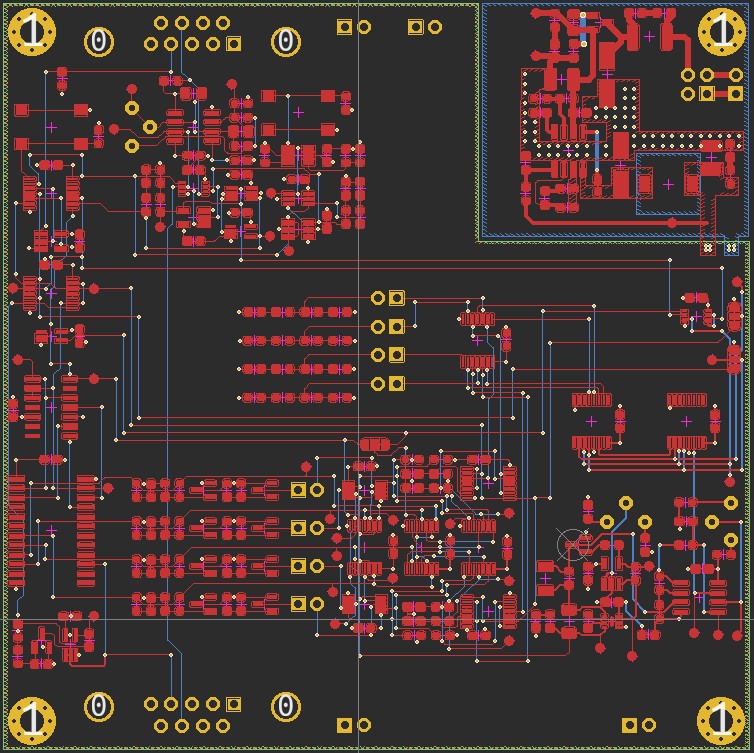
[picture p52: page 1]
