Oszimilian/Kabeltester/03_Dokumente/02_Projektdokumentation/01_Dokumentation_Latex/Abschlussprojekt_LaTeX_002/PDF/BA_Uebergabe.pdf

Maximilian Hoffmann

Betrieblicher Auftrag
Kabeltester

Platzhalter wenn ein Kapitel auf einer neuen Seite beginnt

# Übergabeprotokoll

Auftraggeber:
Robert Schulz
BMK Group GmbH Co. KG
Entwicklung

Auftragsnehmer:
Maximilian Hoffmann
BMK Group GmbH Co. KG
Entwicklung Labor

## 1 Übergabe

- Übergabedatum: 14.5.2021
- Übergabeort: BMK-Entwicklung Labor

## 2 Produktvorführung

- Vorführung der verschiedenen Funktionen.
- Verschiedene Messungen mit dem Oszilloskop durchgeführt.

## 3 Fazit

- Allgemeines Fazit ist von Seiten des Auftraggebers sehr positiv ausgefallen.
- Der Auftraggeber hat die Ungenauigkeit der Widerstandsauswertung bemängelt. Eine Verbesserung dieses Schaltungsteils ist bis zum 28.5.2021 gewünscht.
- Nach dem 28.5.2021 entscheidet der Auftraggeber, ob eine Weiterentwicklung der Schaltung durchgeführt werden soll.

Ort, Datum

Unterschrift Auftraggeber | Unterschrift Auftragnehmer

1
