Oszimilian/Kabeltester/03_Dokumente/02_Projektdokumentation/01_Dokumentation_Latex/Abschlussprojekt_LaTeX_002/PDF/BA_Persoenliche.pdf

Seite 1 von 1 | www.schwaben.ihk.de

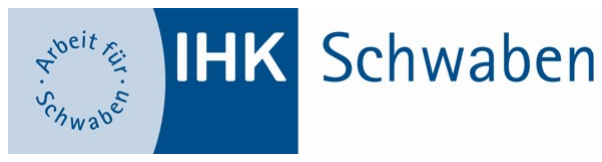
[picture p53: figure]

## Persönliche Erklärung zum Betrieblichen Auftrag

Hiermit versichere ich, Maximilian Hoffmann | dass ich den betrieblichen Auftrag
Vorname und Name des Prüfungsteilnehmers

## Kabeltester

Bezeichnung des Betrieblichen Auftrags

unter der Betreuung von Robert Schulz
Vorname und Name des betrieblichen Betreuers

selbstständig durchgeführt und die vorliegenden praxisbezogenen Unterlagen selbstständig zusammengestellt habe.

Dokumente, die ich nicht selbstständig erstellt habe, sind von mir entsprechend gekennzeichnet.

Den betrieblichen Auftrag habe ich in der geplanten Zeit fertiggestellt.

Den betrieblichen Auftrag habe ich nicht in der geplanten Zeit fertiggestellt. Ich habe

### 45 Stunden länger benötigt

Den betrieblichen Auftrag habe ich nicht in der geplanten Zeit fertiggestellt. Ich habe Stunden weniger benötigt

Augsburg, 20.05.2021 | Maximilian Hoffmann
Ort, Datum | Vorname und Name Prüfungsteilnehmer | Unterschrift

Ich bestätige die in den praxisbegleitenden Unterlagen dokumentierte Durchführung des betrieblichen Auftrags durch den Prüfungsteilnehmer:

Augsburg, 20.05.2021 | Robert Schulz
Ort, Datum | Vorname und Name Betreuer/Ausbilder | Unterschrift
