Oszimilian/Kabeltester/03_Dokumente/02_Projektdokumentation/01_Dokumentation_Latex/Abschlussprojekt_LaTeX_002/PDF/BA_Teilauftrag.pdf

Maximilian Hoffmann

Betrieblicher Auftrag
Kabeltester

Platzhalter wenn ein Kapitel auf einer neuen Seite beginnt

# Teilauftrag Bestückung

Auftraggeber
Maximilian Hoffmann
BMK Group GmbH Co.KG
Entwicklung Labor

Auftragsnehmer
Andreas Hild
BMK Group GmbH Co.KG
Entwicklung Labor

# 1 Beschreibung

Aufbau der Prototypen nach Bestückungsplan. Der Aufbau des ersten Prototyps erfolgt schrittweise. Die einzelnen Teilschaltungen werden nacheinander durch den Auftraggeber in Betrieb genommen.

# 2 Anforderungen

- Zu bestücken: 2 Stück.
- SMD und THT Bestückung.
- Bestückung von U19 (BGA) in der Zentralen Reparatur.

# 3 Anlagen

- Bestückungsplan
- Bauteile

Ort, Datum

Unterschrift Auftraggeber | Unterschrift Auftragnehmer

1
