Oszimilian/Kabeltester/05_Organisation/BA_Bestellung_002.ods

MBA
Produkt | Anzahl pro PCB | Aktueller Bestand | Bestellung Formel |  | Bestellung Anzahl
22uF | 1 |  |  | 02-3361
100uF | 1 | 3 | -1 | 02-1635
LED/ROT | 6 | 13 | -1 | 08-8617
LED/GRUEN | 7 | 11 | 3 | 08-8620 | 5
LED/GELB | 6 | 8 | 4 | 08-8619 | 5
SMAJ10CA | 1 | 3 | -1 | 08-5491-2
BZX585-C5V1 | 1 | 3 | -1 | 38-1875
B340A | 1 | 3 | -1 | 08-2283
INPUT/MALE-DB9 | 1 | 2 | 0 | 03-0250
OUTPUT/FEMALE-DB9 | 1 | 2 | 0 | 03-1123
6,8uH | 1 | 3 | -1 | 04-1025
SI2318 | 1 | 13 | -11 | 08-8668
Si2301 | 5 | 10 | 0 | 08-0150
BSS123 | 4 | 7 | 1 | 08-0503 | 5
100mR | 1 | 3 | -1 | 01-1901-3
10k2 | 1 |  | 2 | 01-3584 | 5
1k96 | 1 |  | 2 | 01-6622 | 5
START | 1 | 2 | 0 | 25-1170
MODE | 1 | 2 | 0 | 25-1170
74HC08PW | 4 |  | 8 | 06-0975 | 10
74HC02PW | 3 |  | 6 | 06-0471-1 | 10
74AHC1G32 | 2 | 3 | 1 | 06-0631 | 5
TPS_54331 | 1 | 3 | -1 | 11-9800-1
74AHC2G08 | 2 | 5 | -1 | 06-0948-1
NE555 | 1 | 3 | -1 | 11-0596
LTC6993 | 1 | 3 | -1 | 06-6636
74LVC1G175 | 2 | 6 | -2 | 06-1146
74LVC2G14 | 1 |  | 2 | 06-1410 | 5
LMV321AUIDBVR | 1 | 3 | -1 | 11-1946
LMV358MM | 1 | 3 | -1 | 11-0573
INA826AIDRGT | 1 | 2 | 0 | 07-1477 / 07-2138
74HC595PW | 2 |  | 4 | 06-0831 | 5
74HC1G126 | 1 | 4 | -2 | 06-0813
74HC86PW | 1 |  | 2 | 06-3524-1 | 5
74AHC1G14 | 2 | 7 | -3 | 06-0624
BAS416 | 1 | 3 | -1 | 08-5493
