Oszimilian/Kabeltester/05_Organisation/BA_Bestellung_001.ods

MOUSER
Produktbeschreibung | Produkt | Mouser-Nr. | Menge | Kosten pT | Kosten gesammt
Full 4 Bit Decoder | CD74HC4514 | 595-CD74HC4514M96 | 3 | 2,57 | 7,71
4Bit Counter | 74LS93 | 595-SN74LS93D | 3 | 2,38 | 7,14
AND-Gatter 2Gate | 74AHC2G08 | 771-AHC2G08DC125 | 5 | 0,381 | 1,905
NAND-Gatter 2Gate | 74AHC2G00 | 771-AHC2G00DC125 | 5 | 0,364 | 1,82
S-R-Latch 4x | 74LS279 | 595-SN74LS279ADR | 5 | 1,02 | 5,1
XNOR Gatter | 74HC7266 | 595-CD74HC7266M96 | 5 | 1,42 | 7,1
Analog-Switch | DG2535 | 78-DG2535EDQ-T1-GE3 | 10 | 1,25 | 12,5
XOR-Gatter | 74VHC1G86 | 863-MC74VHC1G86DBVTG | 3 | 0,152 | 0,456
 |  |  |  | Gesammt | 43,731
BMK
Produktbeschreibung | Produkt | BMK-Nr. | Menge
NOR Gatter | 74LVC2G02 | 07-4465 | 5
D FlipFlop | 74LVC1G175 | 06-6355 | 5
Timer NE 555 | NE 555 | 11-0596 | 5
OP-AMP | LMV321 | 07-2209 | 5
DIF-OP-AMP | INA826 | 07-1477 | 3
OP-AMP | LMV358 | 11-0574 | 5
Ref-Diode | LM4040 | 07-0971 | 3
AND-Gatter 1Gate | 74AHC1G08 | 06-0691 | 20
Schieberegister | 74HC595 | 06-0163 | 5
AND-Gatter 4Gate | 74LS08 | 06-0184 | 10
Schaltregler | TPS5430 | 11-6194 | 2
