Oszimilian/Kabeltester/03_Dokumente/02_Projektdokumentation/01_Dokumentation_Latex/Abschlussprojekt_LaTeX_002/PDF/BA_Bedienungsanleitung.pdf

Maximilian Hoffmann

Betrieblicher Auftrag
Kabeltester

Platzhalter wenn ein Kapitel auf einer neuen Seite beginnt

# Bedienungsanleitung

## 1 Bedienung


1 Umschalten zwischen „Master“und „Slave“Modus.
Mastermode: Grüne LED leuchtet. Platine verwendet ihren internen Takt. Slavemode: Rote LED leuchtet. Platine verwendet externen Takt.

2 Messgeschwindigkeit kann geringfügig geändert werden.

3 Messung kann gestartet werden.

4 Messstrom und Grenzwiderstand können eingestellt werden.
!Achtung! nach jeder Änderung muss der Teil neu kalibriert werden.

5 Zwischen diesen beiden Anschlüssen muss das zu messende Kabel gesteckt werden.

6 Jumper stecken.

7 Optische Ausgabe / Feedback.

1

Maximilian Hoffmann

Betrieblicher Auftrag
Kabeltester

## 2 Programmierkabel-Test

Um ein Programmierkabel testen zu können muss ein passender Adapter gefertigt werden. Da die Schaltung Kurzschlüsse nur bei parallel verlaufenden Adern detektieren kann, müssen Kreuzungen der Adern durch eine zusätzliche Adapterplatine entfernt werden.

Dies könnte so aussehen:


2
