Oszimilian/Kabeltester/03_Dokumente/02_Projektdokumentation/04_Dokumentation_Final/Test/Anhang1.pdf

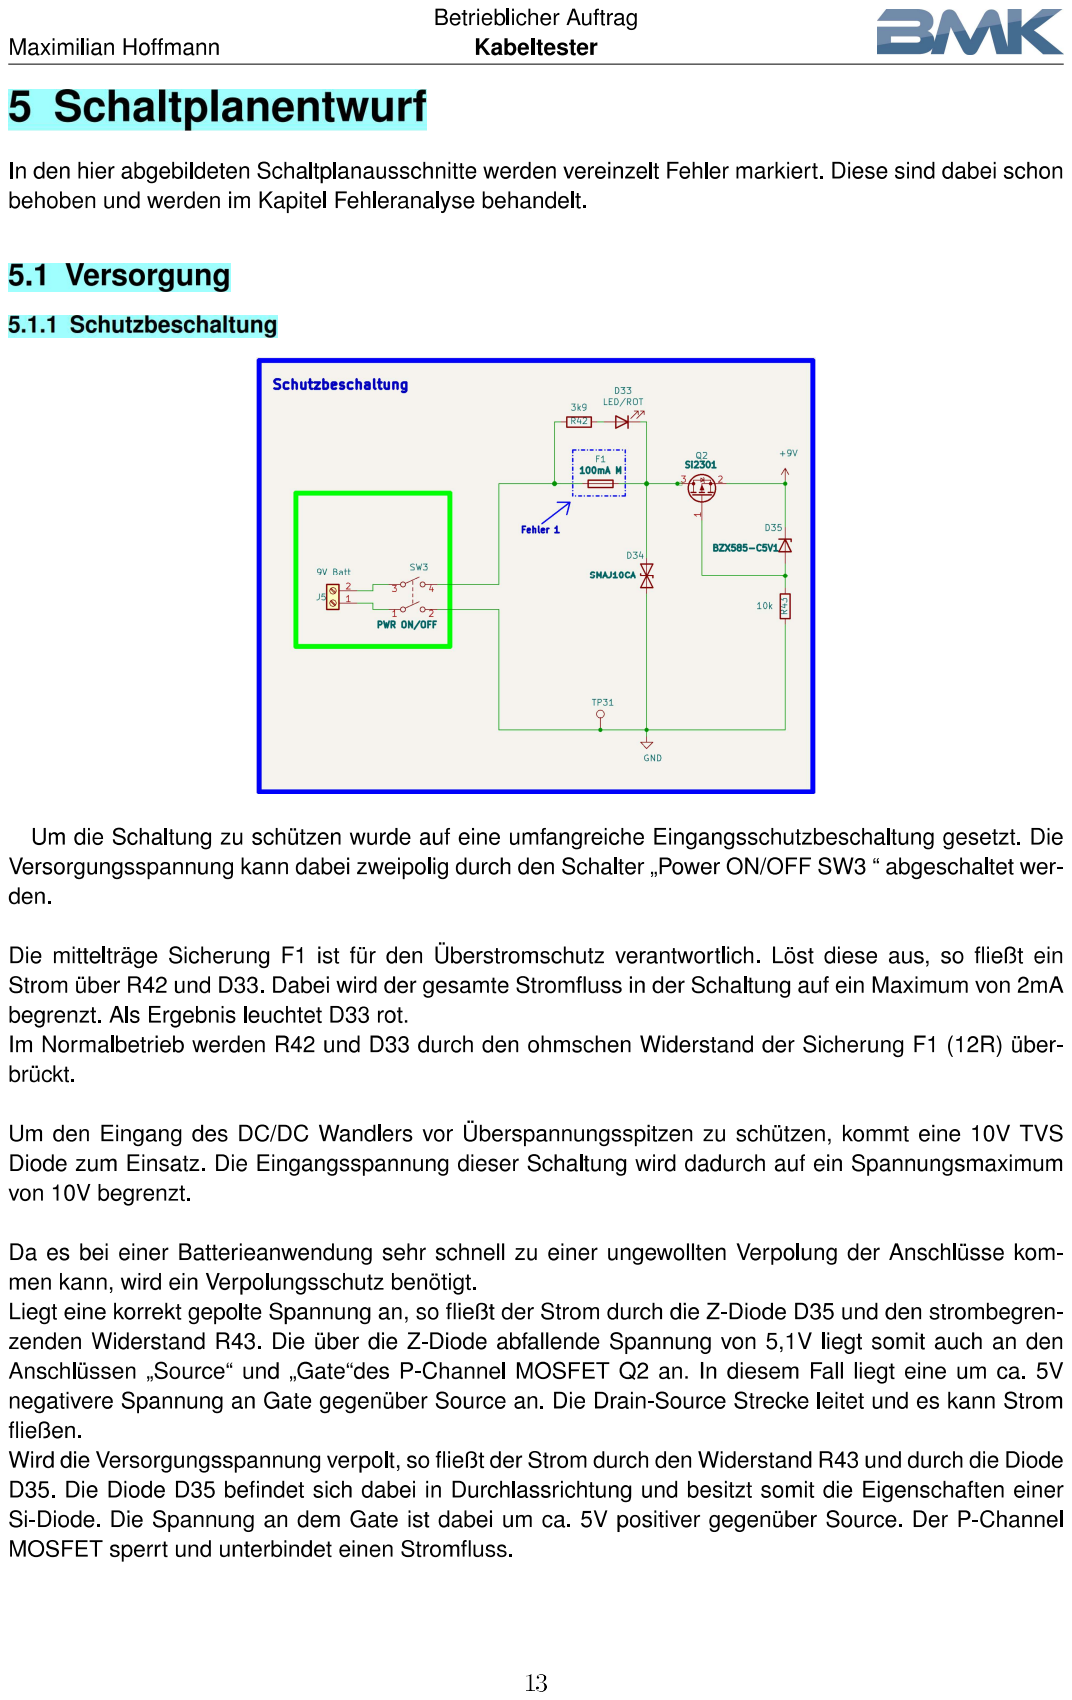
[picture p57: page 1]
