Oszimilian/Kabeltester/03_Dokumente/03_Datenblätter/Bestückungsplan.pdf

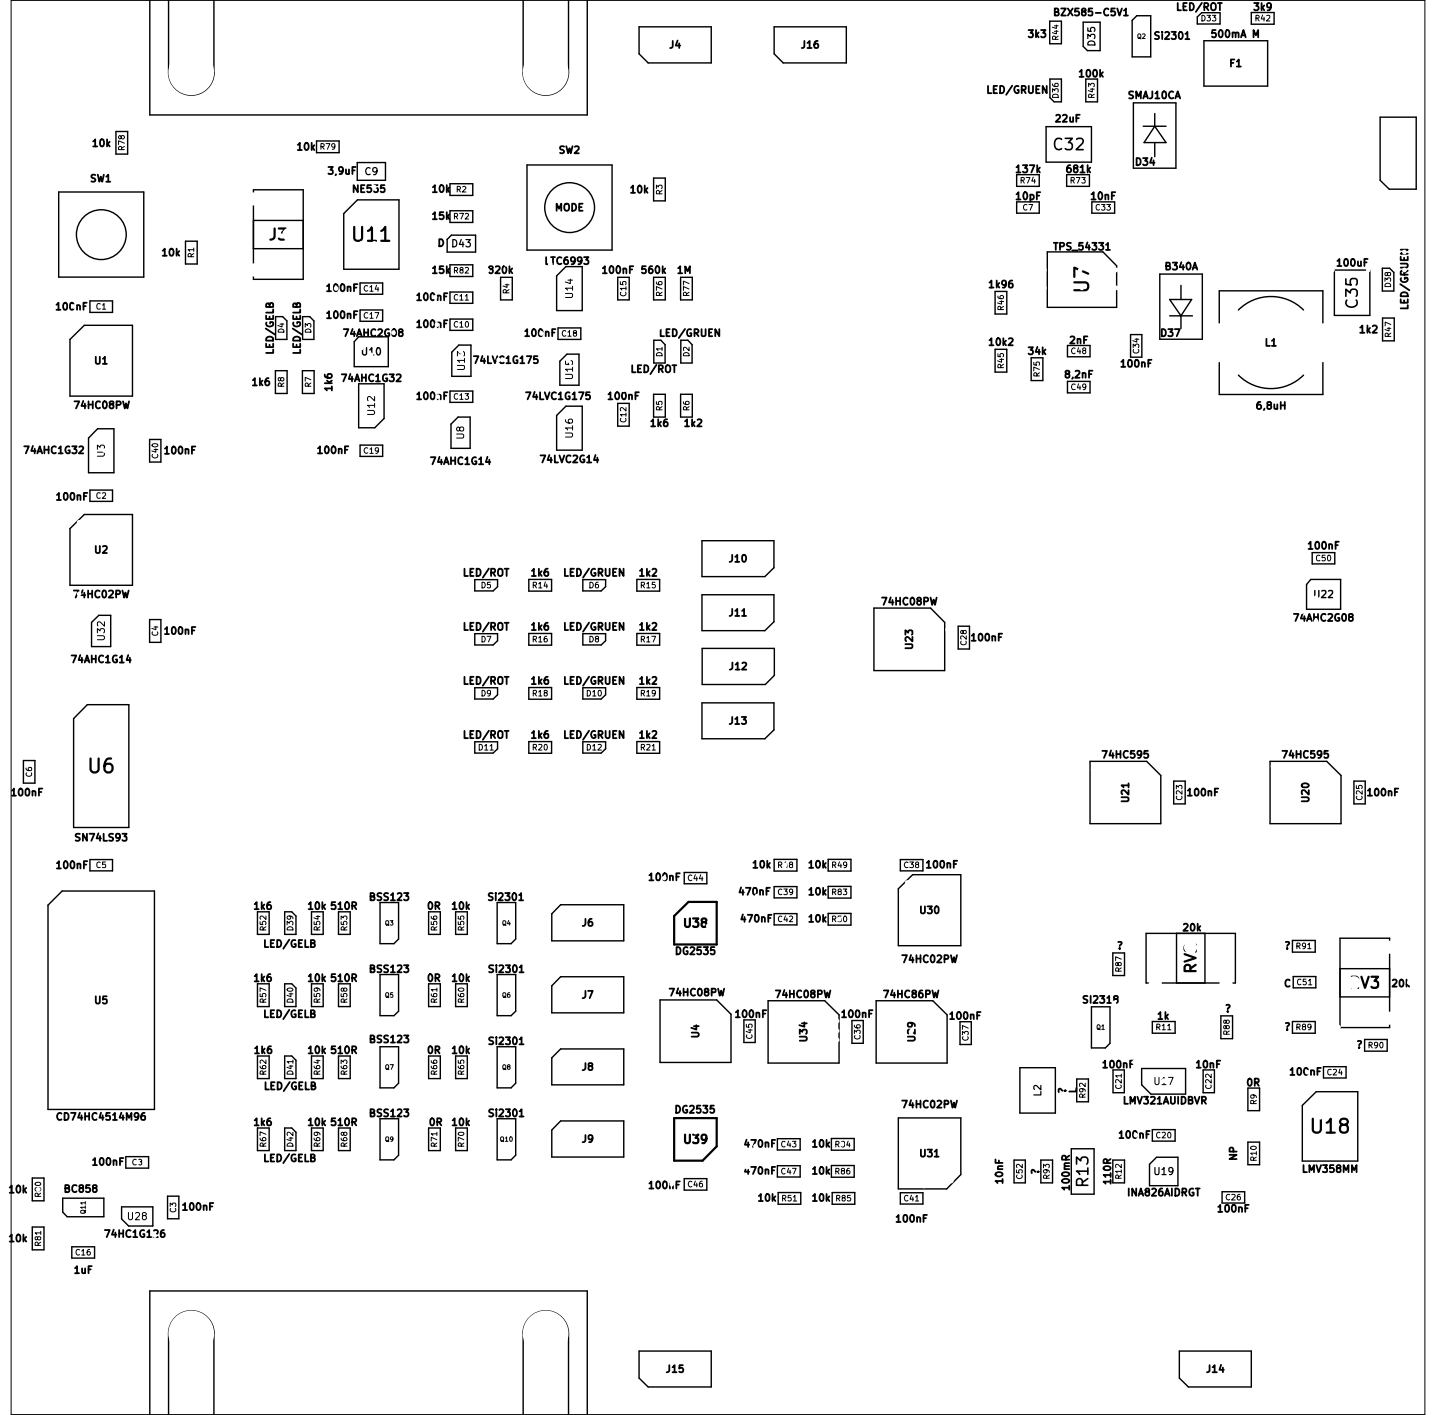
[picture p58: page 1]
