Oszimilian/Kabeltester/03_Dokumente/03_Datenblätter/Schnipsel/NR. 1.pdf

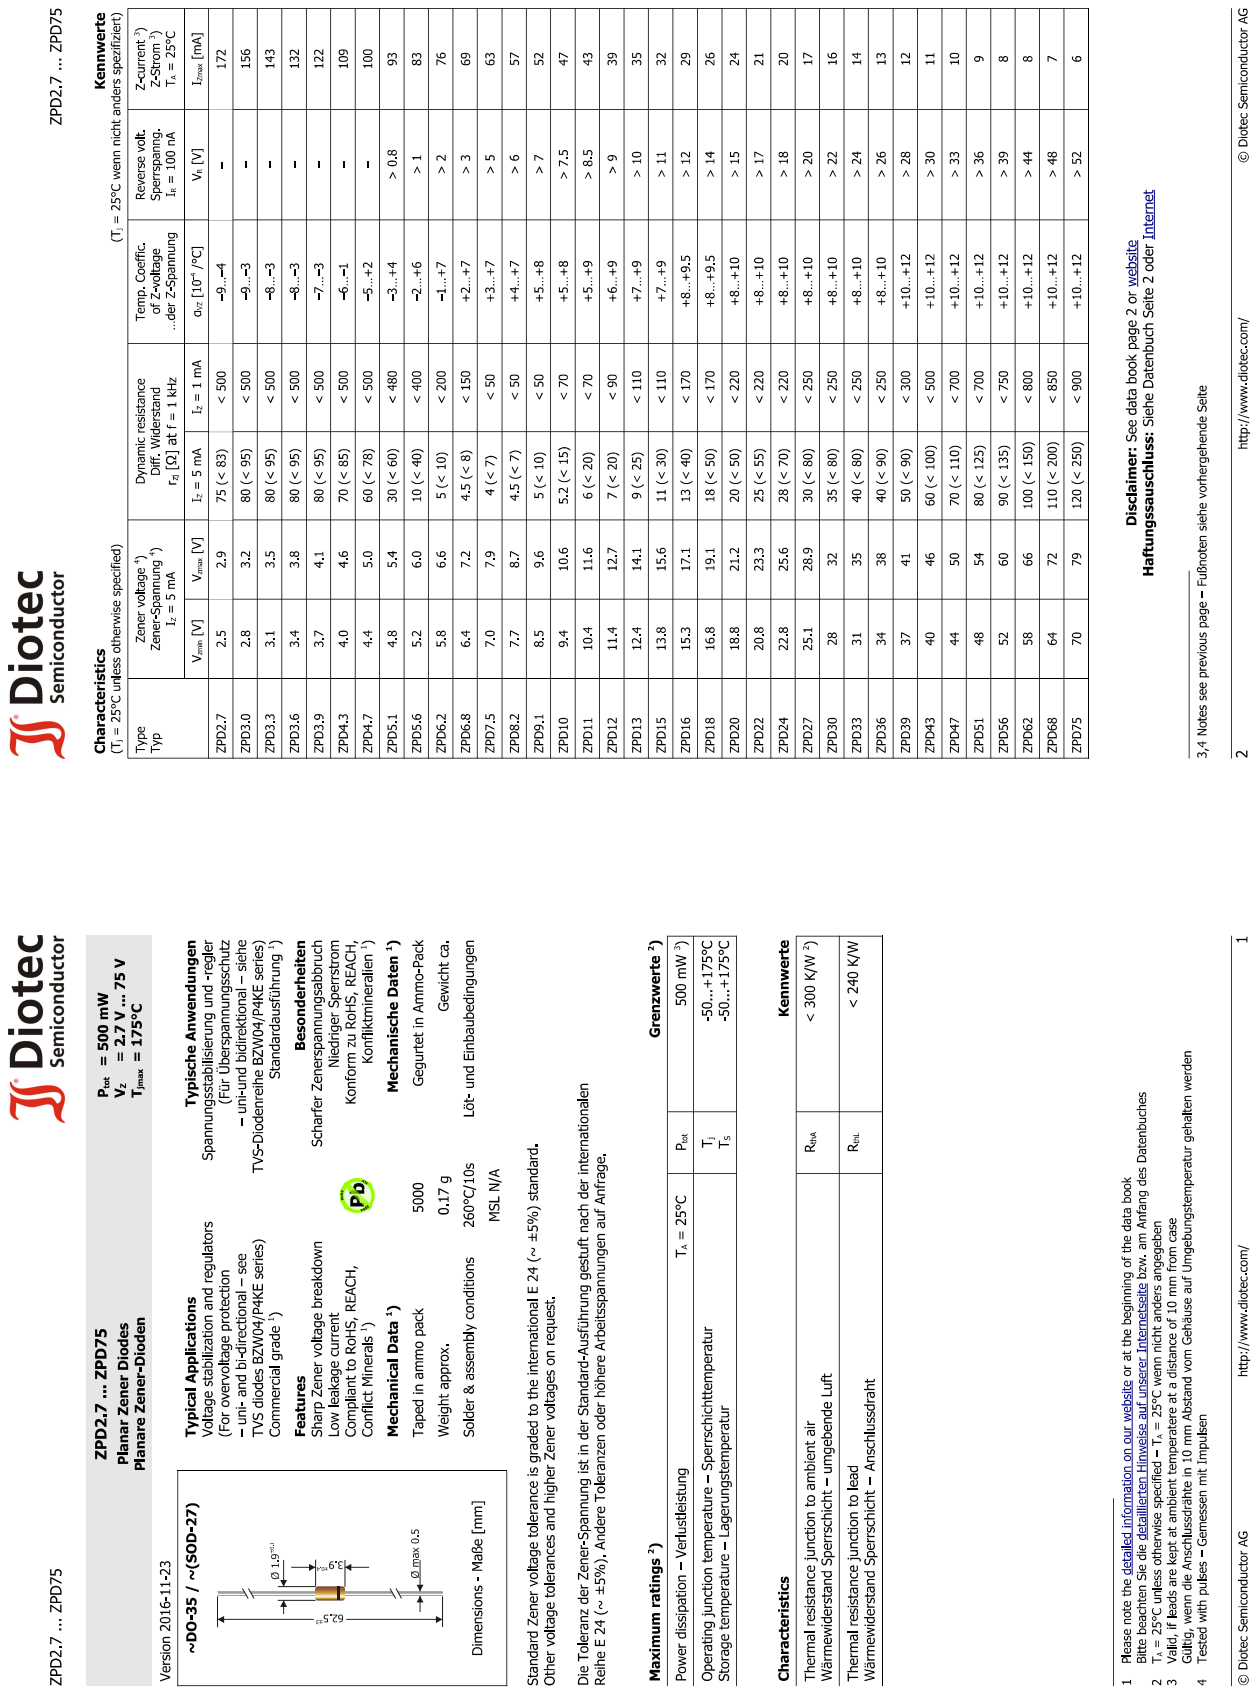
[picture p59: page 1]
