Oszimilian/Kabeltester/03_Dokumente/03_Datenblätter/Schnipsel/NR. 10.pdf

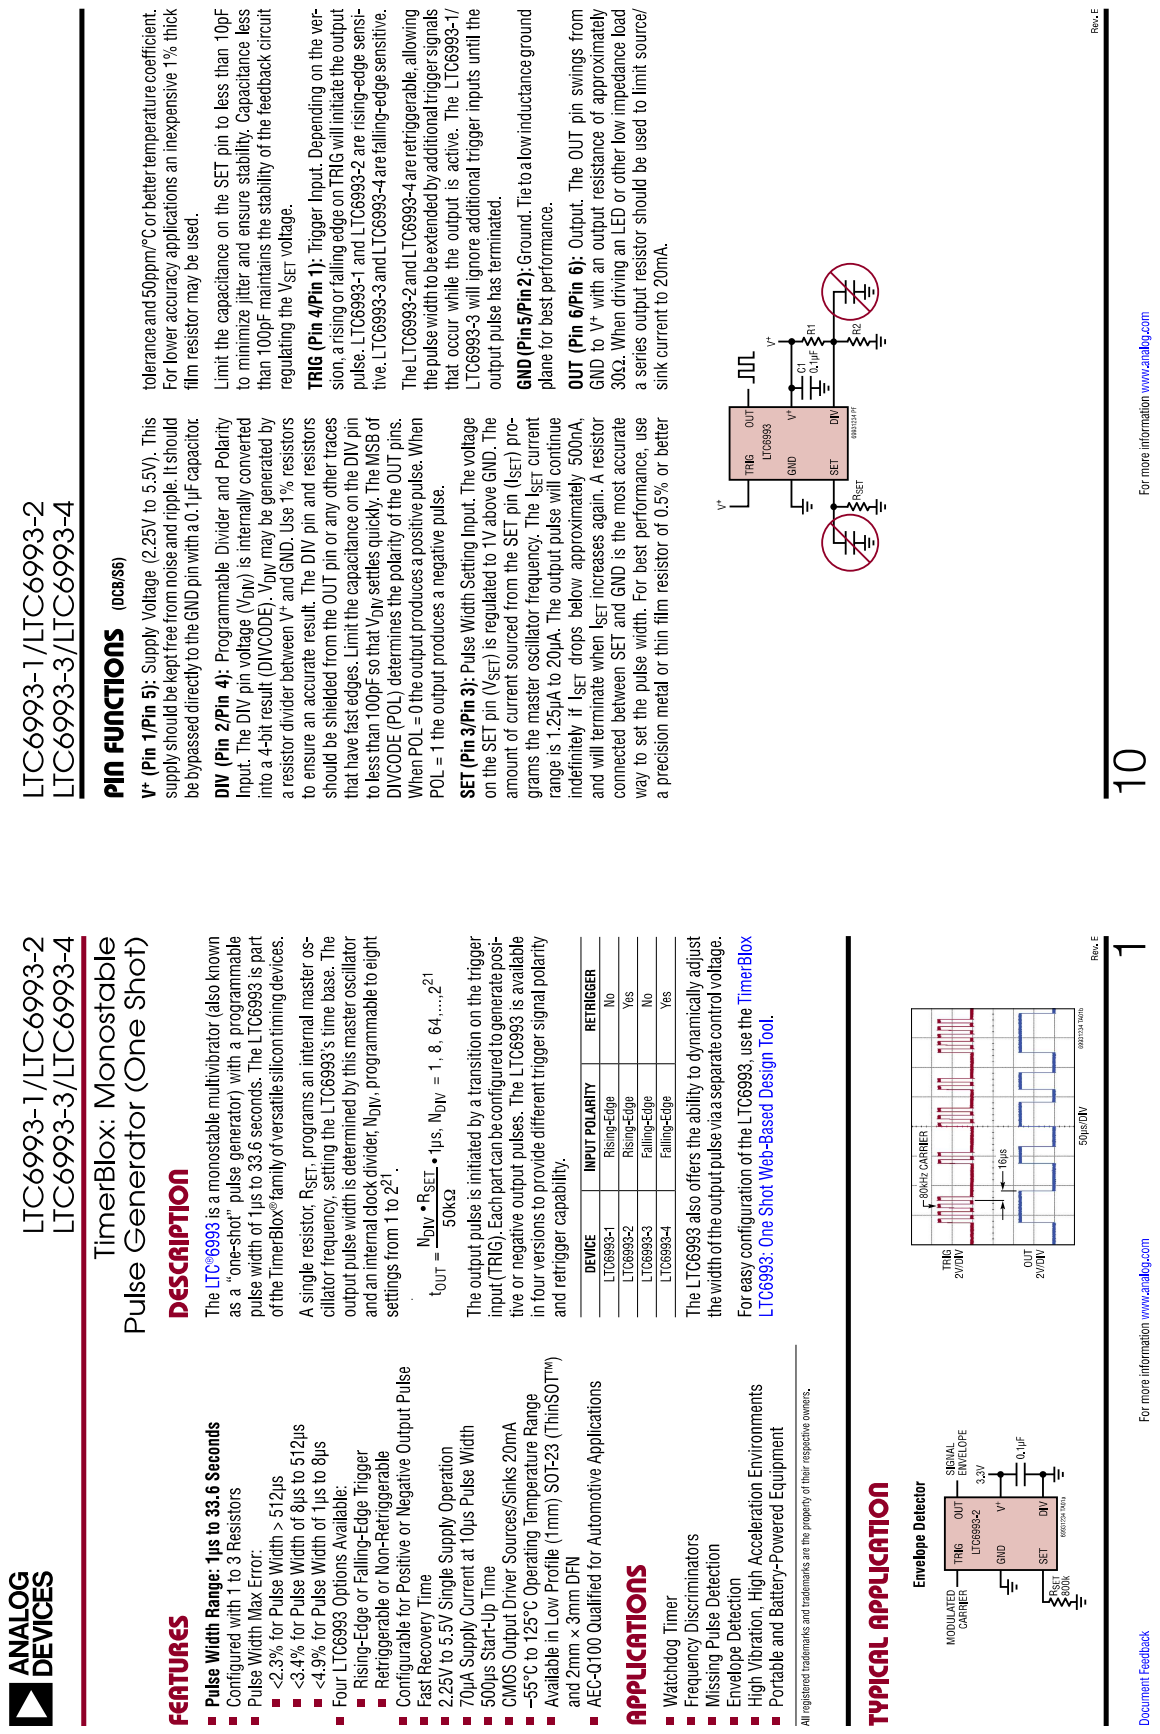
[picture p60: page 1]

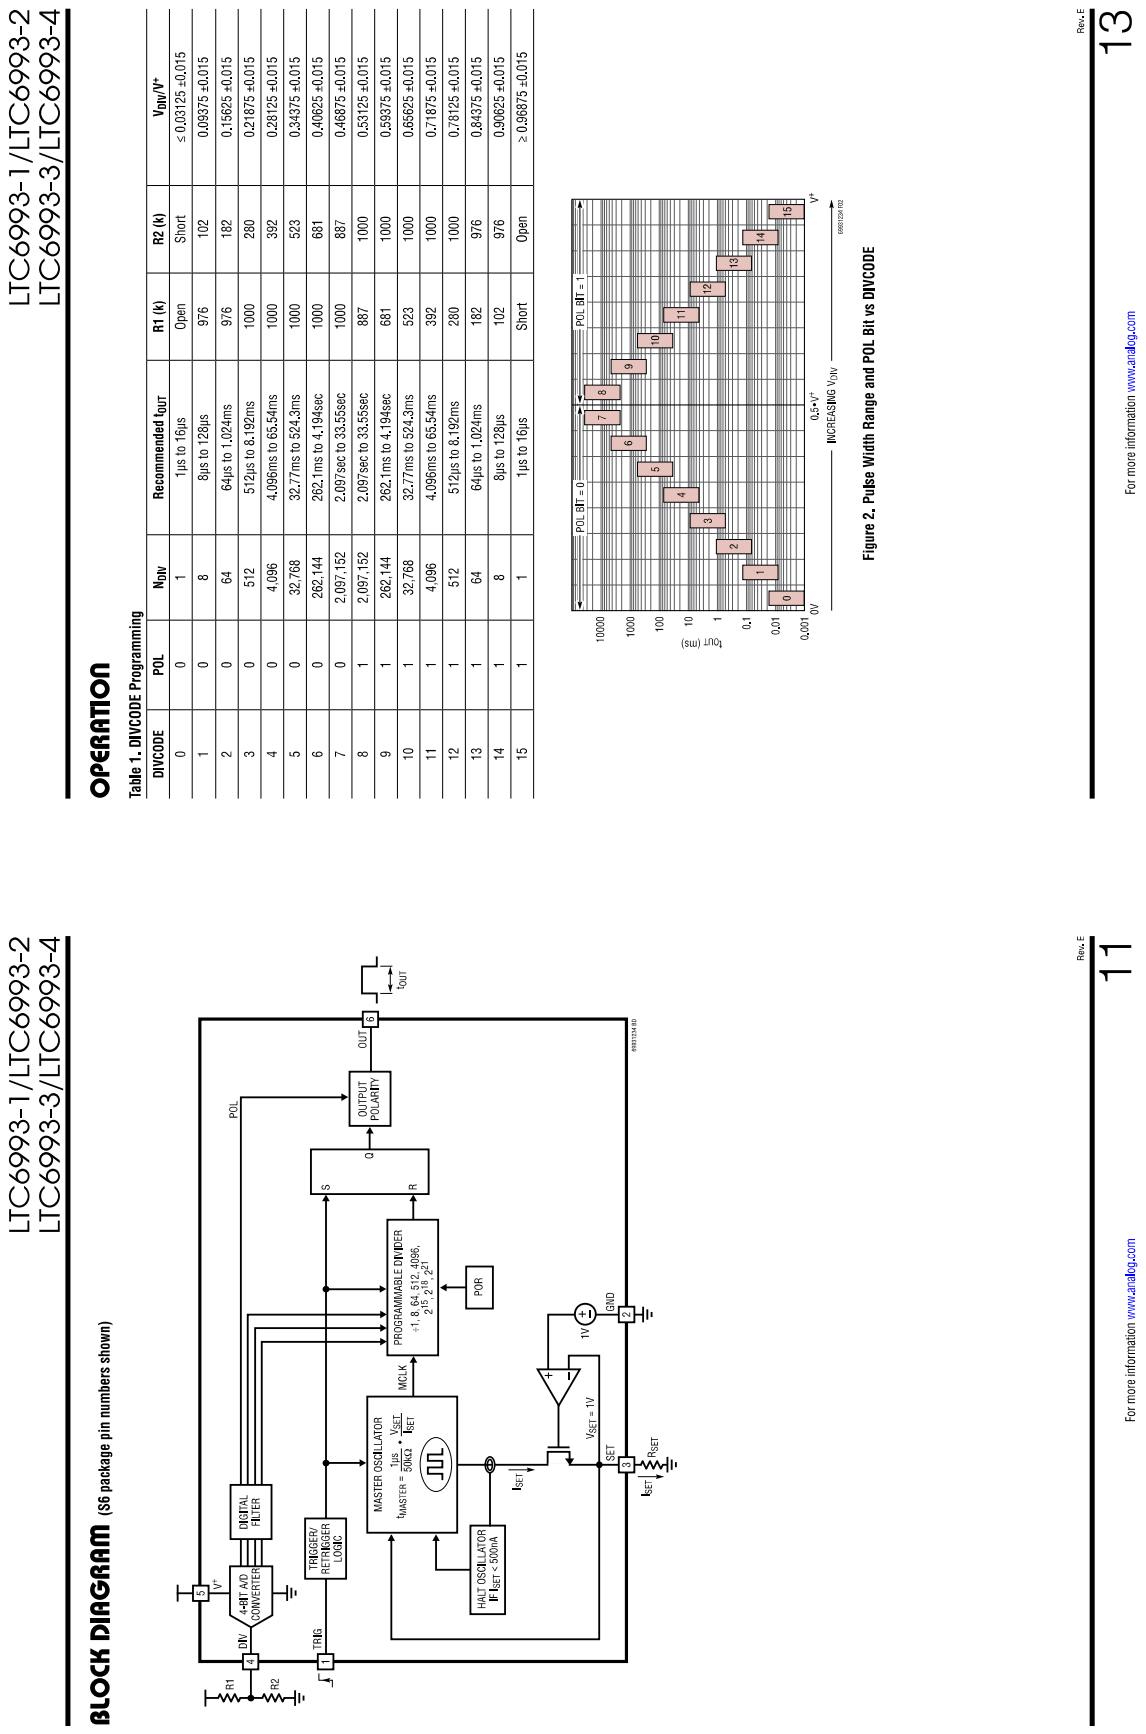
[picture p61: page 2]
