Oszimilian/Kabeltester/03_Dokumente/03_Datenblätter/Schnipsel/NR. 11.pdf

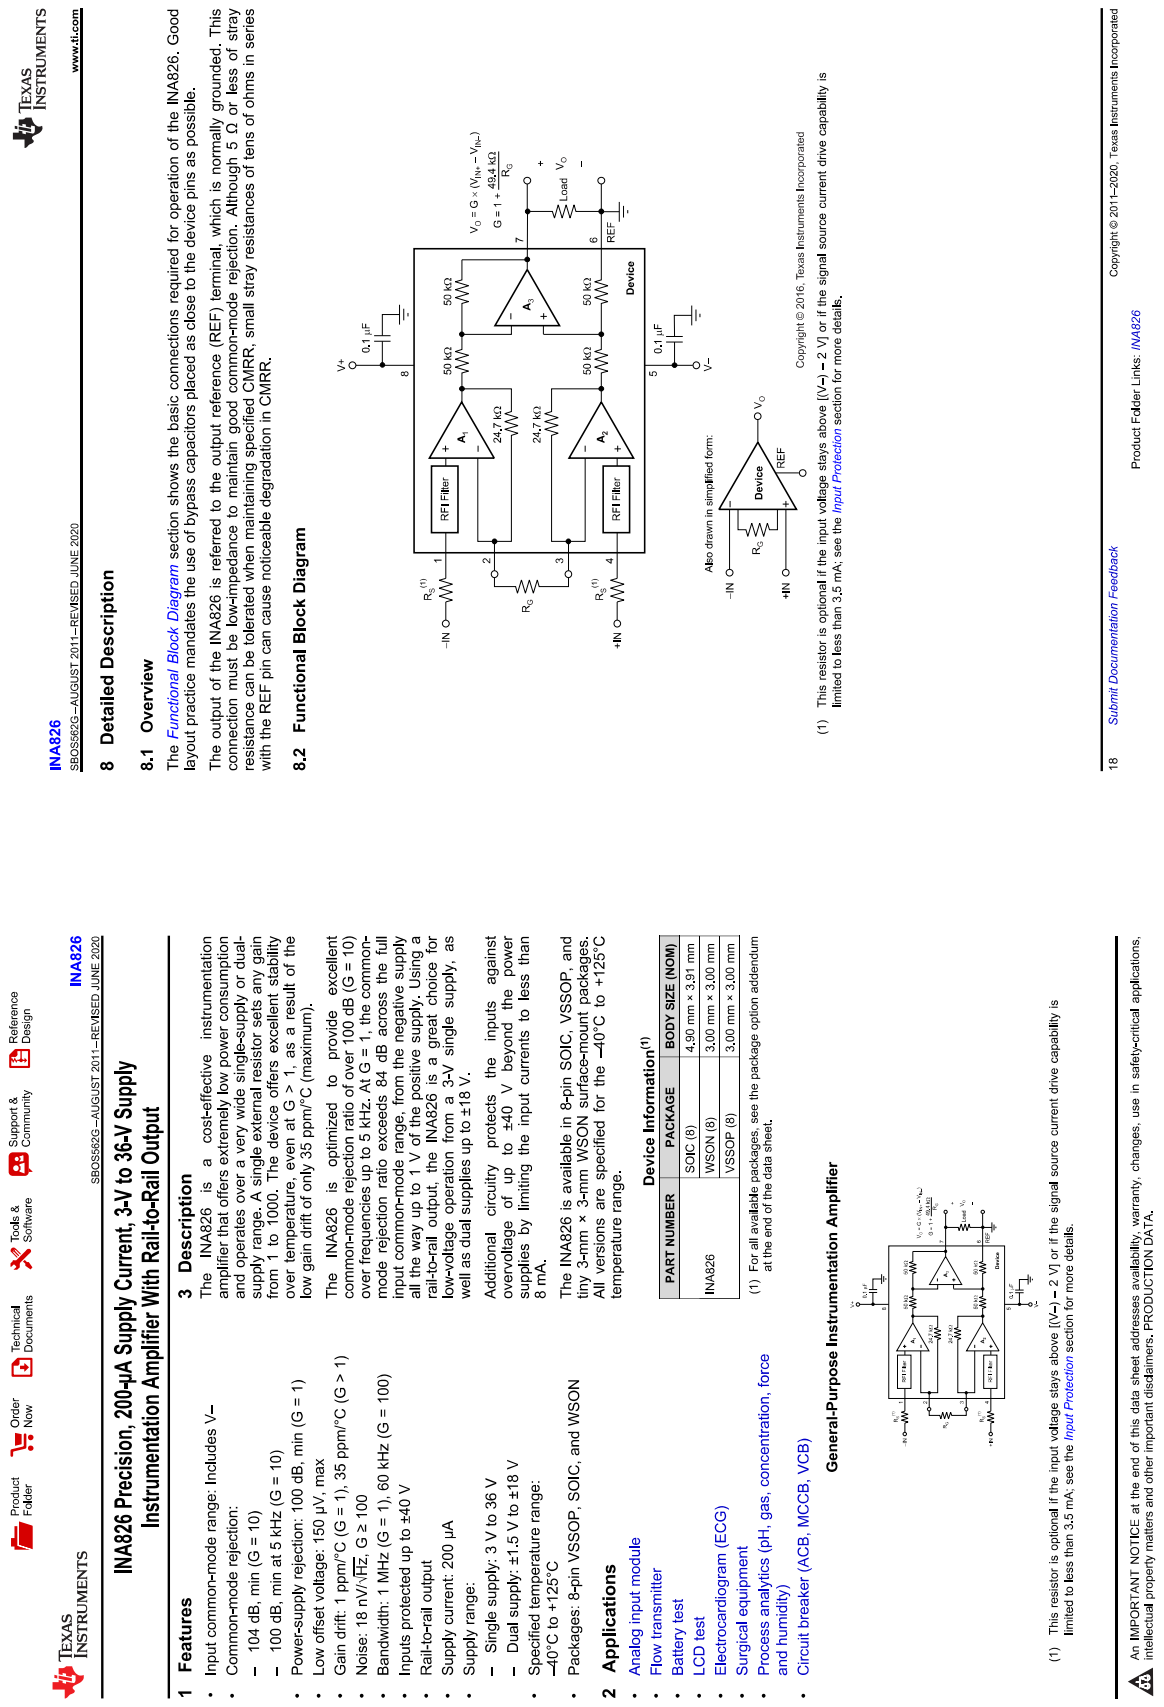
[picture p62: page 1]
