Oszimilian/Kabeltester/03_Dokumente/03_Datenblätter/Schnipsel/NR. 12.pdf

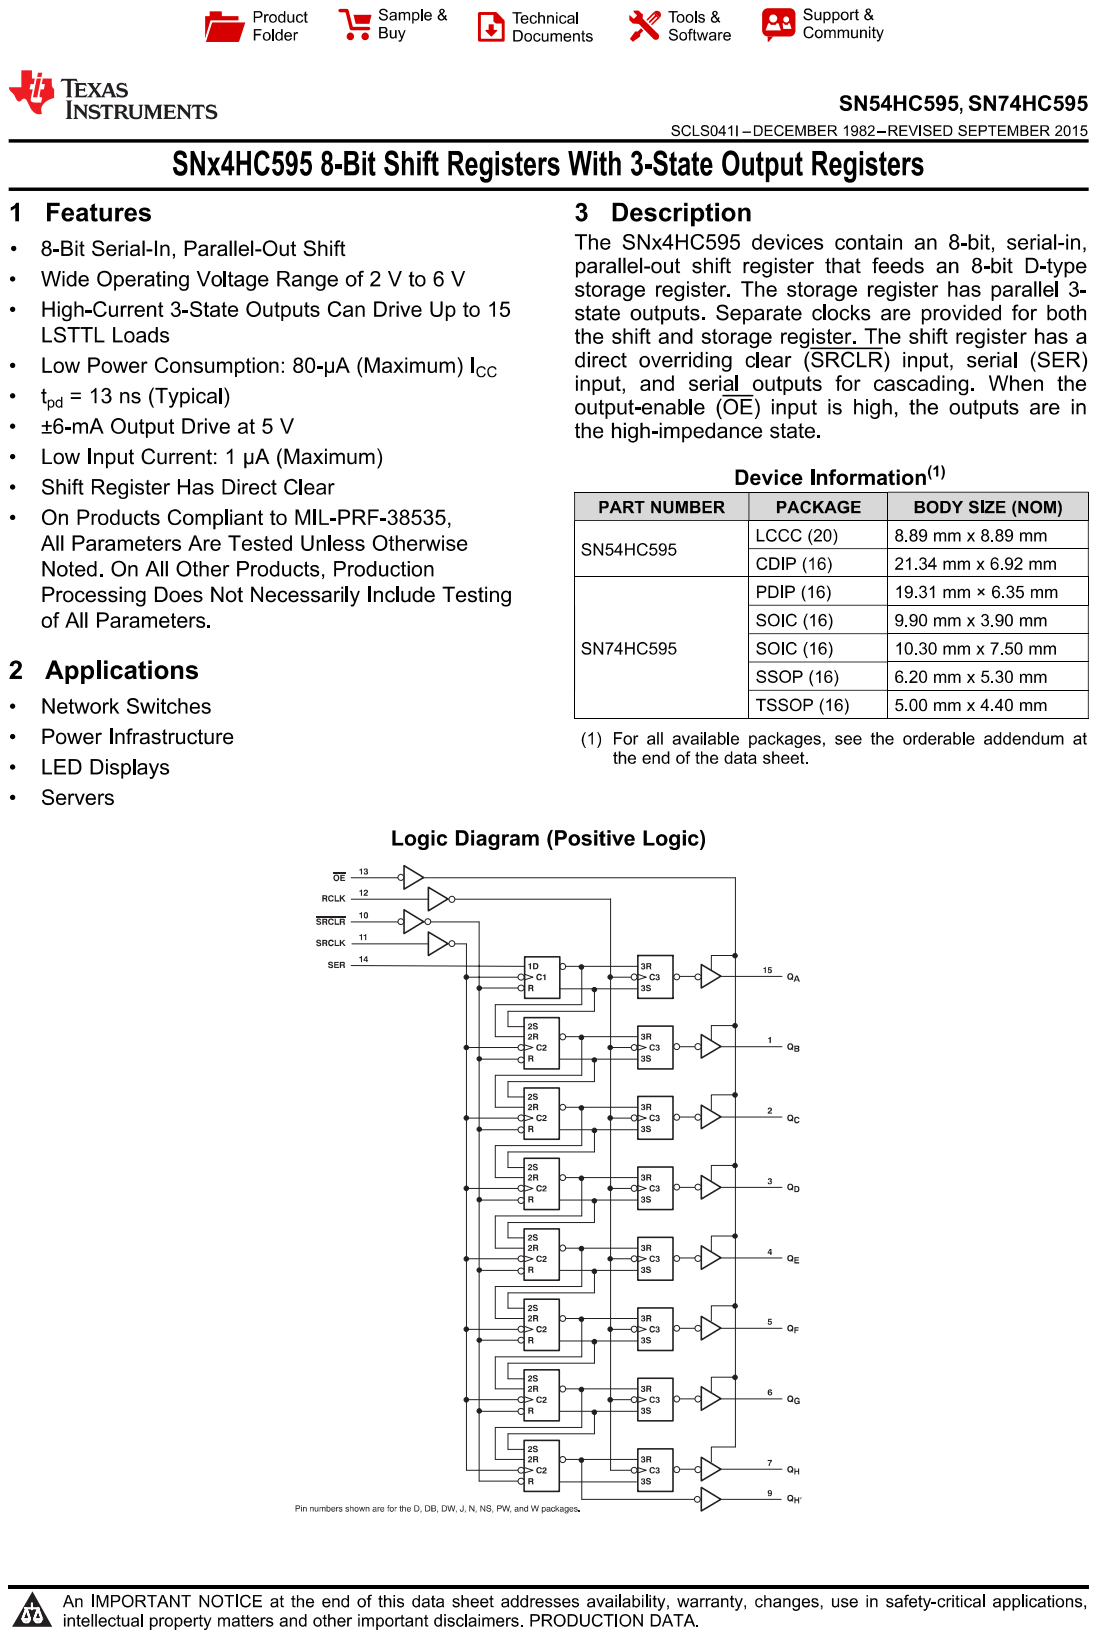
[picture p63: page 1]
