Oszimilian/Kabeltester/03_Dokumente/03_Datenblätter/Schnipsel/NR. 13.pdf

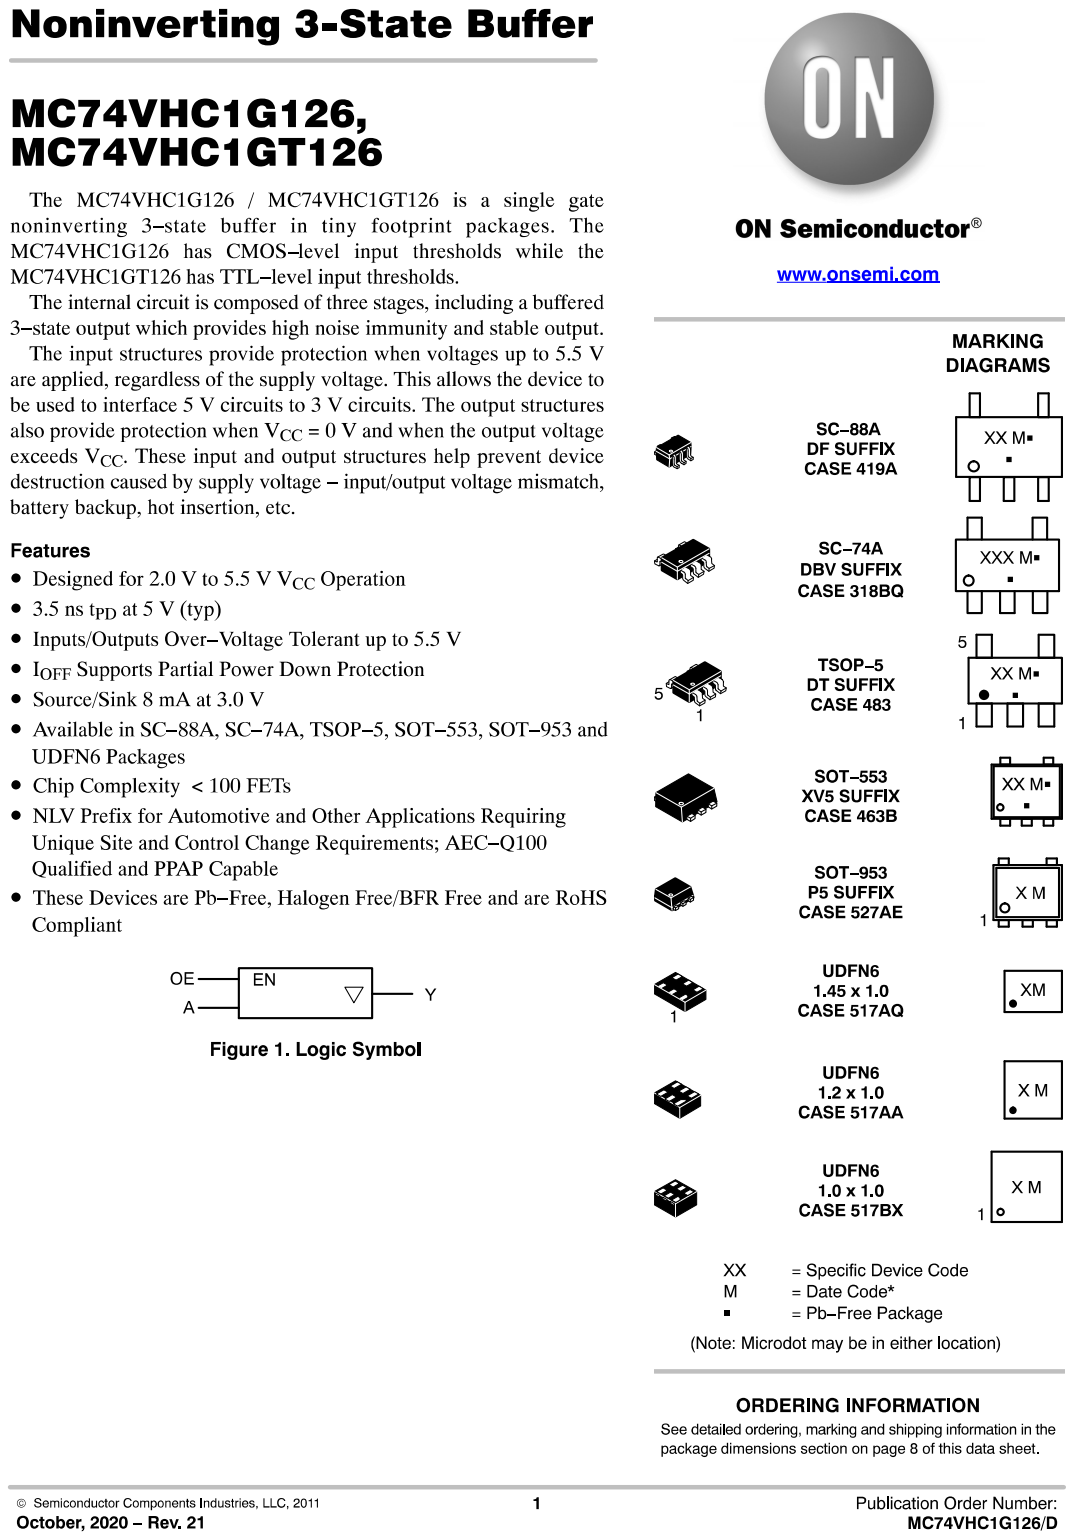
[picture p64: page 1]
