Oszimilian/Kabeltester/03_Dokumente/03_Datenblätter/Schnipsel/NR. 14.pdf

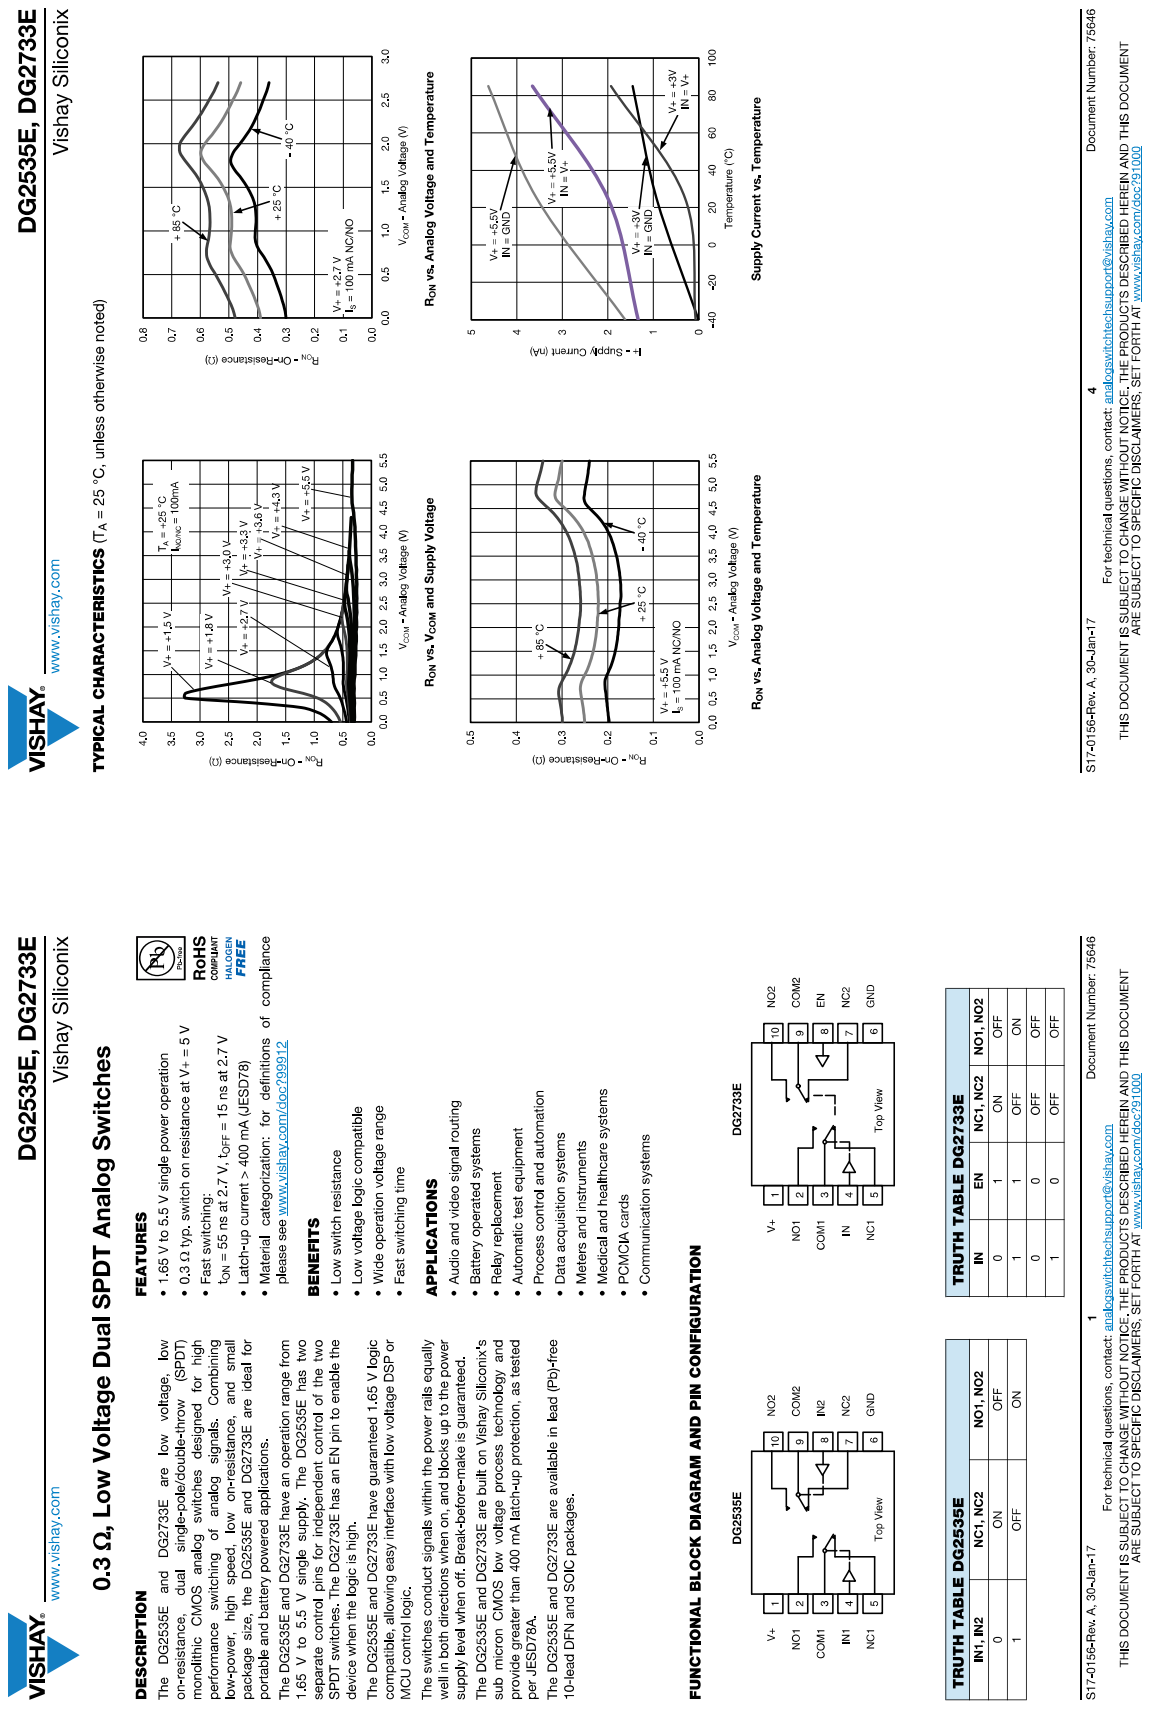
[picture p65: page 1]
