Oszimilian/Kabeltester/03_Dokumente/03_Datenblätter/Schnipsel/NR. 2.pdf

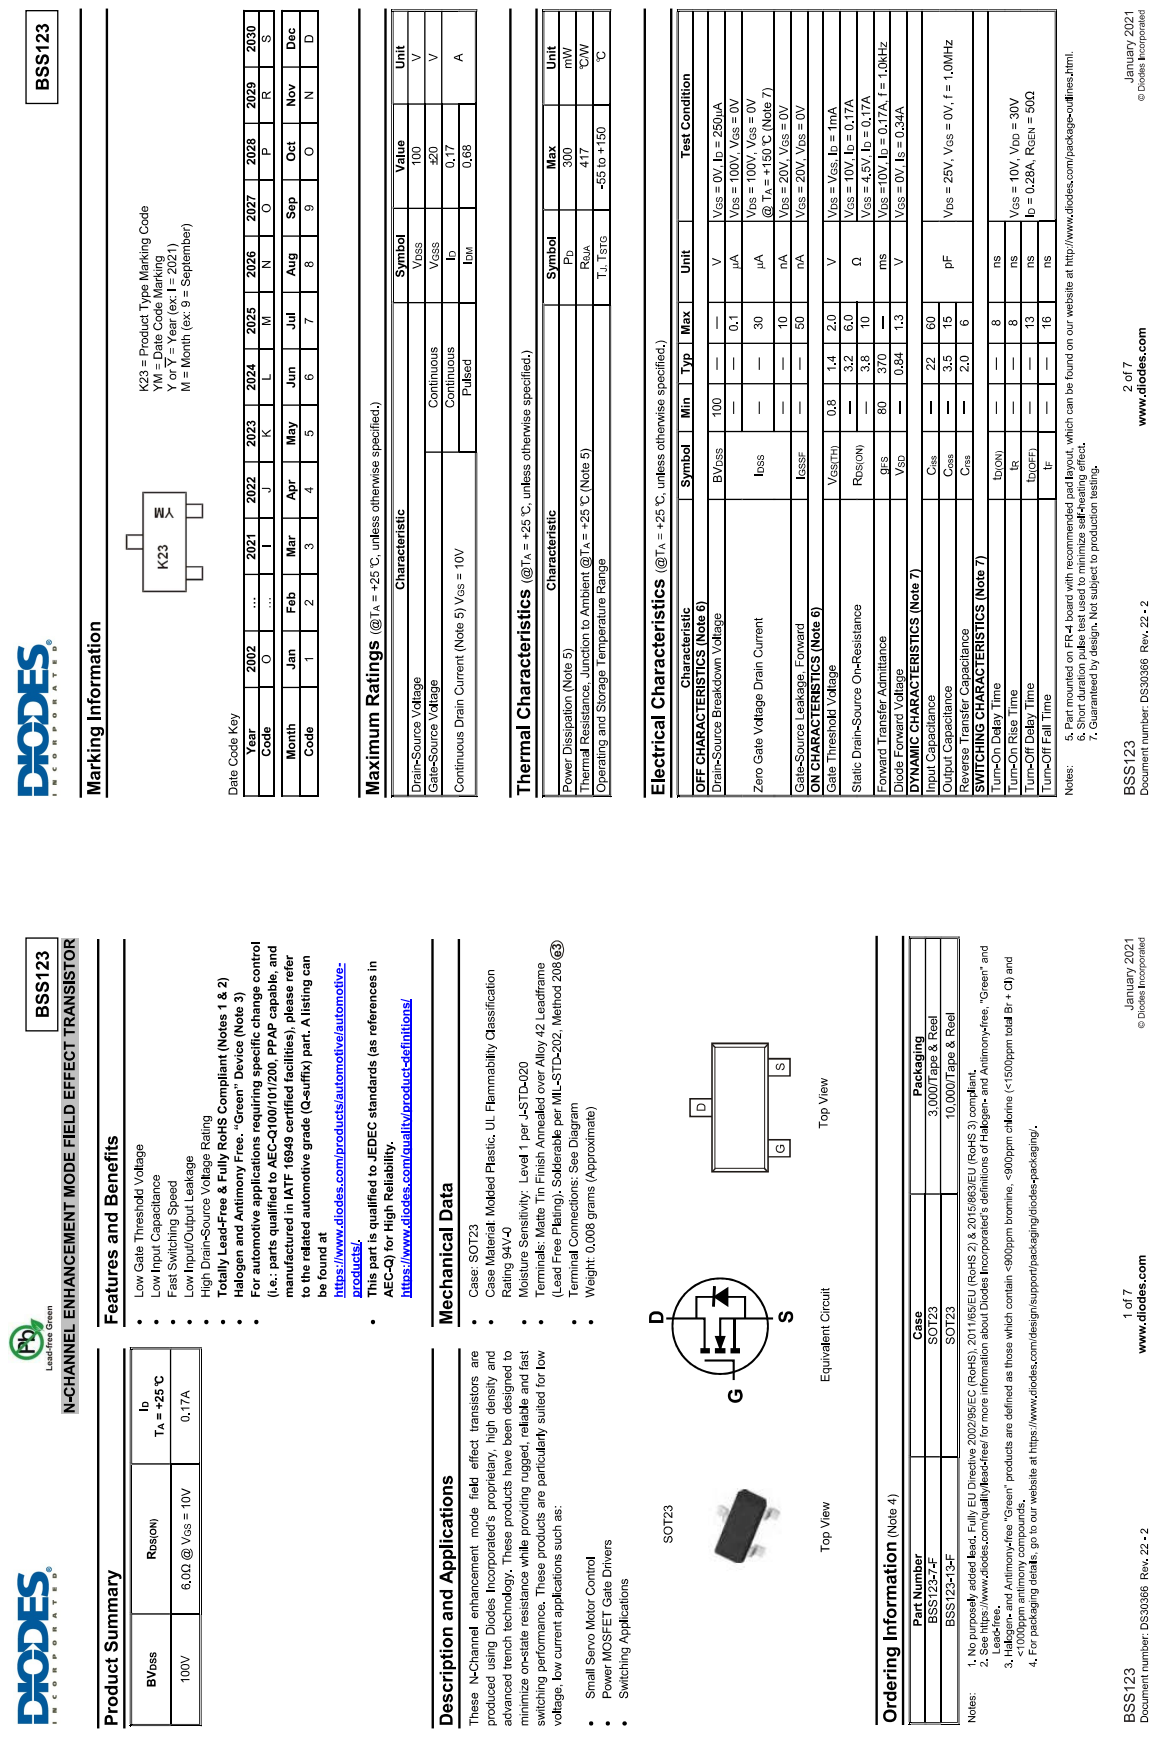
[picture p66: page 1]
