Oszimilian/Kabeltester/03_Dokumente/03_Datenblätter/Schnipsel/NR. 3.pdf

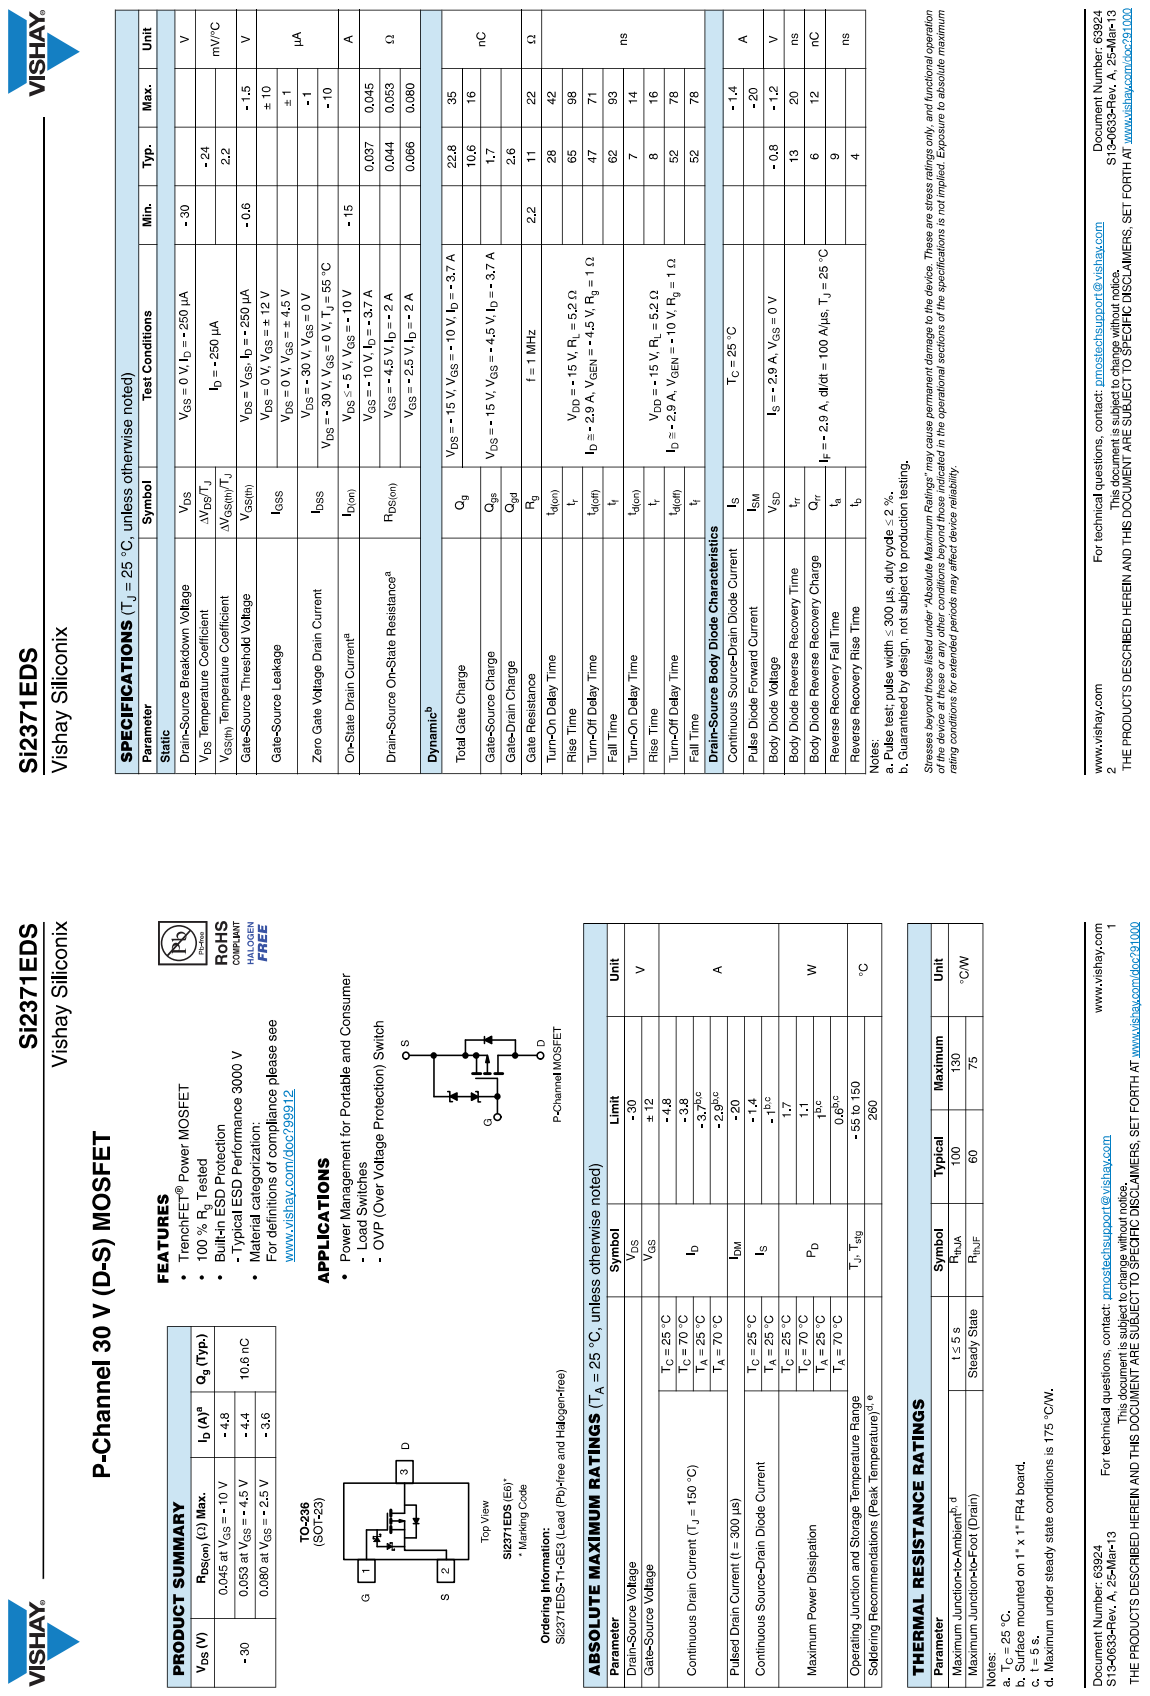
[picture p67: page 1]
