Oszimilian/Kabeltester/03_Dokumente/03_Datenblätter/Schnipsel/NR. 5.pdf

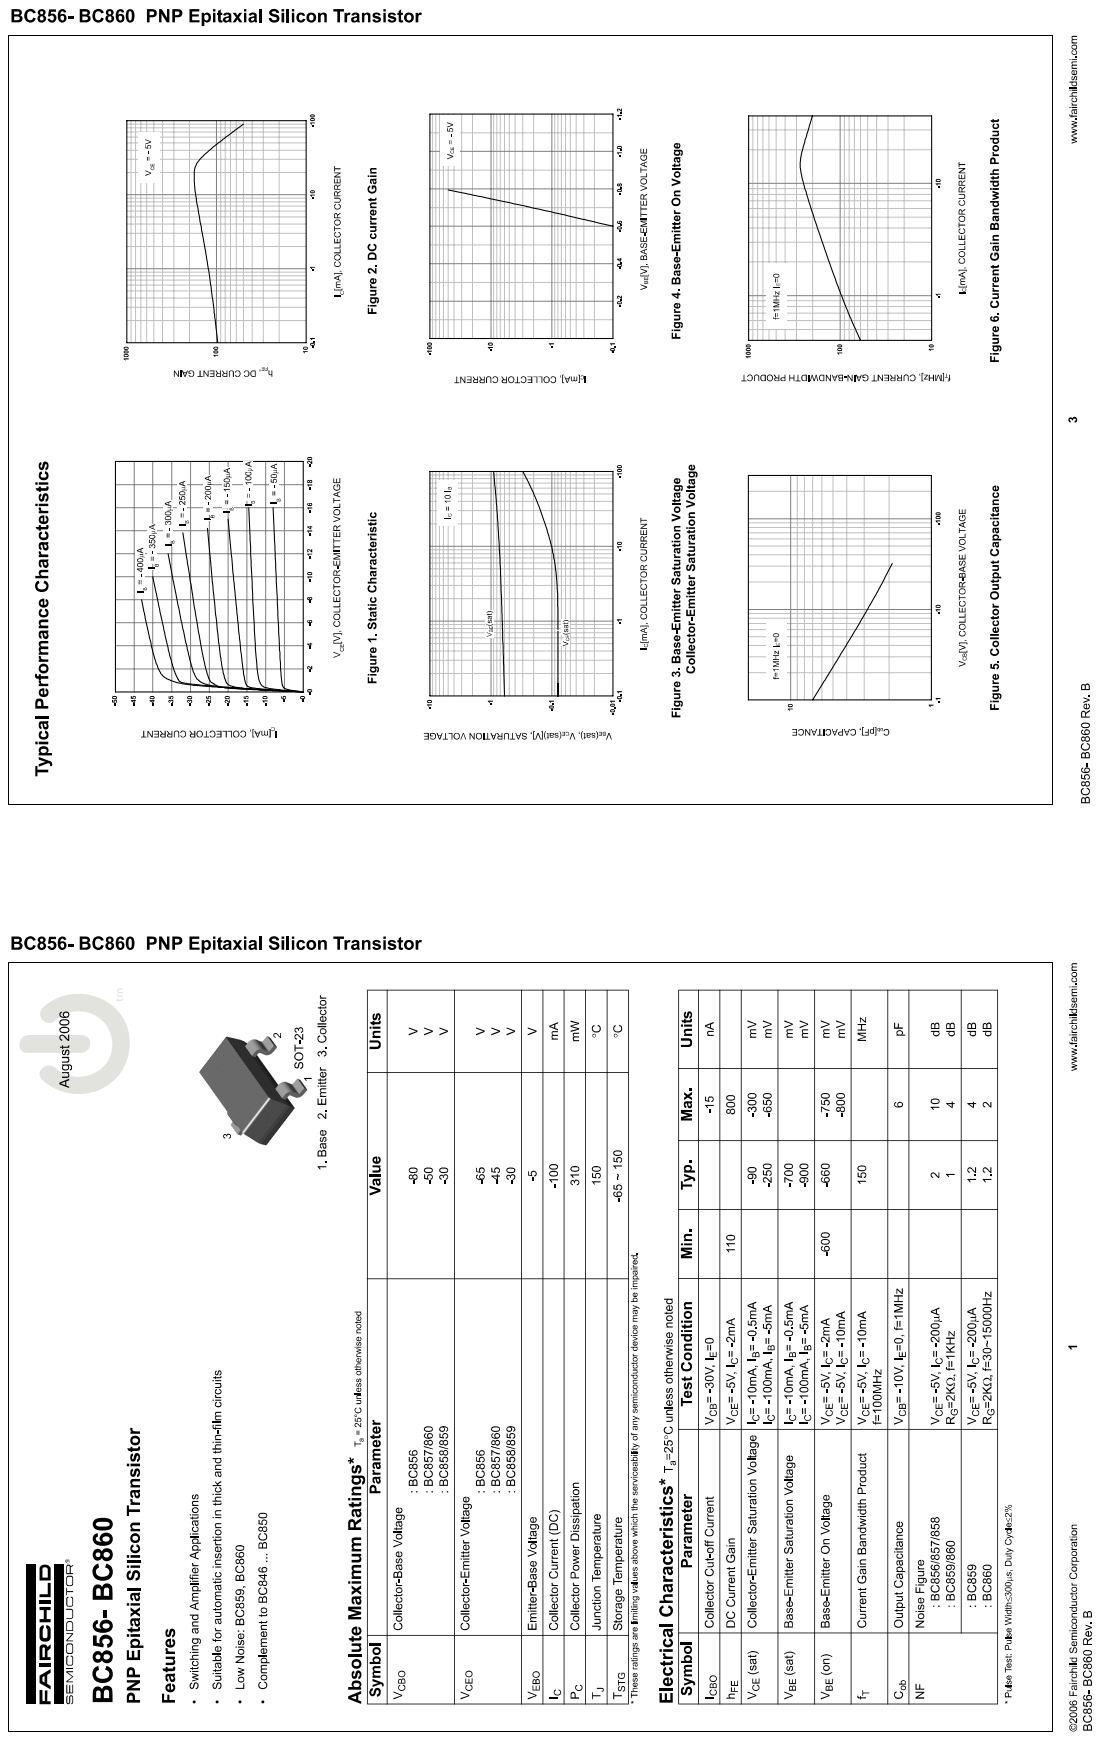
[picture p68: page 1]
