Oszimilian/Kabeltester/03_Dokumente/03_Datenblätter/Schnipsel/NR. 6.pdf

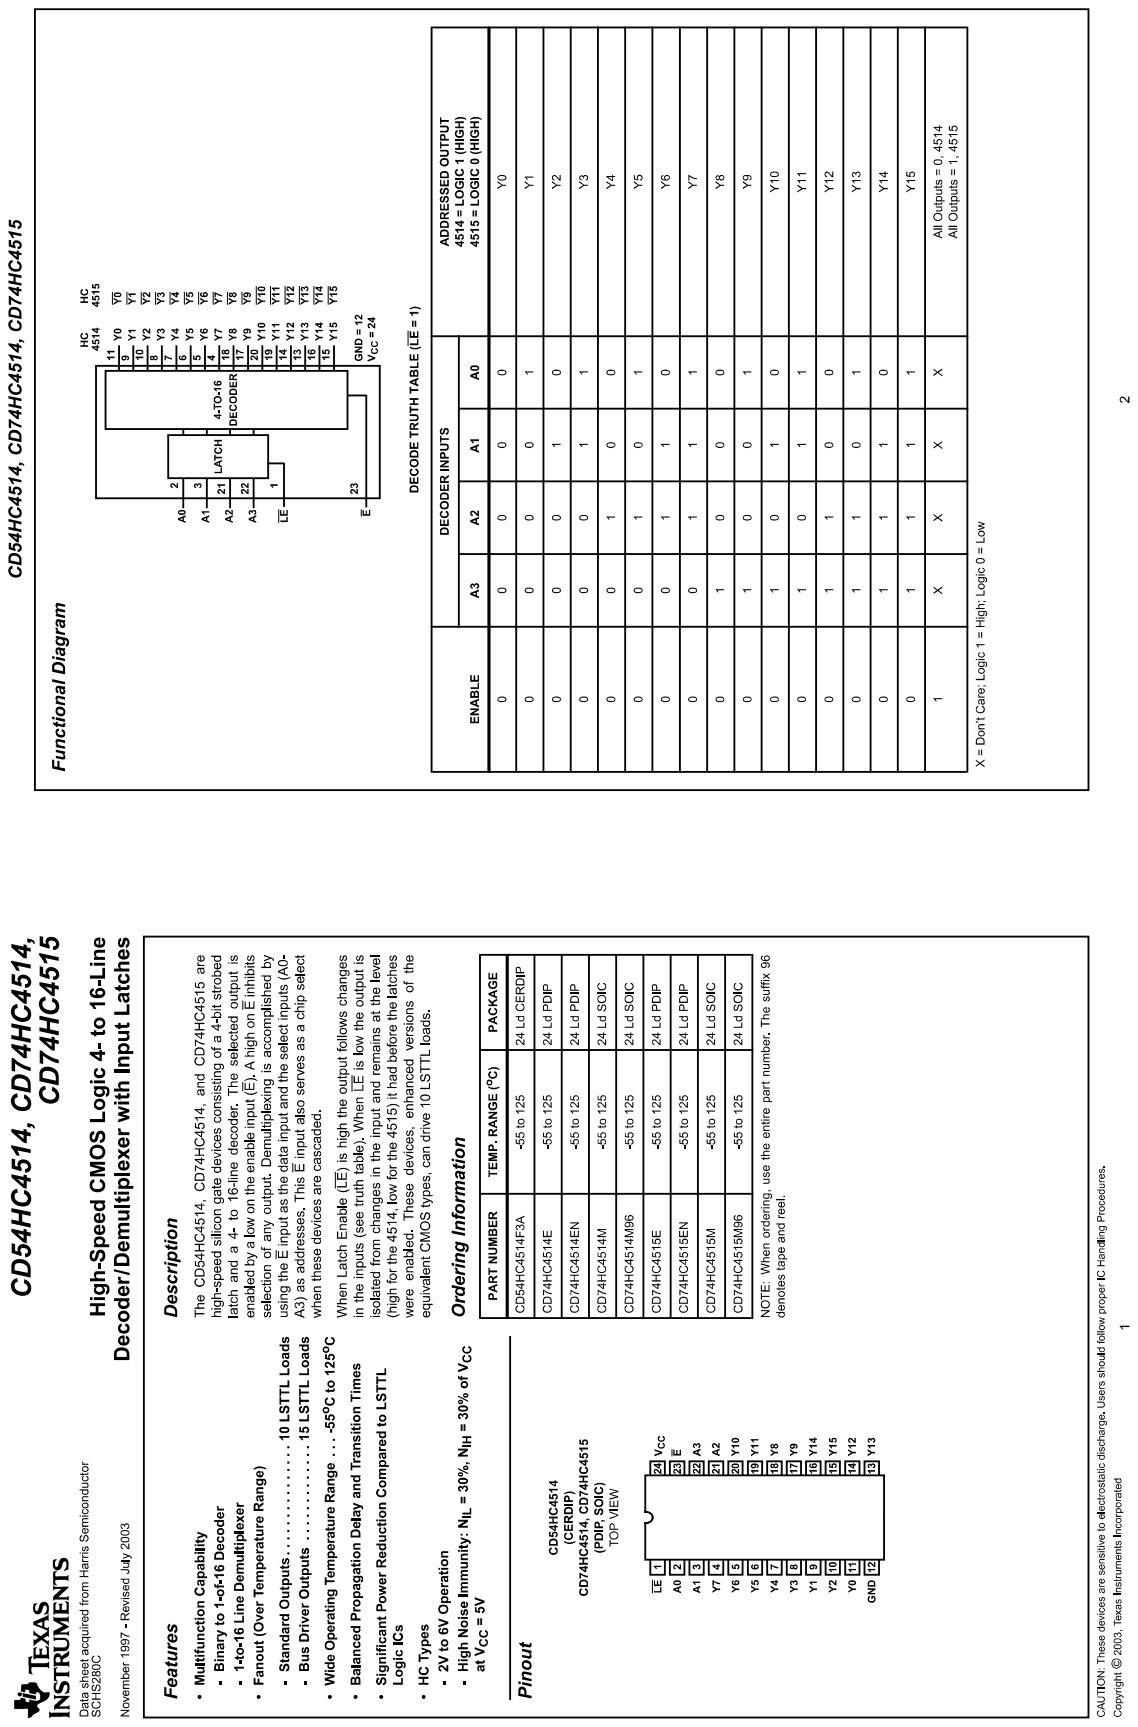
[picture p69: page 1]
