Oszimilian/Kabeltester/03_Dokumente/03_Datenblätter/Schnipsel/NR. 7.pdf

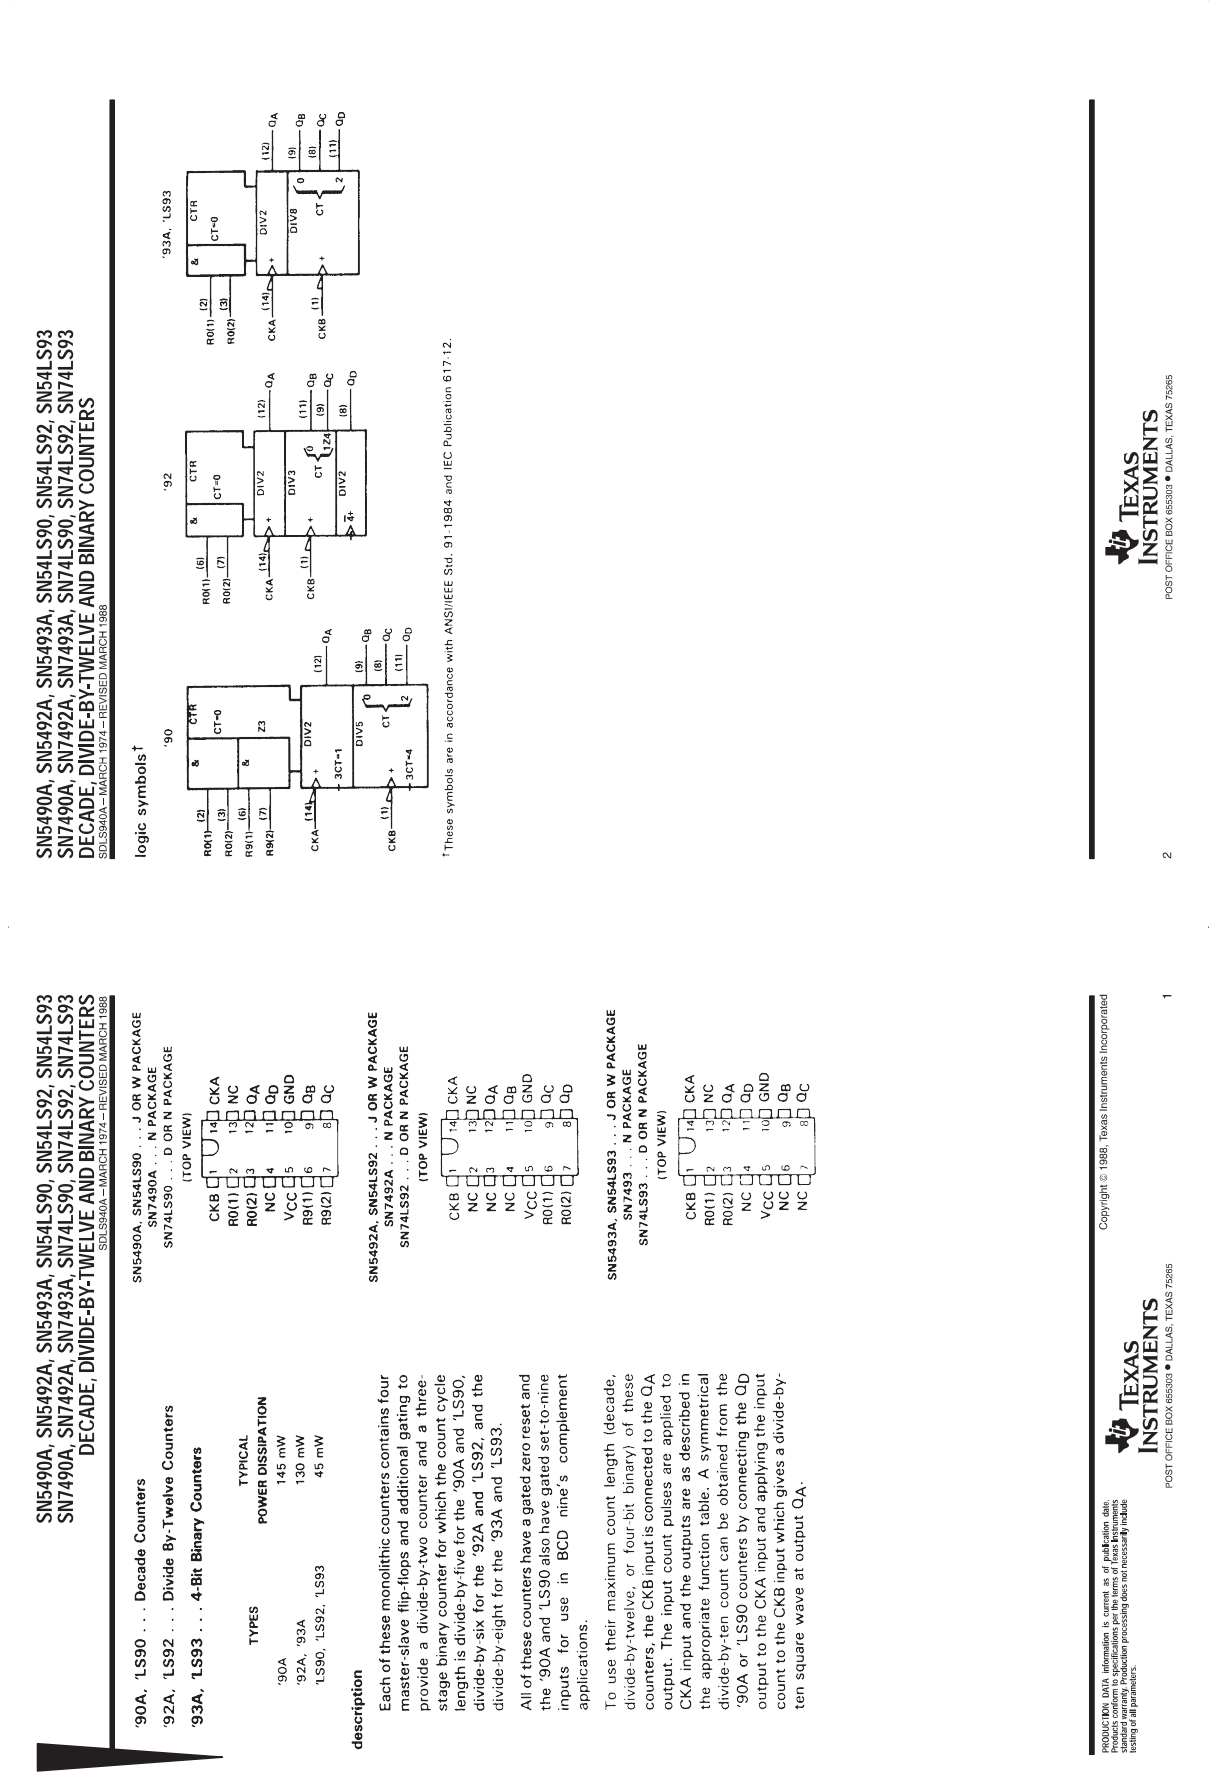
[picture p70: page 1]

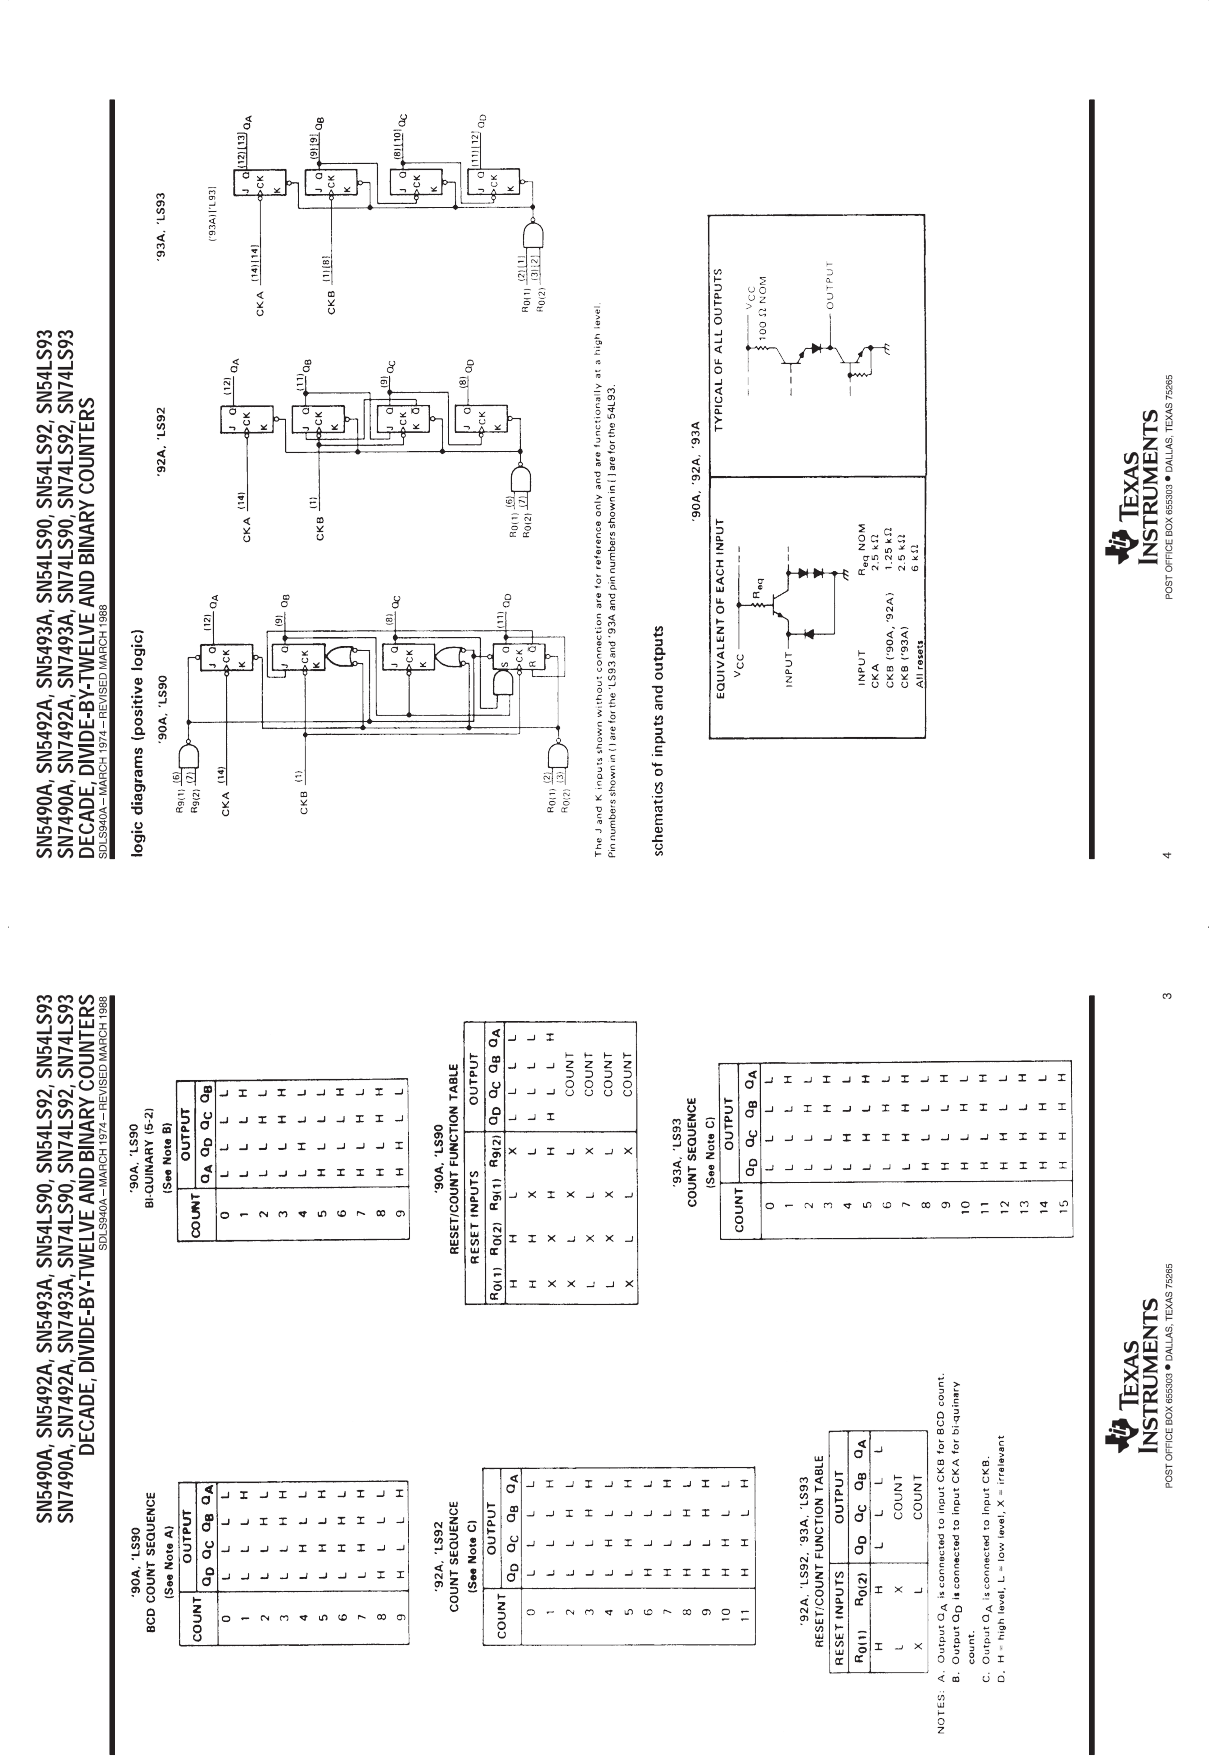
[picture p71: page 2]
