Oszimilian/Kabeltester/03_Dokumente/03_Datenblätter/Schnipsel/NR. 8.pdf

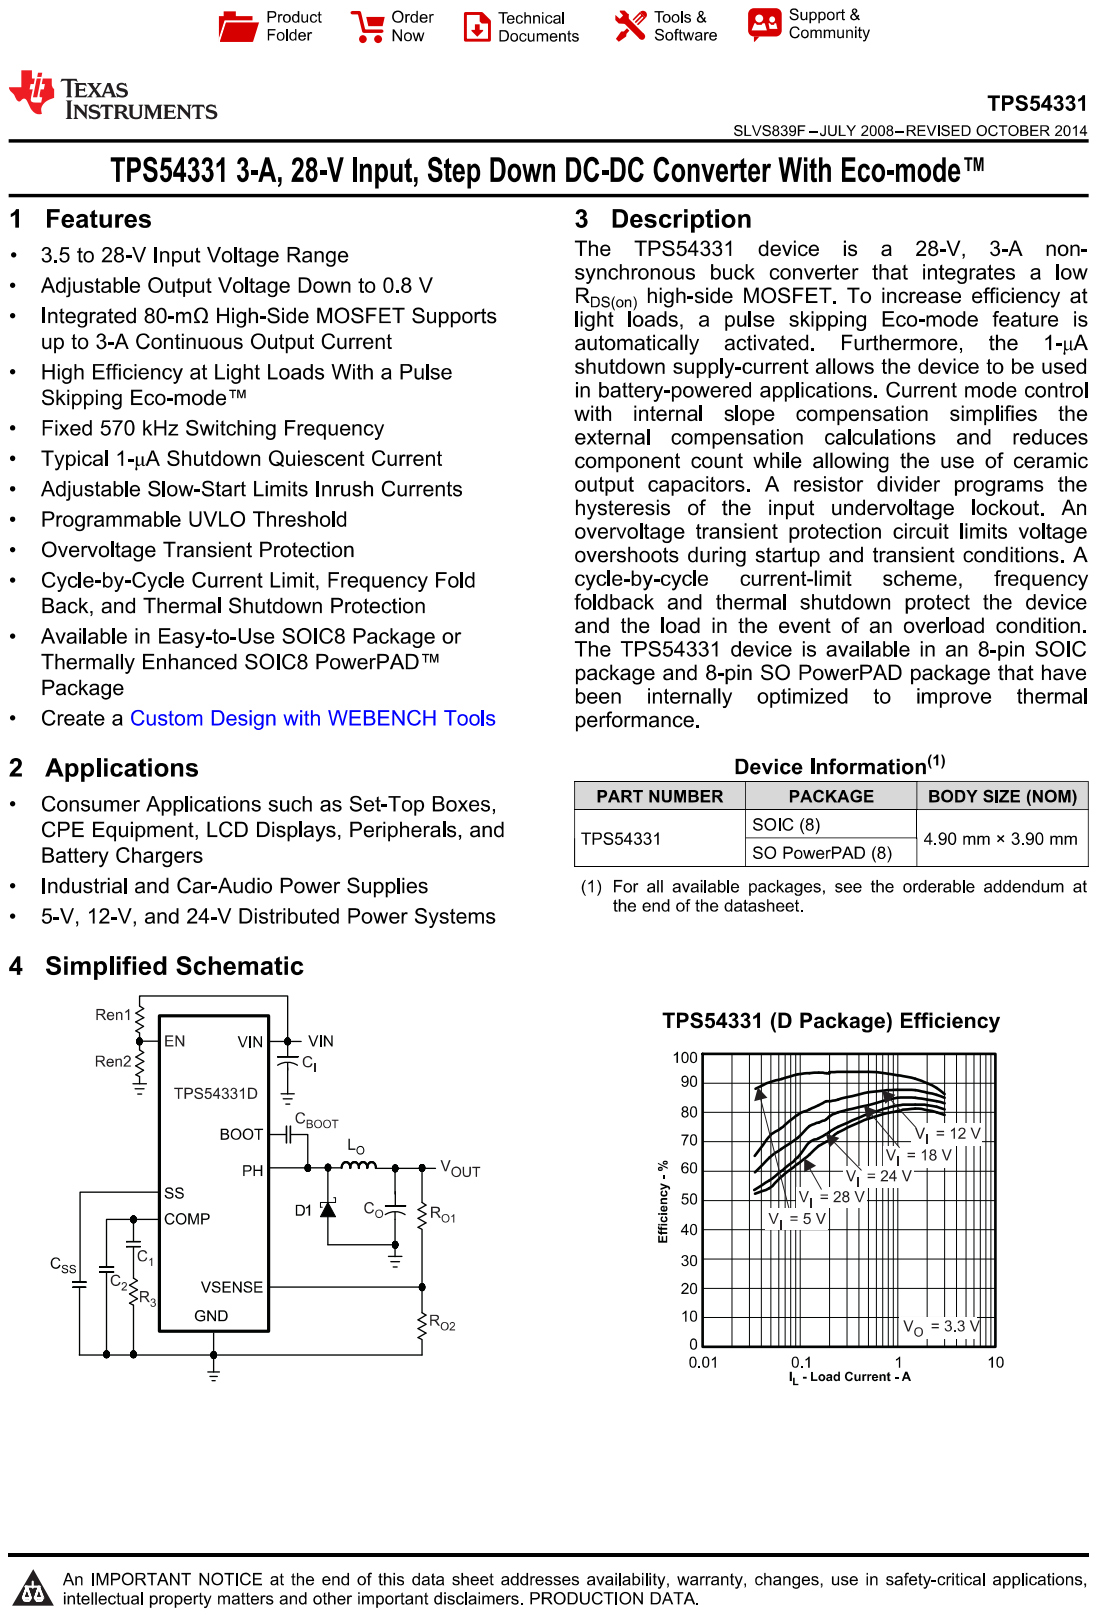
[picture p72: page 1]
