Oszimilian/Kabeltester/03_Dokumente/03_Datenblätter/Schnipsel/NR. 9.pdf

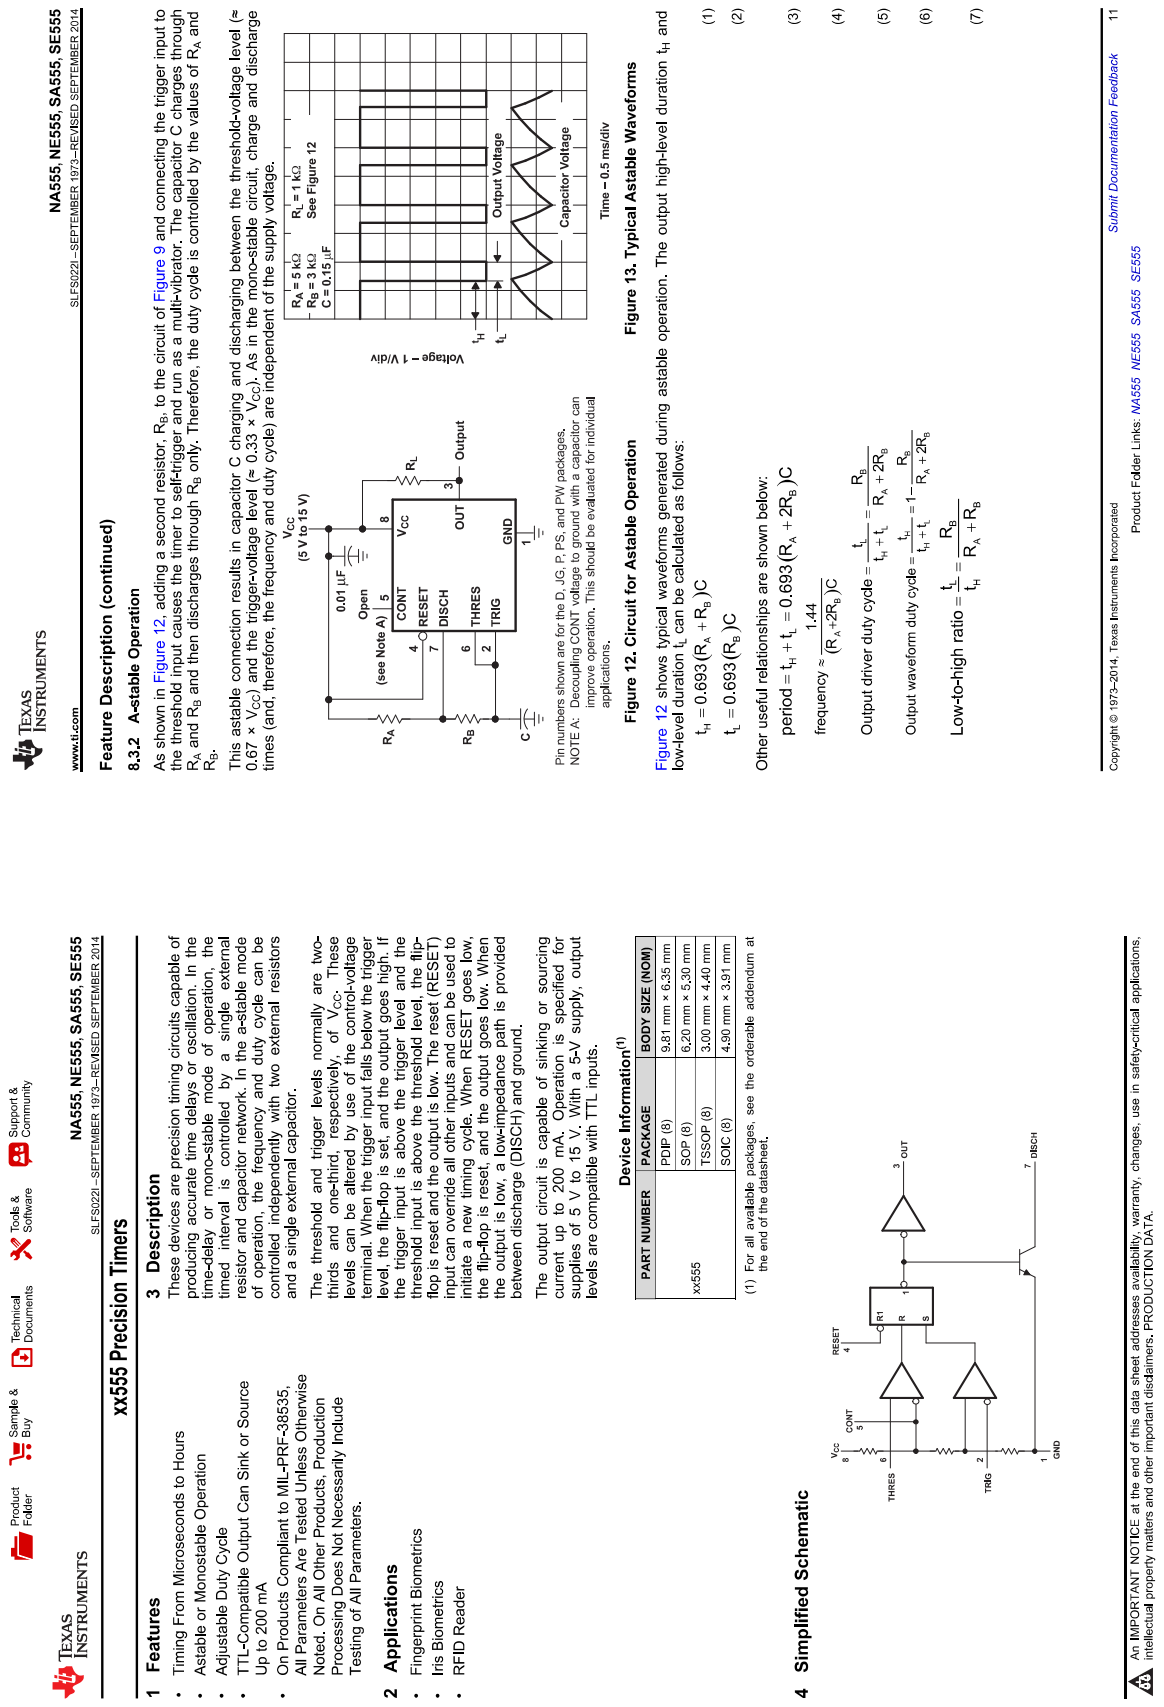
[picture p73: page 1]
