Oszimilian/Kabeltester/03_Dokumente/02_Projektdokumentation/03_Sonstiges/Blockschaltplan_Kabeltester.pdf

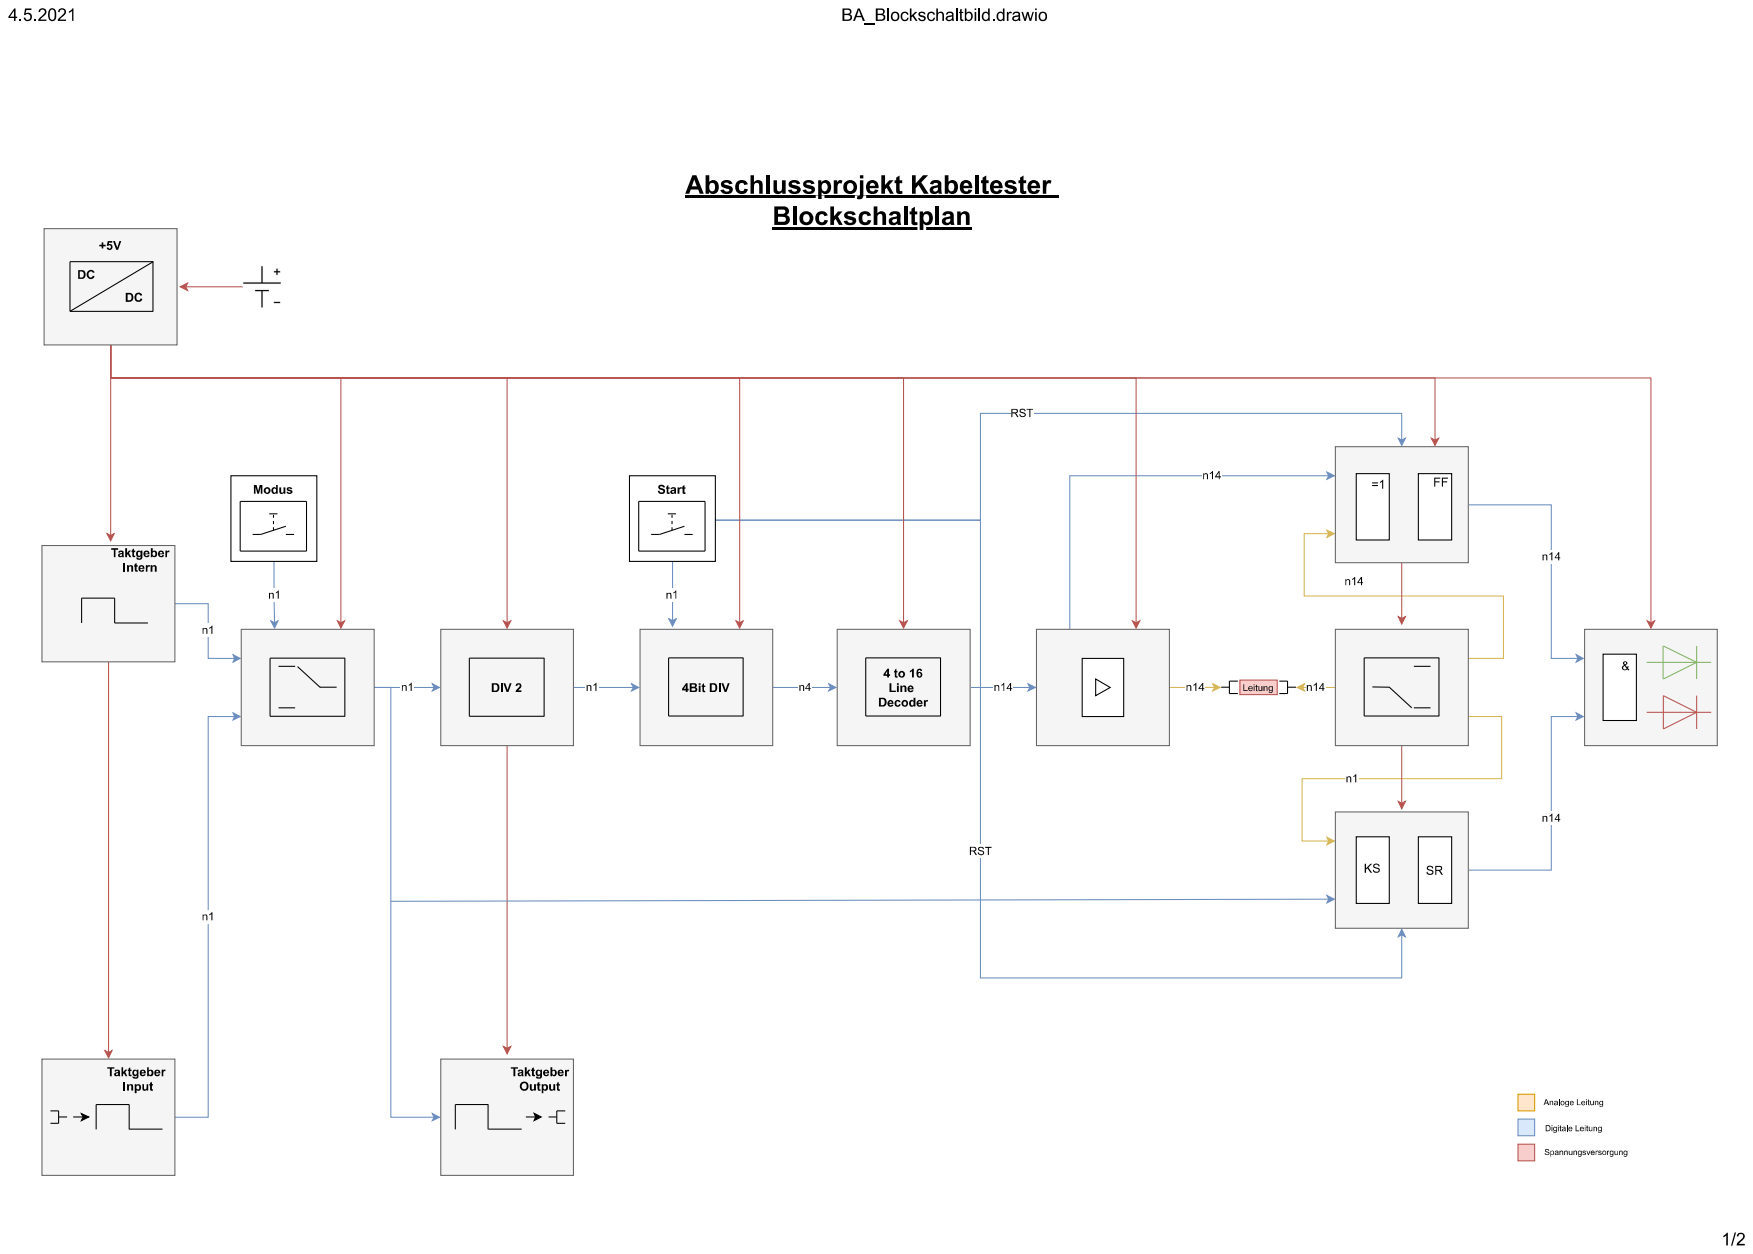
[picture p74: page 1]
