Oszimilian/Kabeltester/03_Dokumente/02_Projektdokumentation/03_Sonstiges/Schaltplan_Kabeltester.pdf

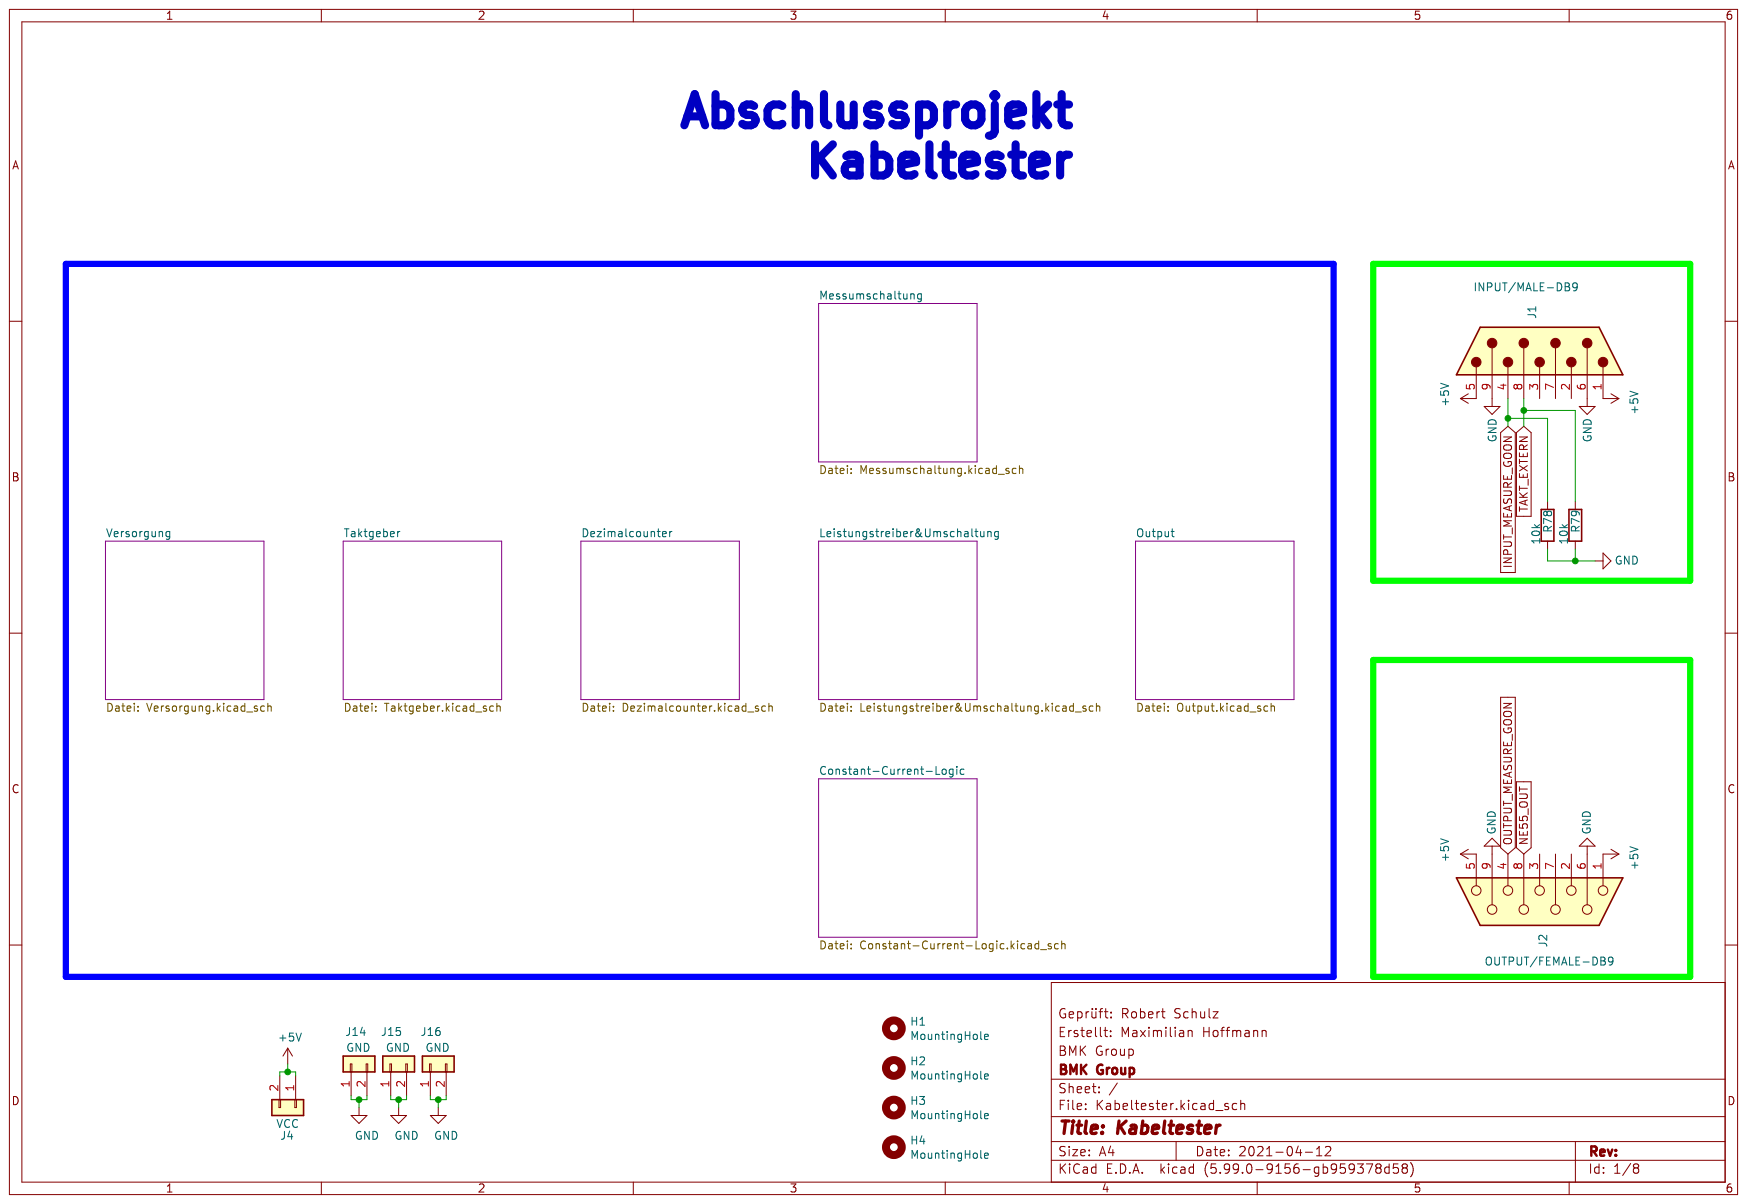
[picture p75: page 1]

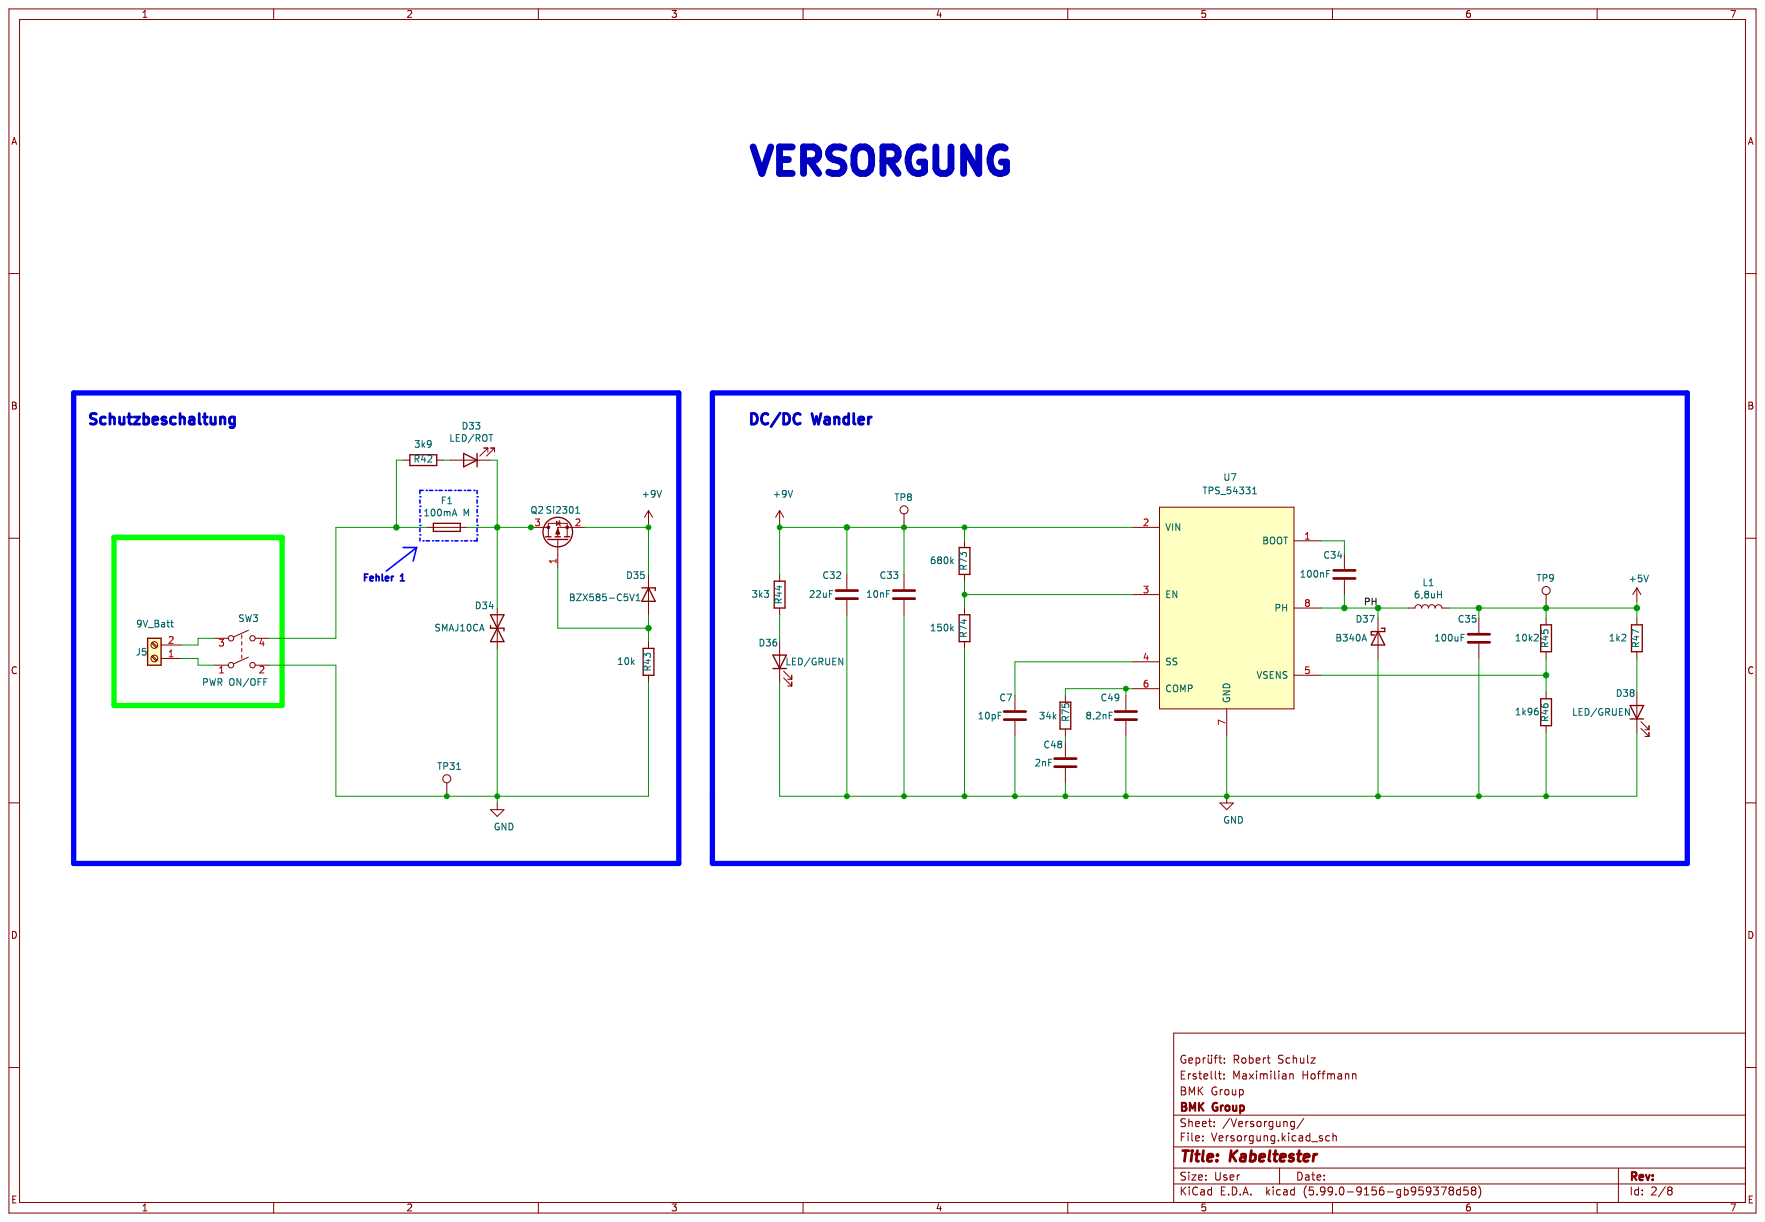
[picture p76: page 2]

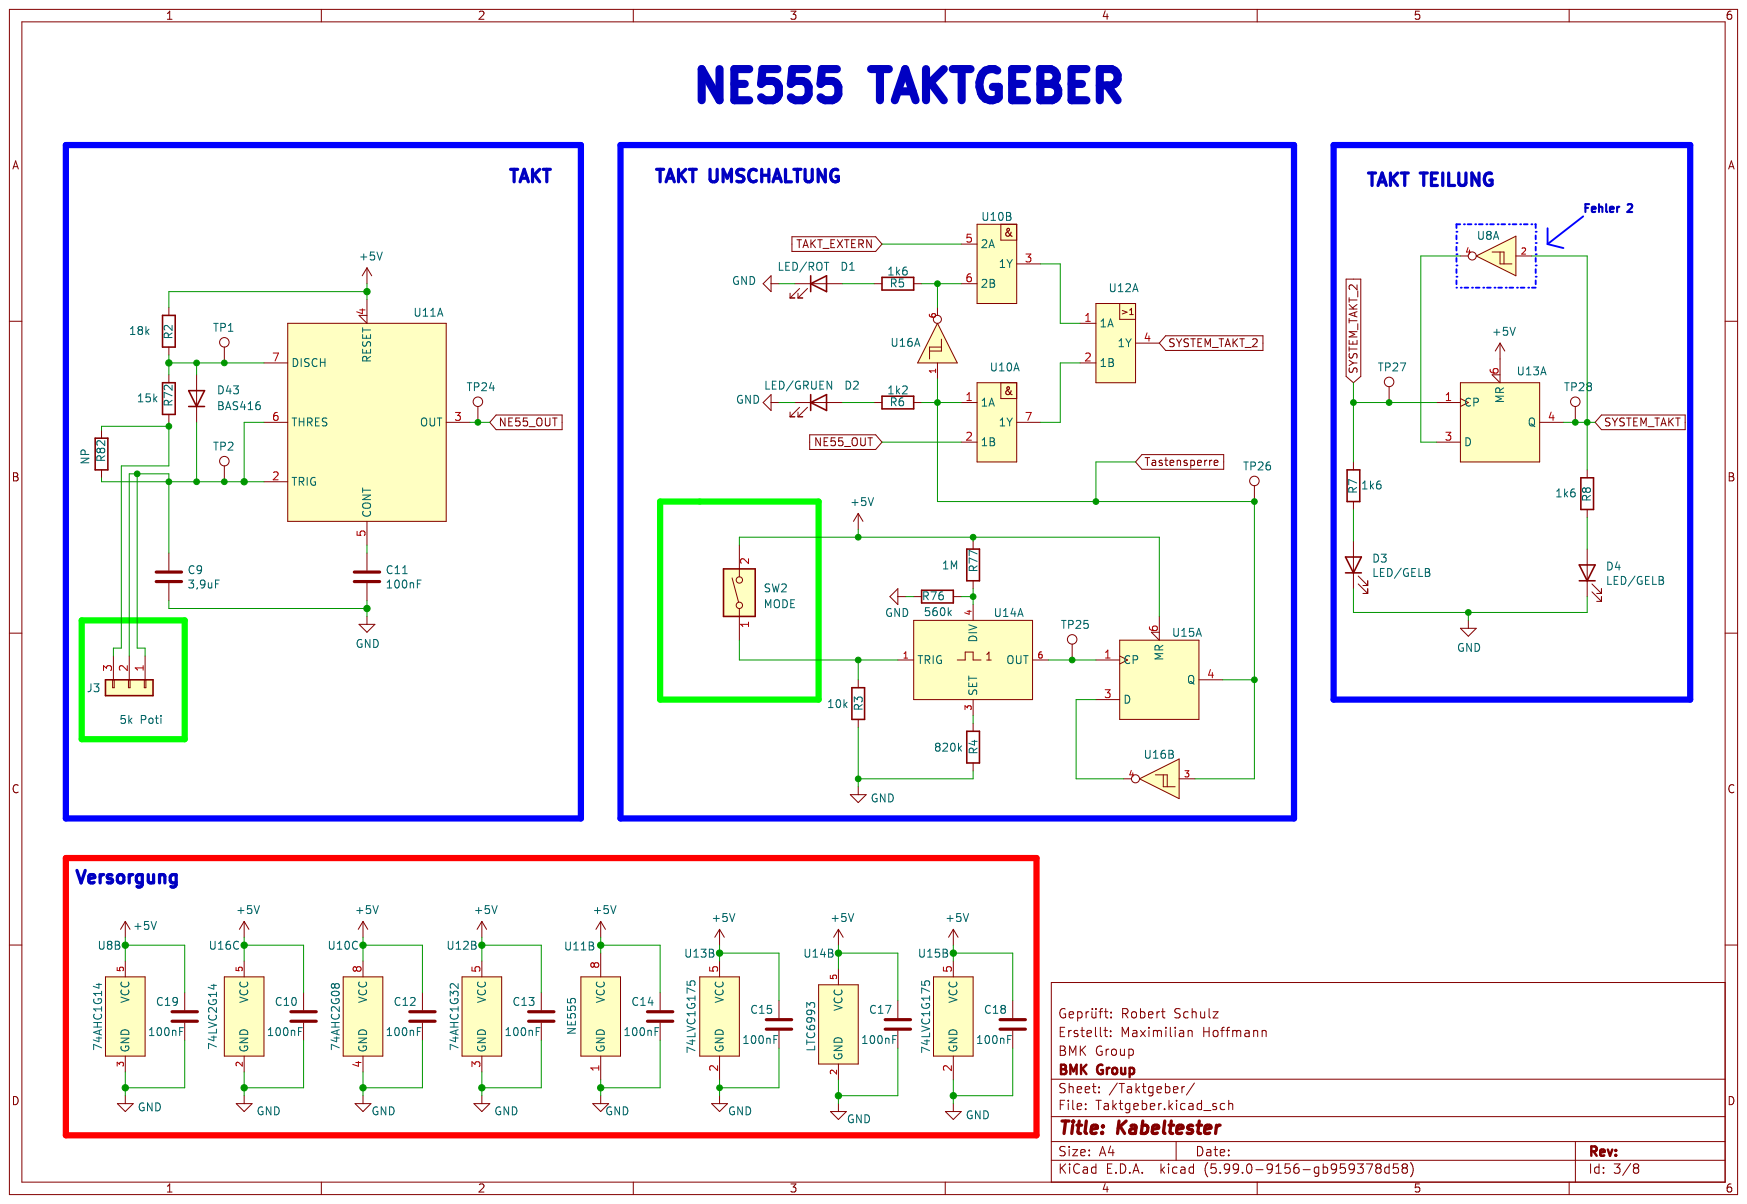
[picture p77: page 3]

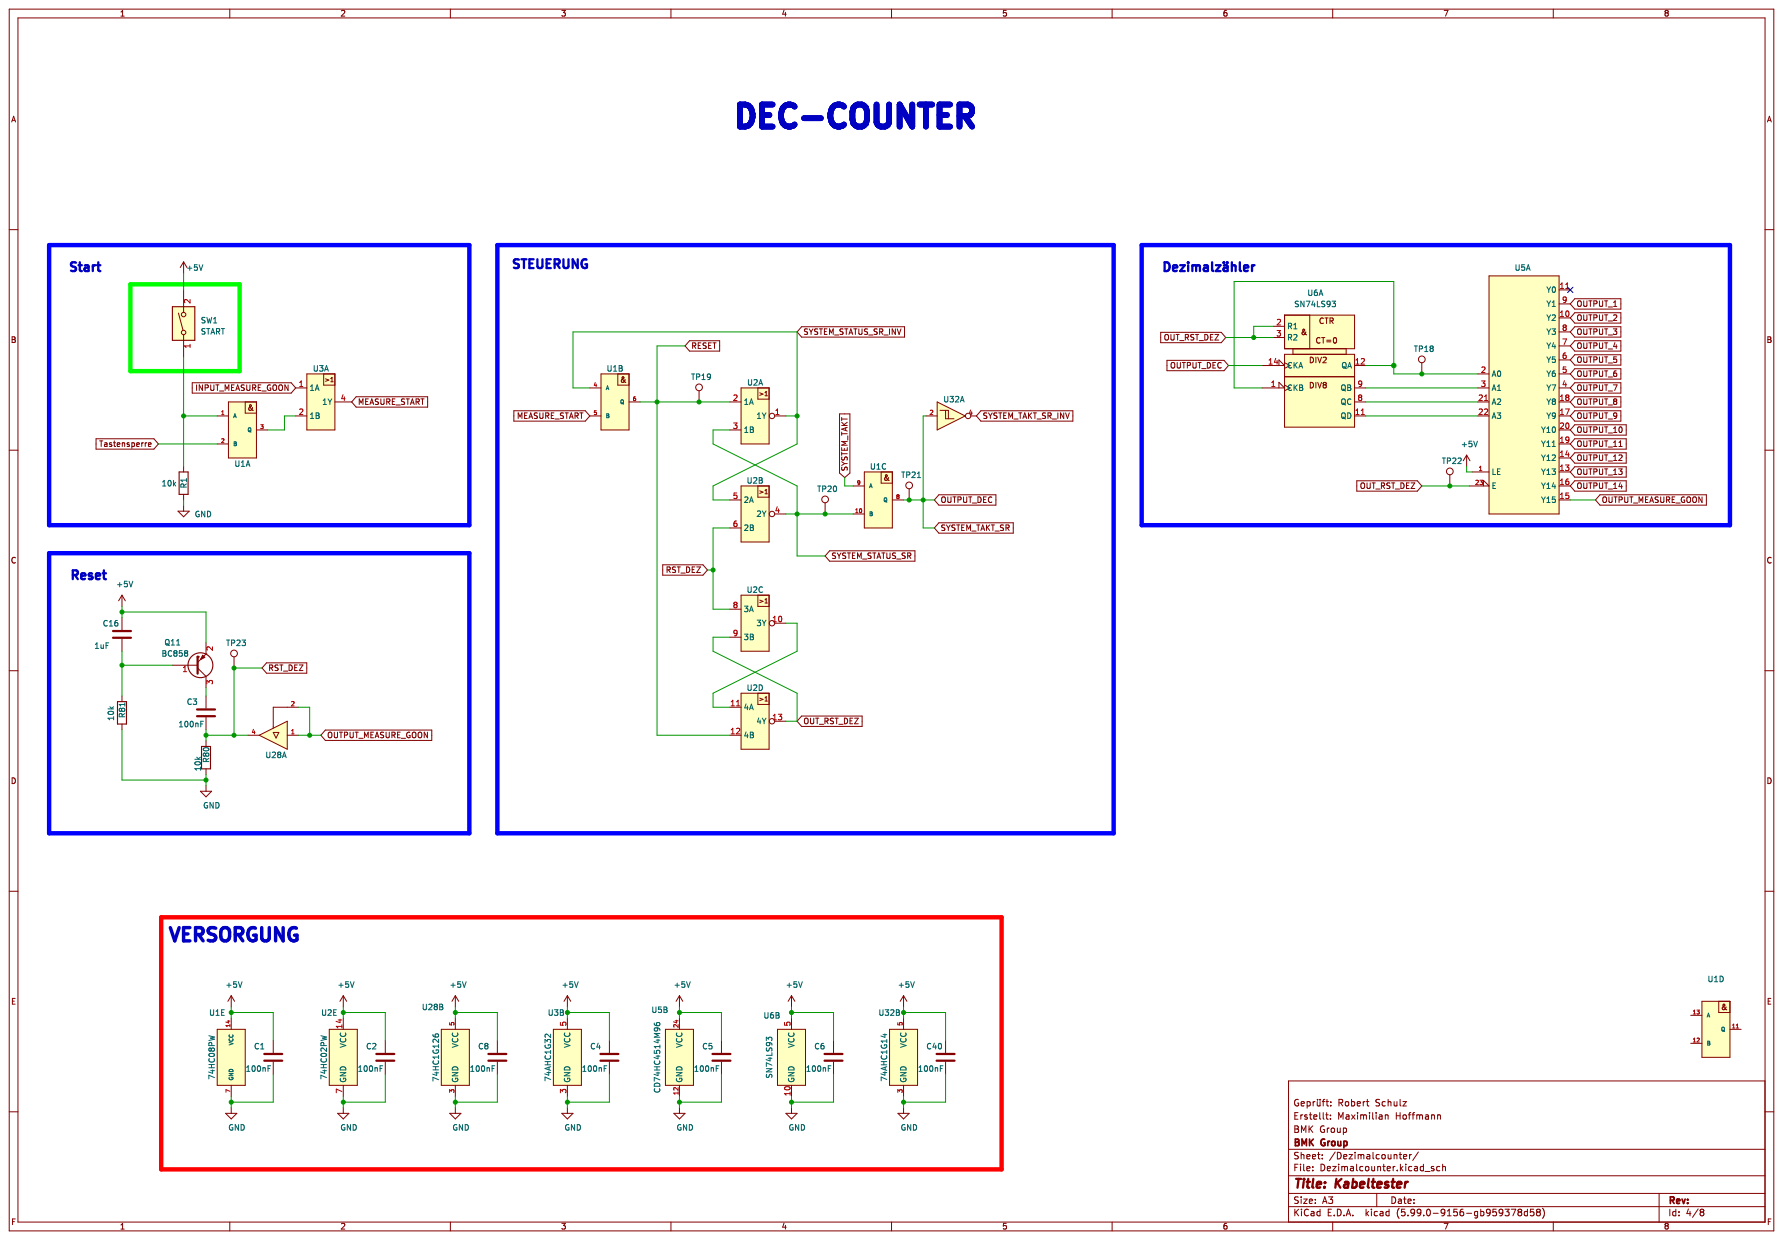
[picture p78: page 4]

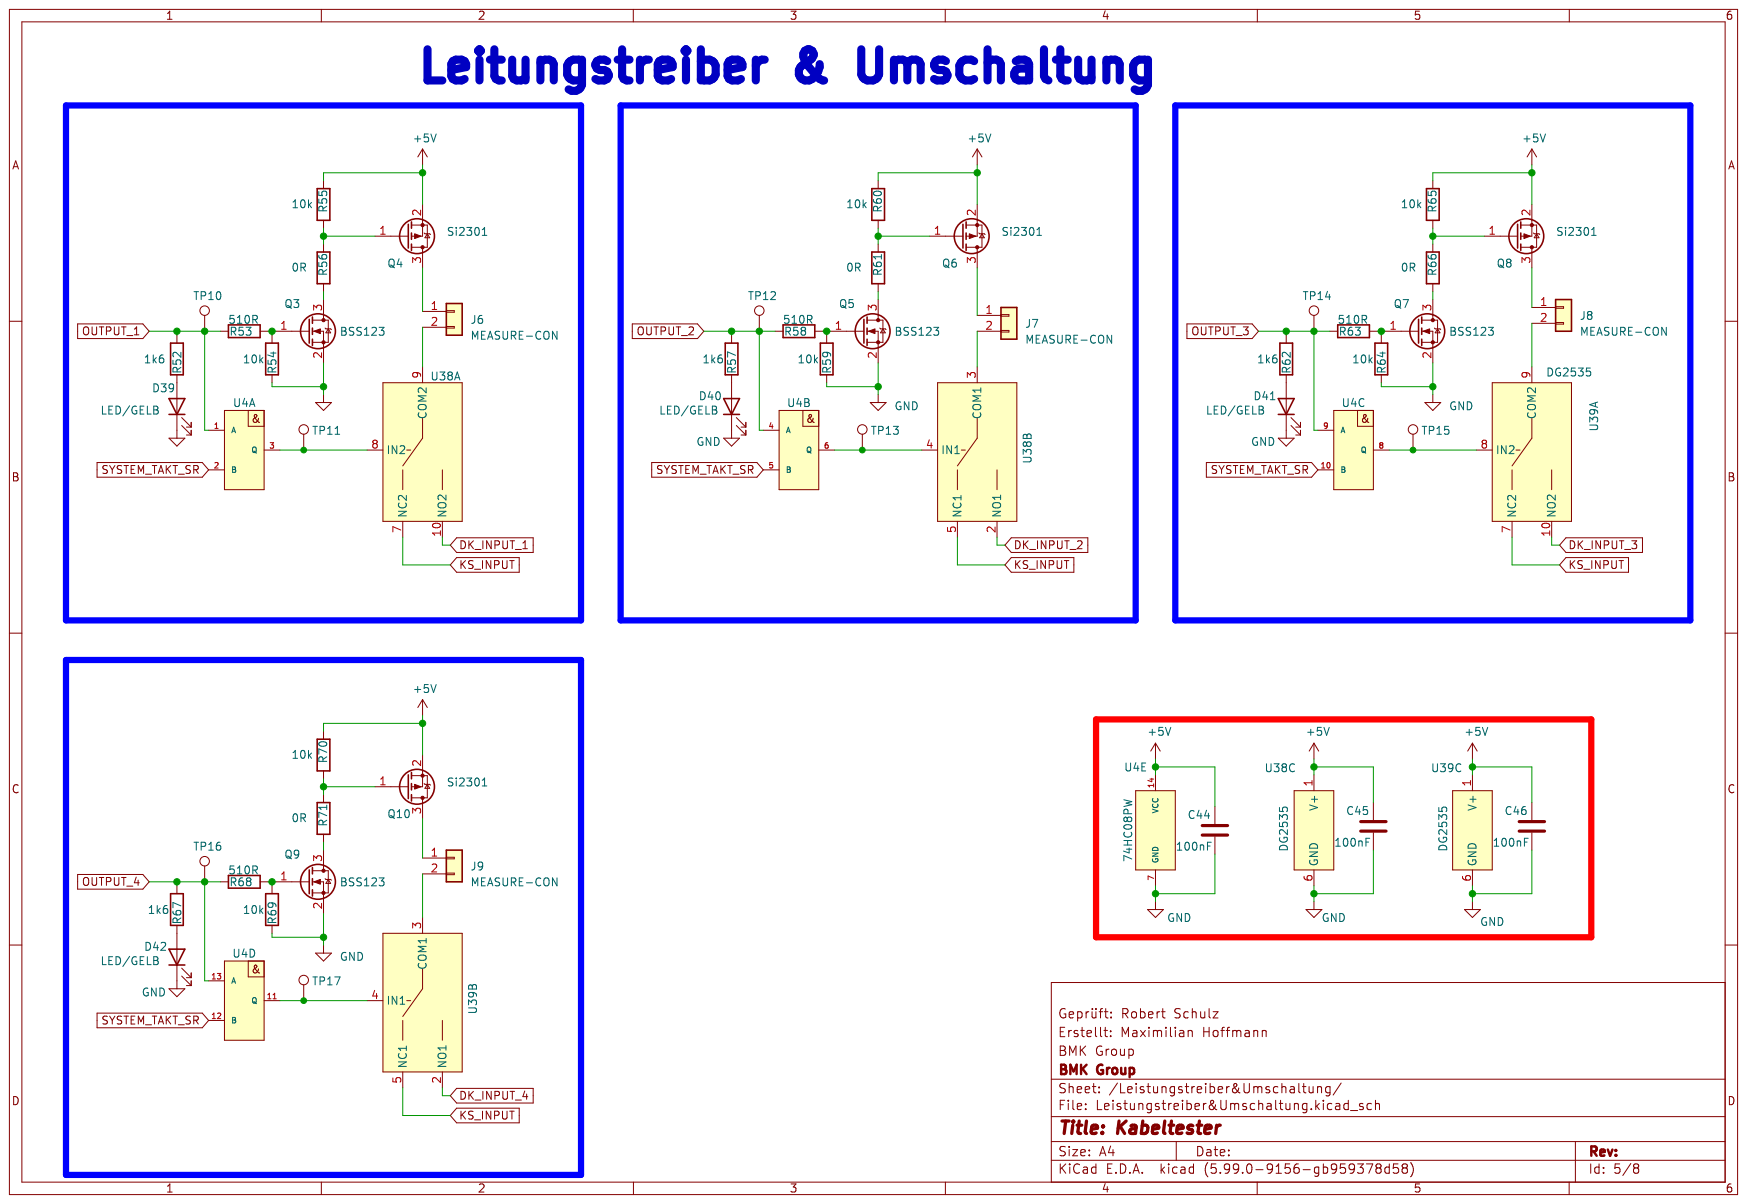
[picture p79: page 5]

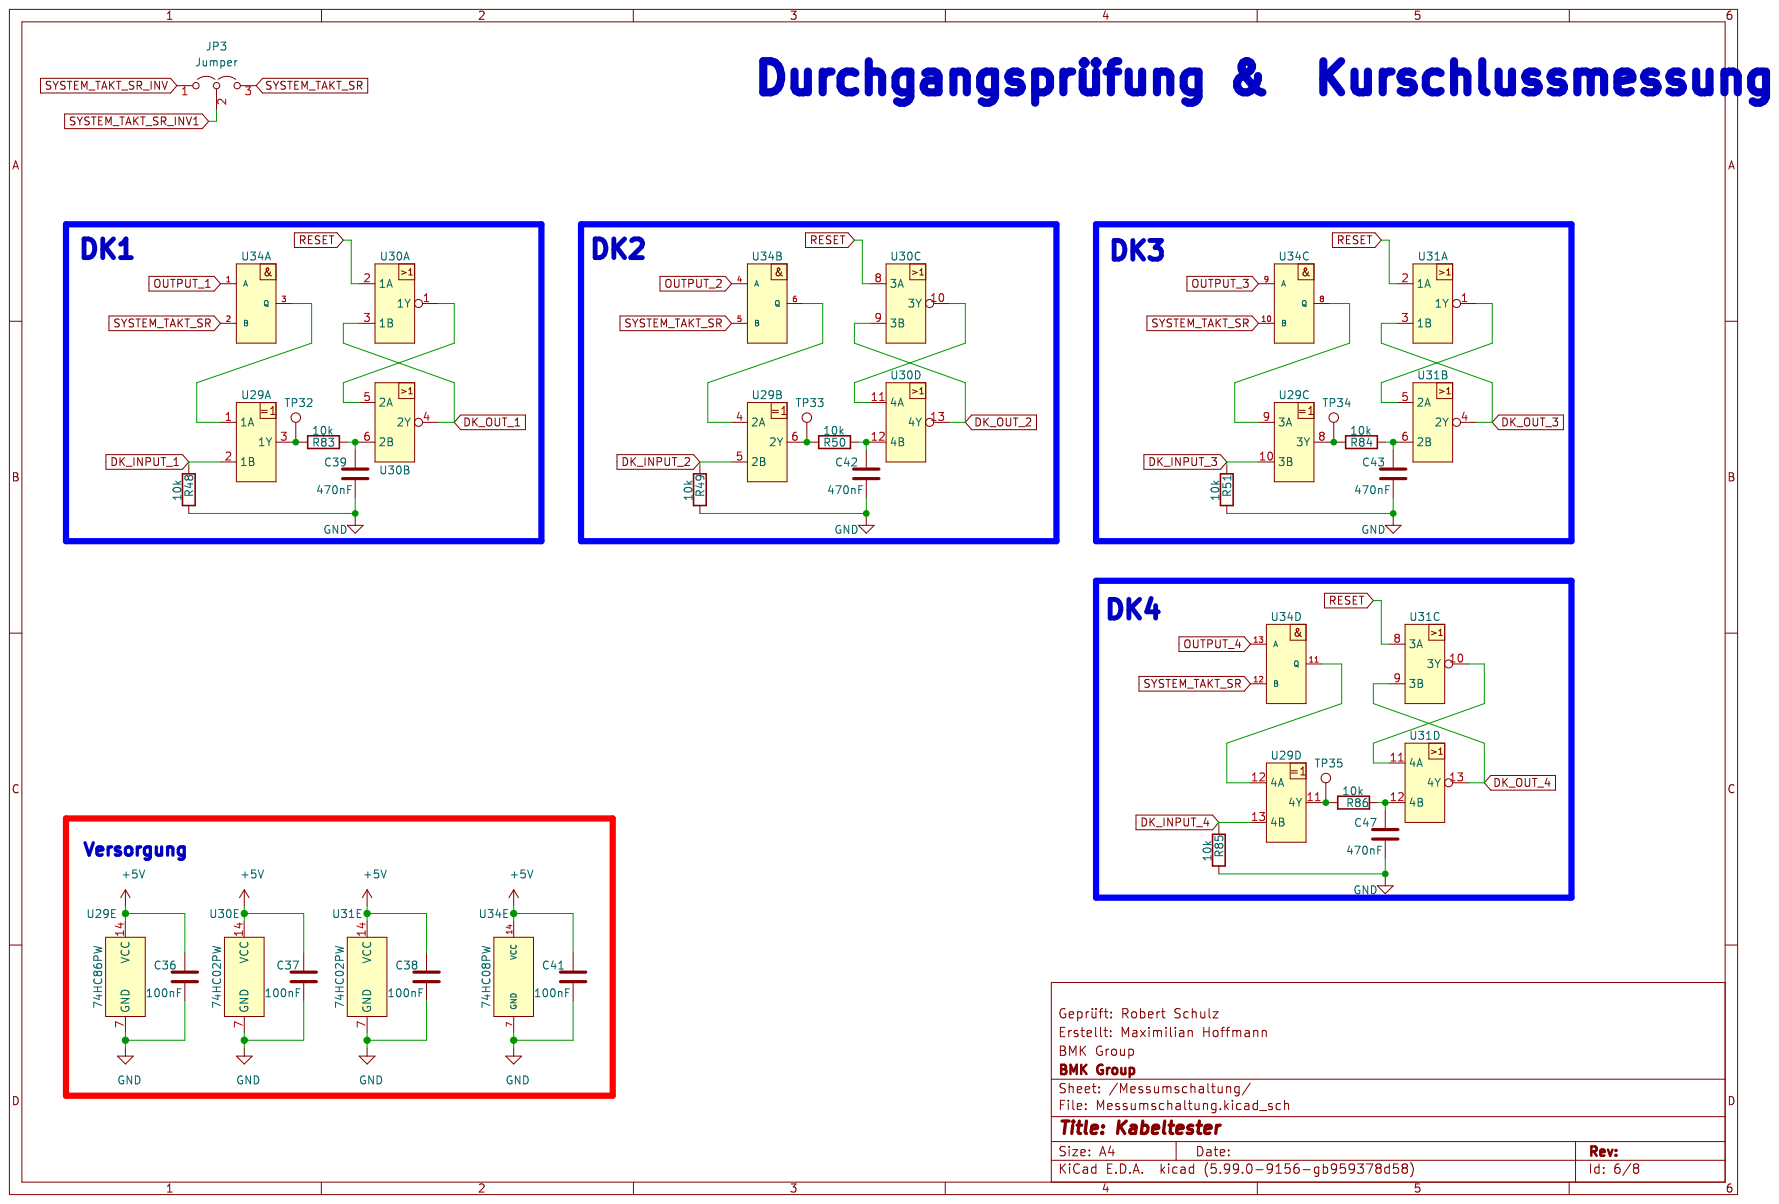
[picture p80: page 6]

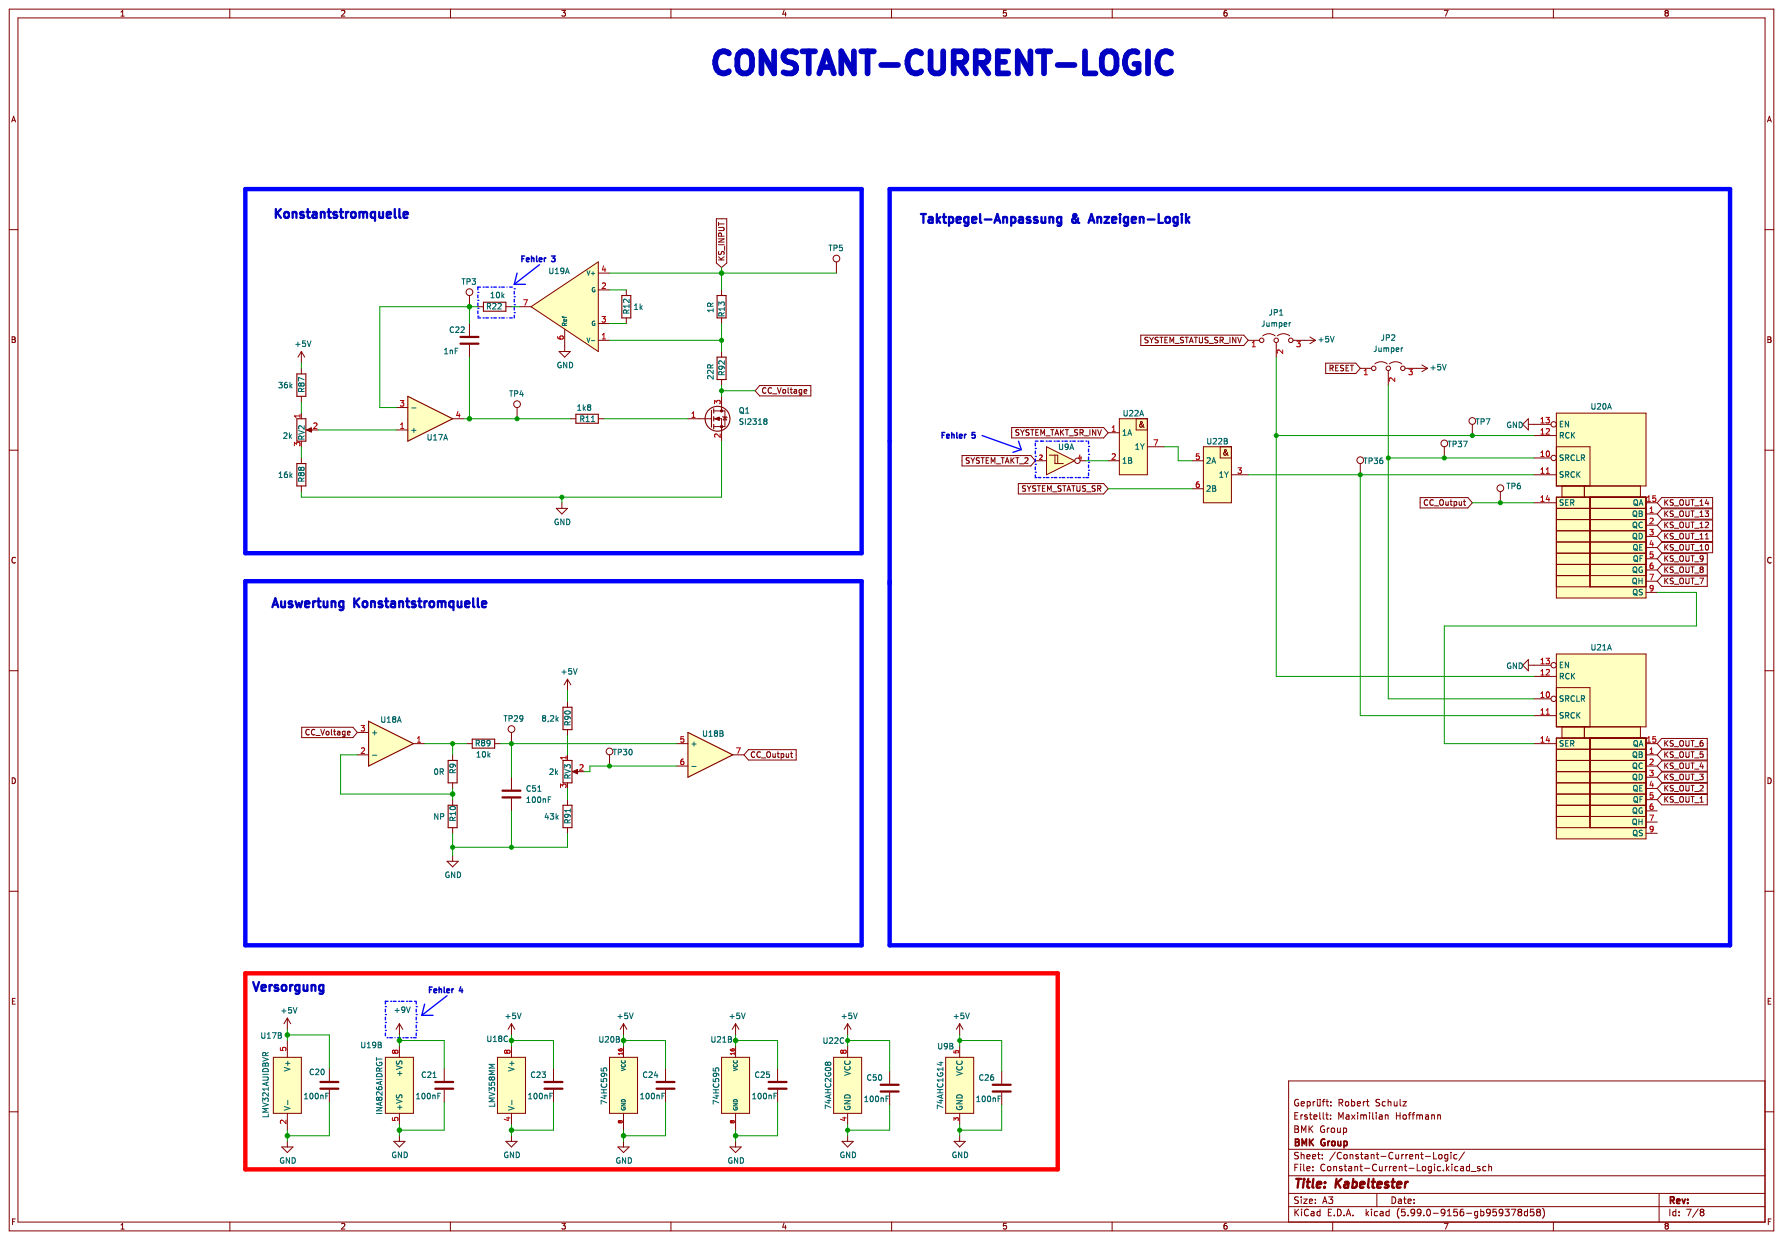
[picture p81: page 7]

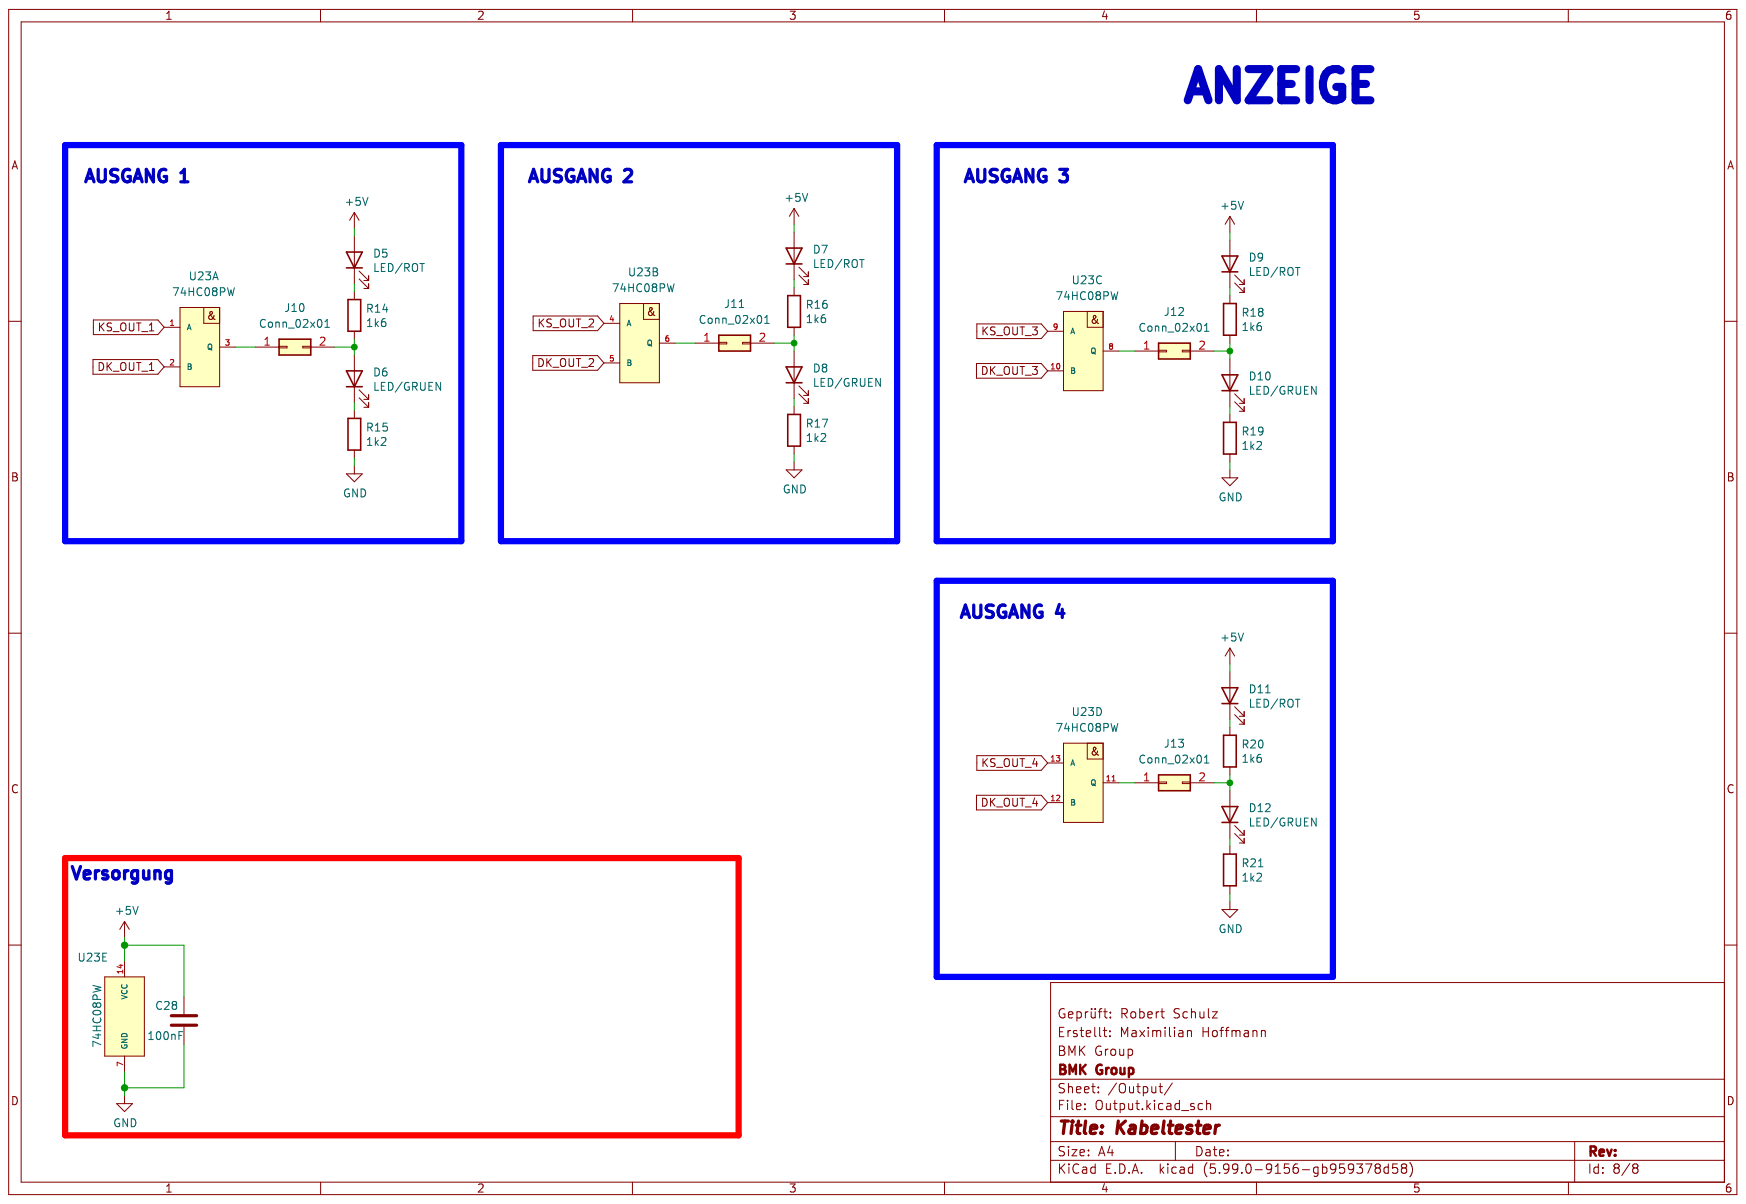
[picture p82: page 8]
