Oszimilian/Kabeltester/03_Dokumente/01_Antrag/01_Lastenheft/PDF/BA_Lastenheft+Rahmen+Stamps.pdf

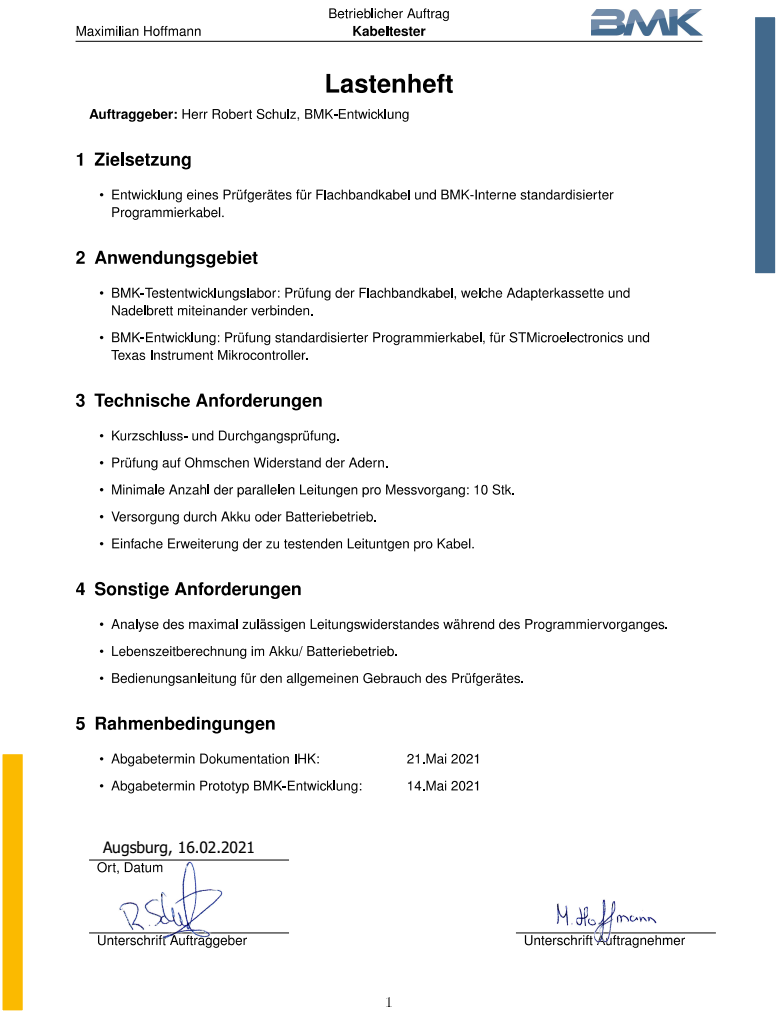
[picture p83: page 1]
Augsburg, 16.02.2021
