Oszimilian/Kabeltester/03_Dokumente/02_Projektdokumentation/01_Dokumentation_Latex/Abschlussprojekt_LaTeX_002/PDF/Schaltplan_Kabeltester.pdf

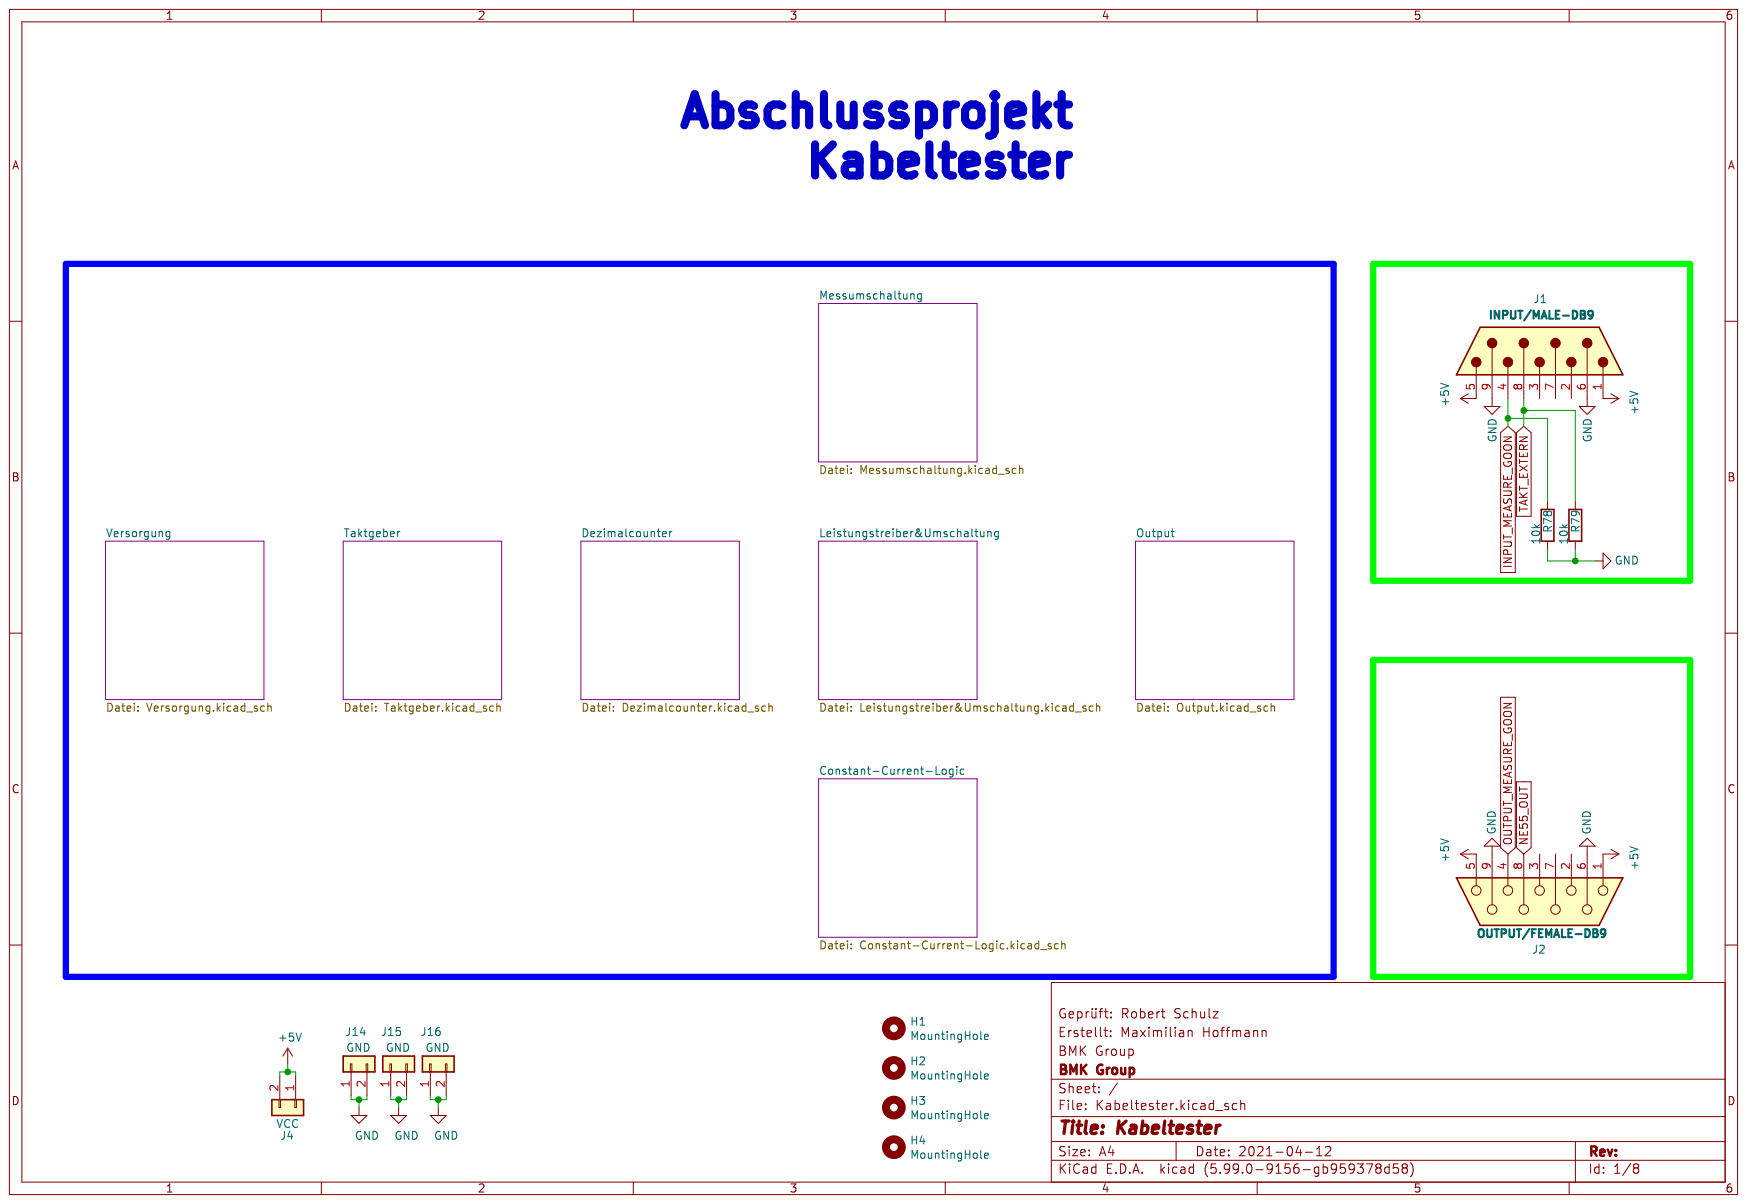
[picture p84: page 1]

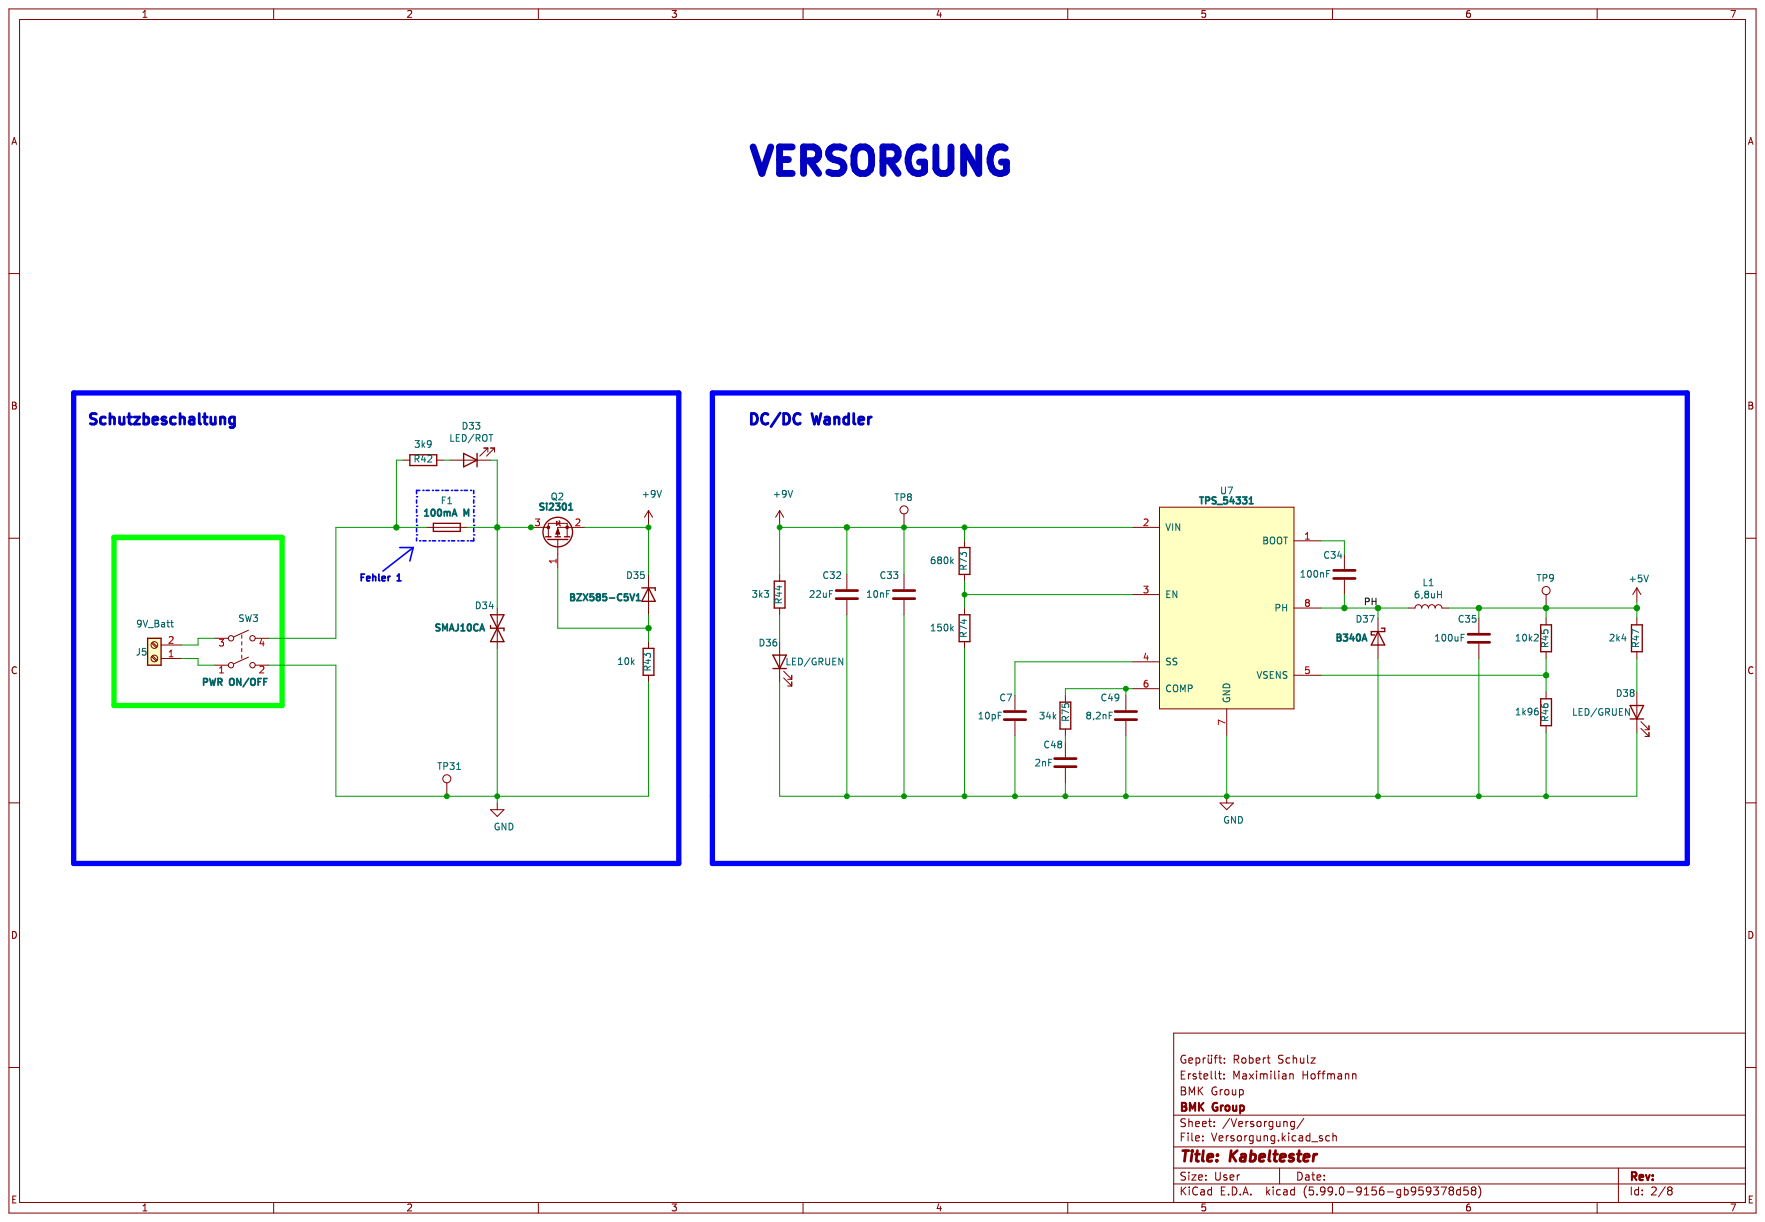
[picture p85: page 2]

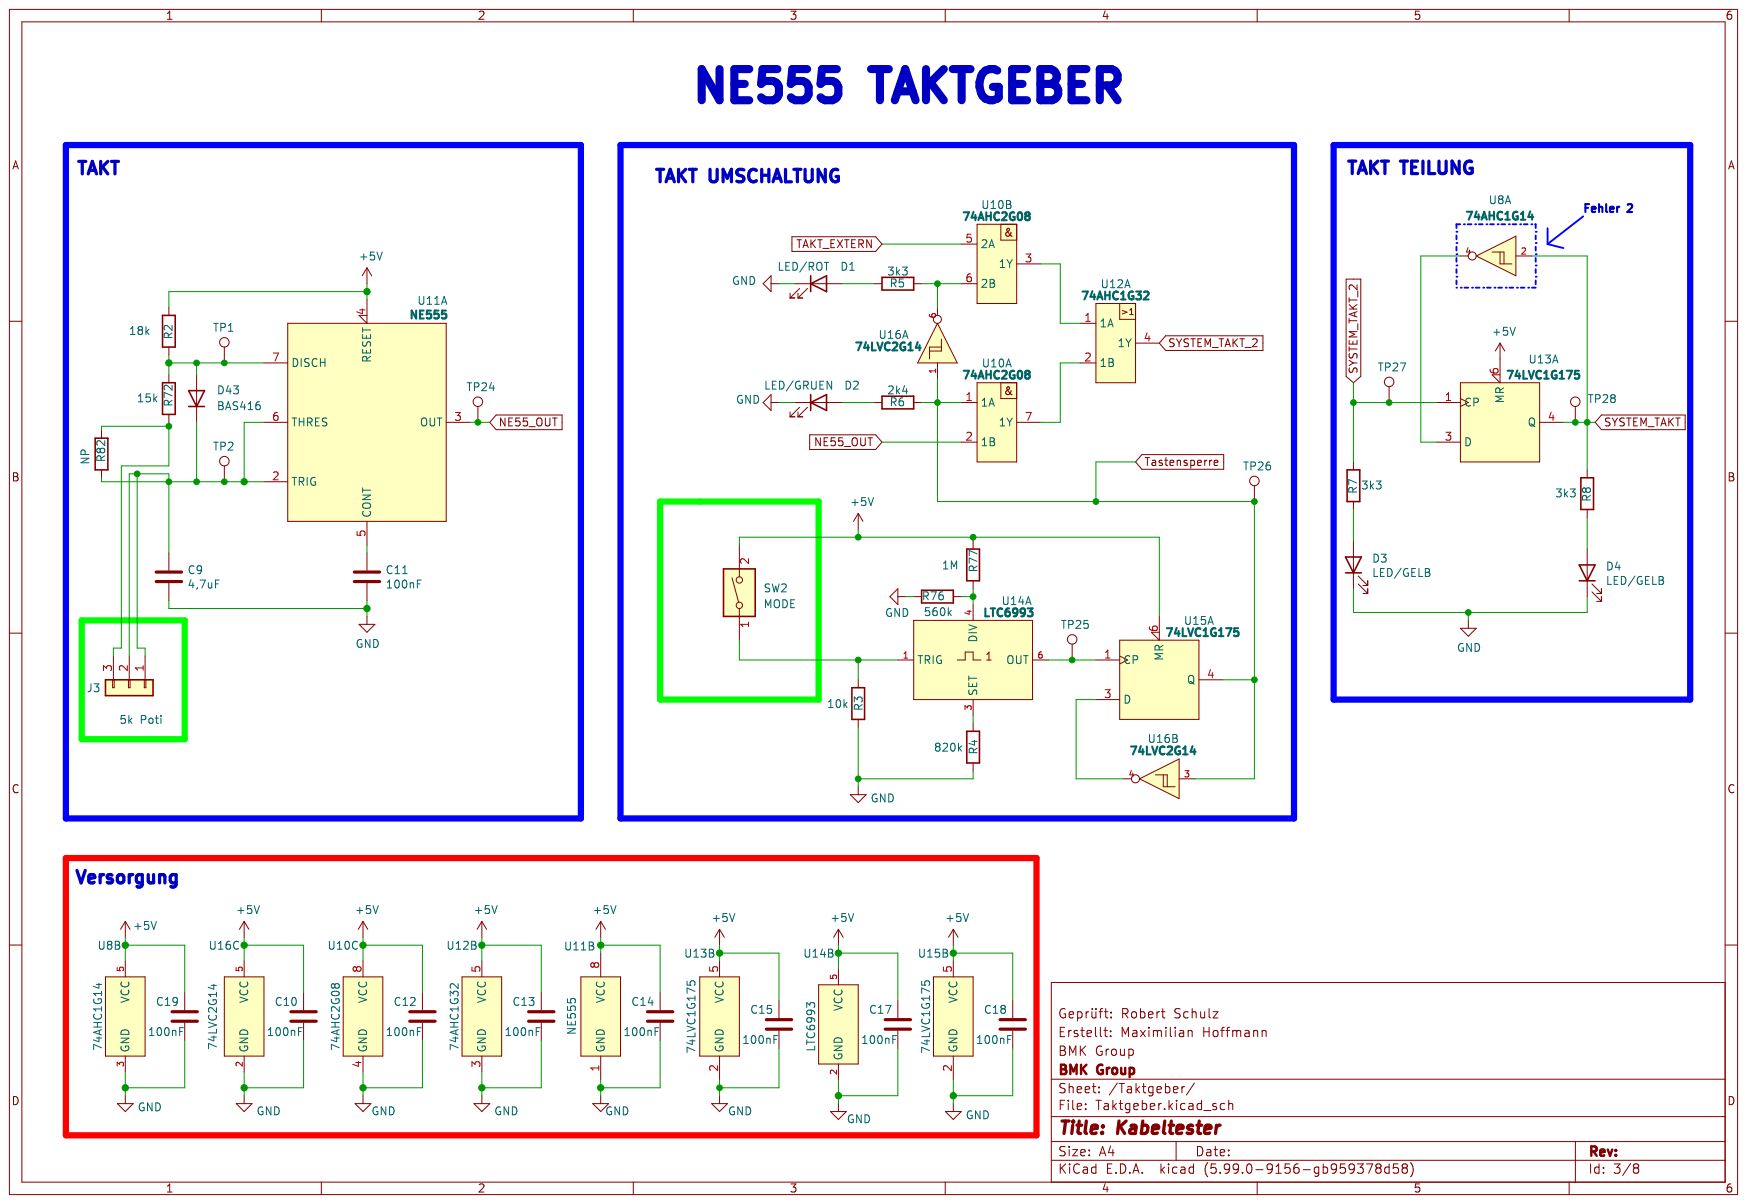
[picture p86: page 3]

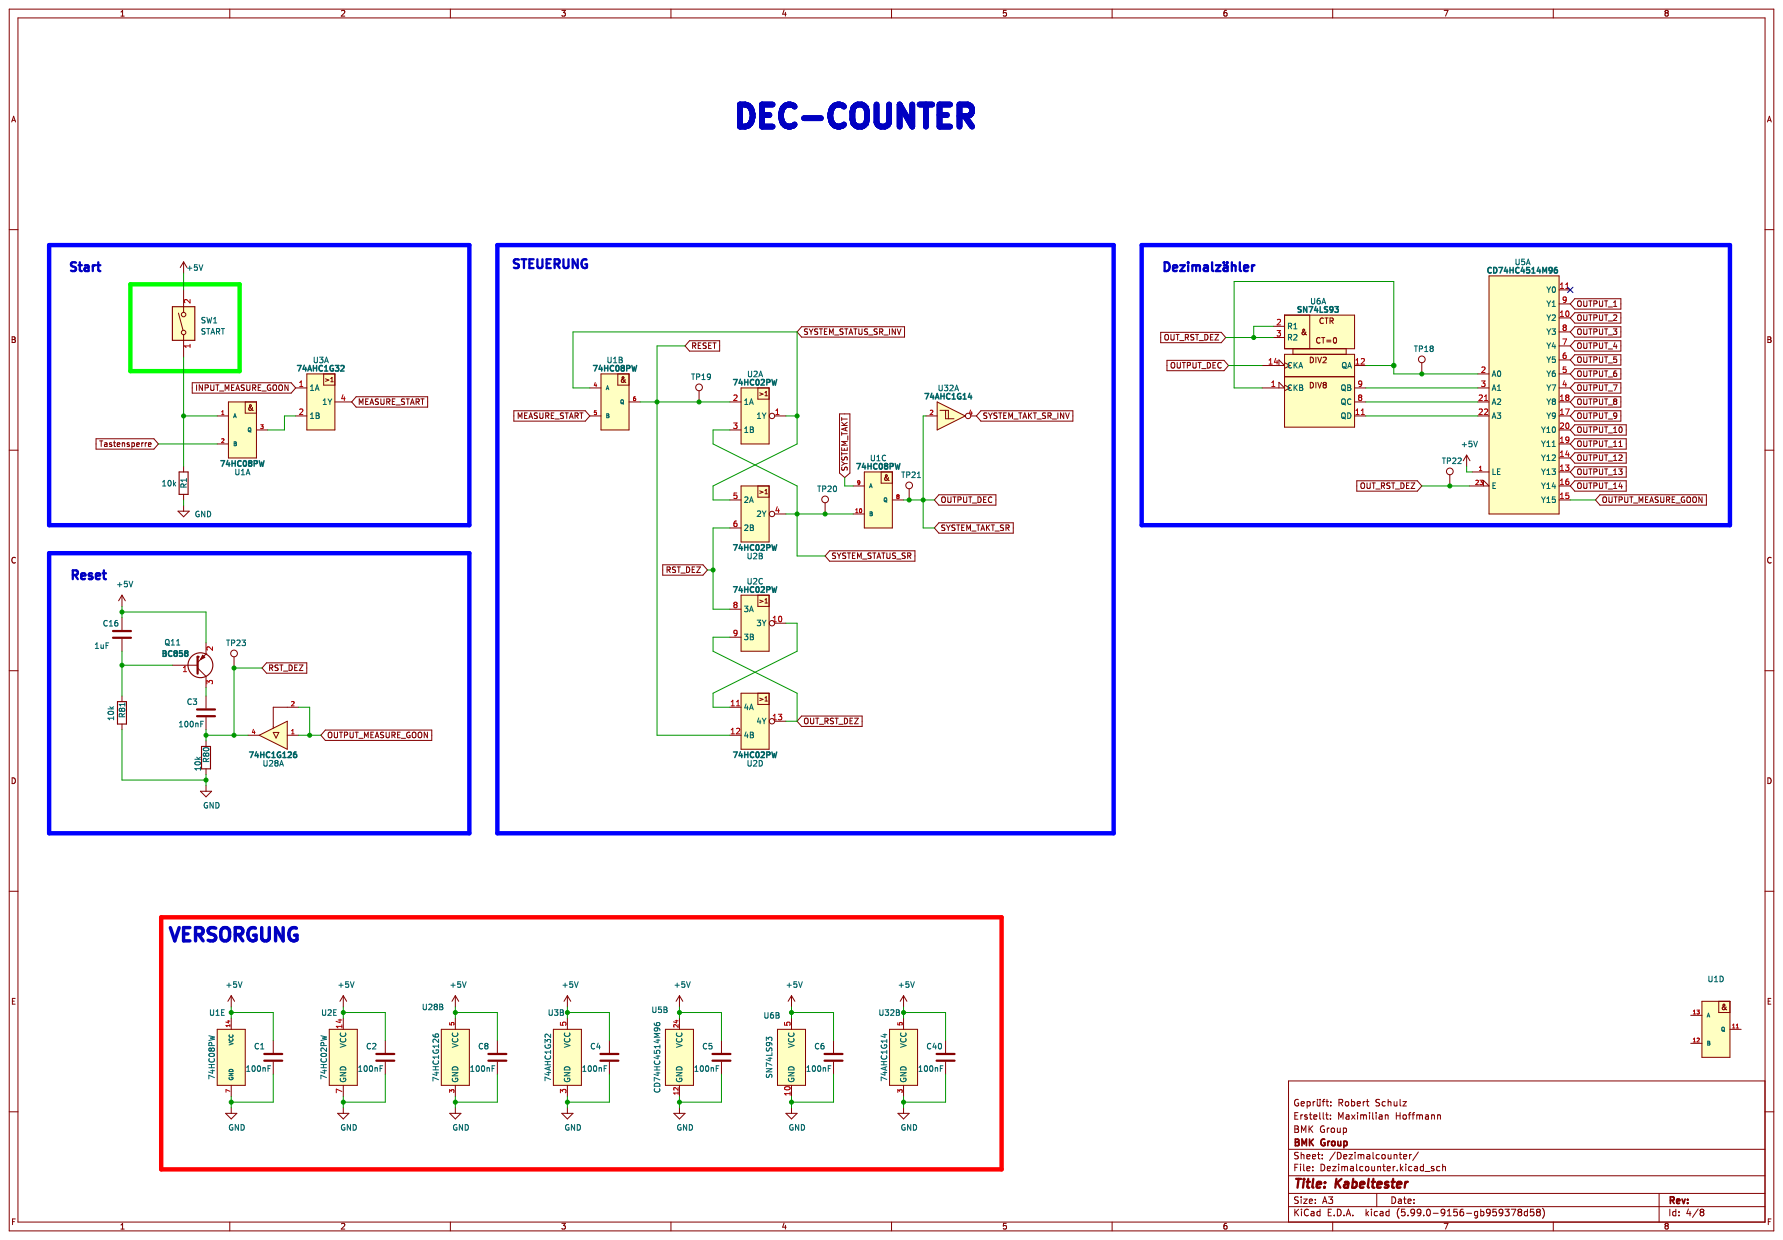
[picture p87: page 4]

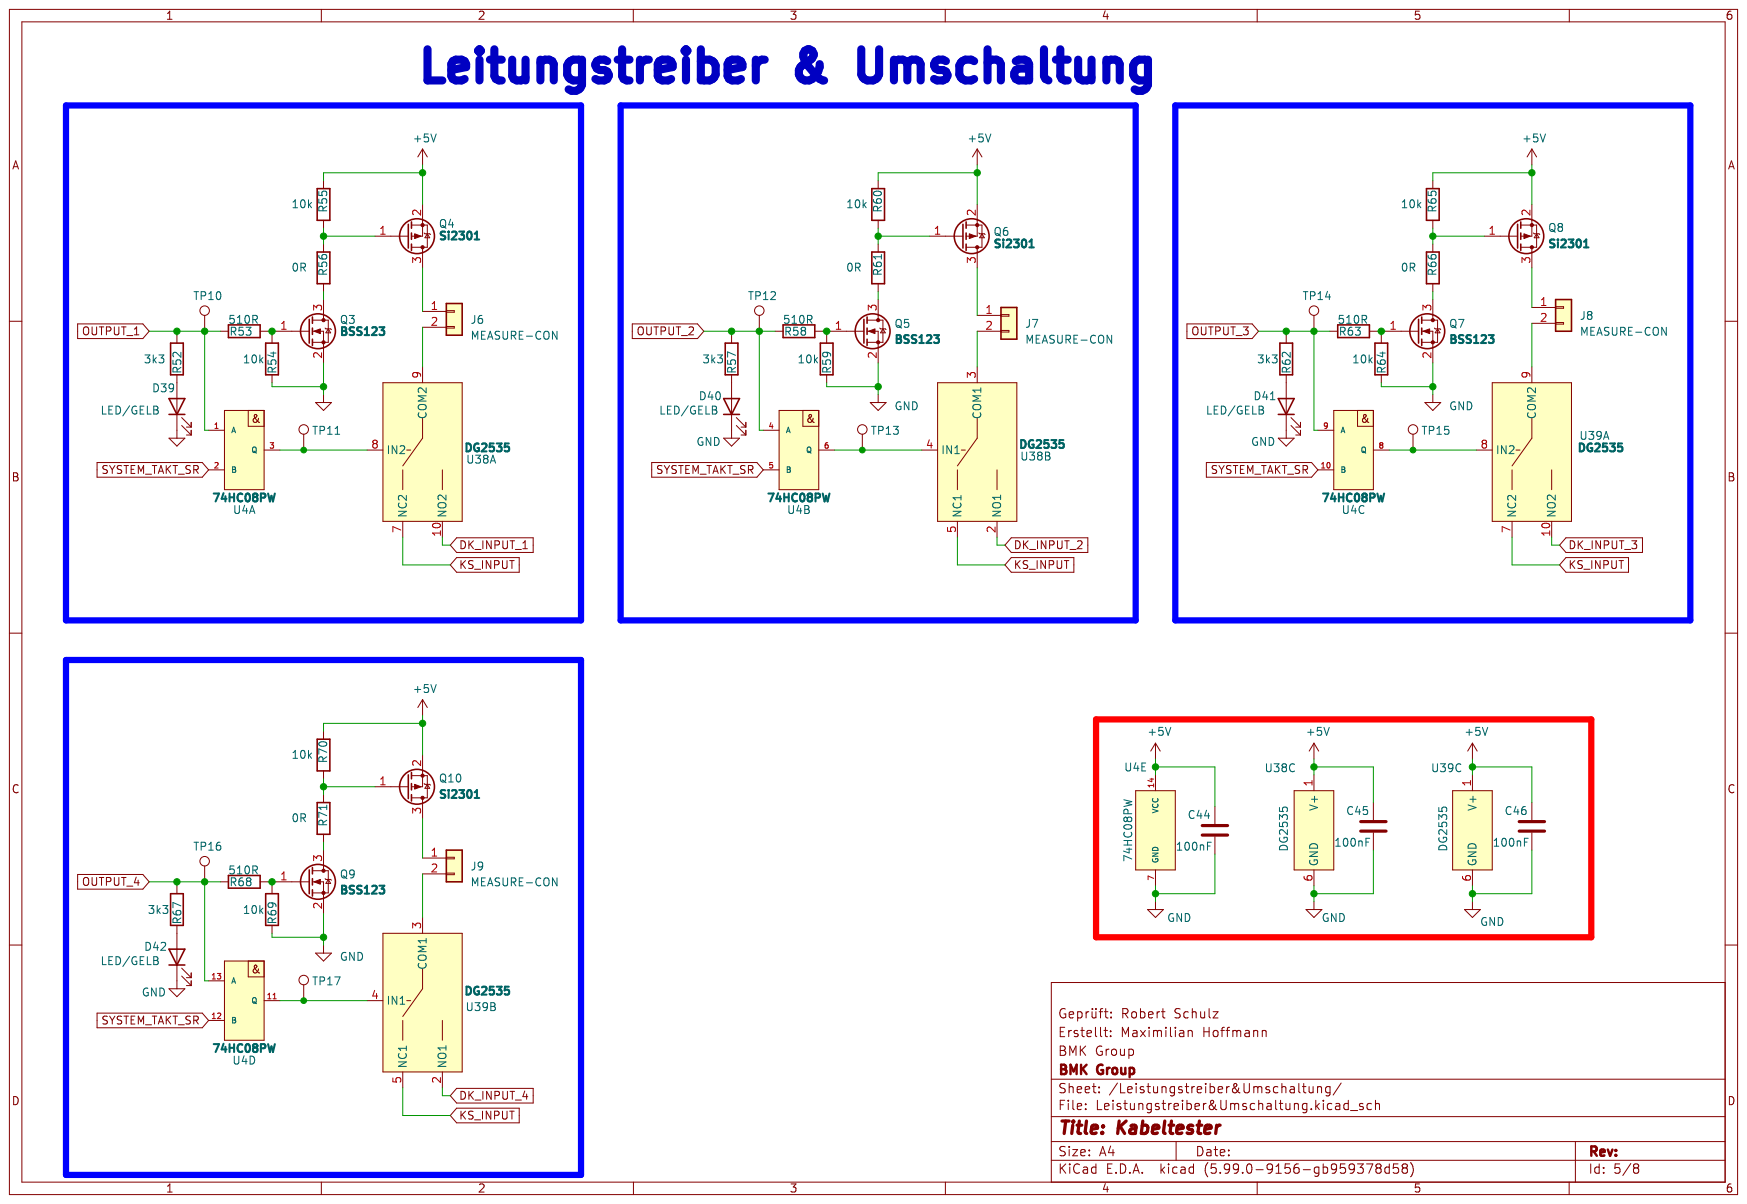
[picture p88: page 5]

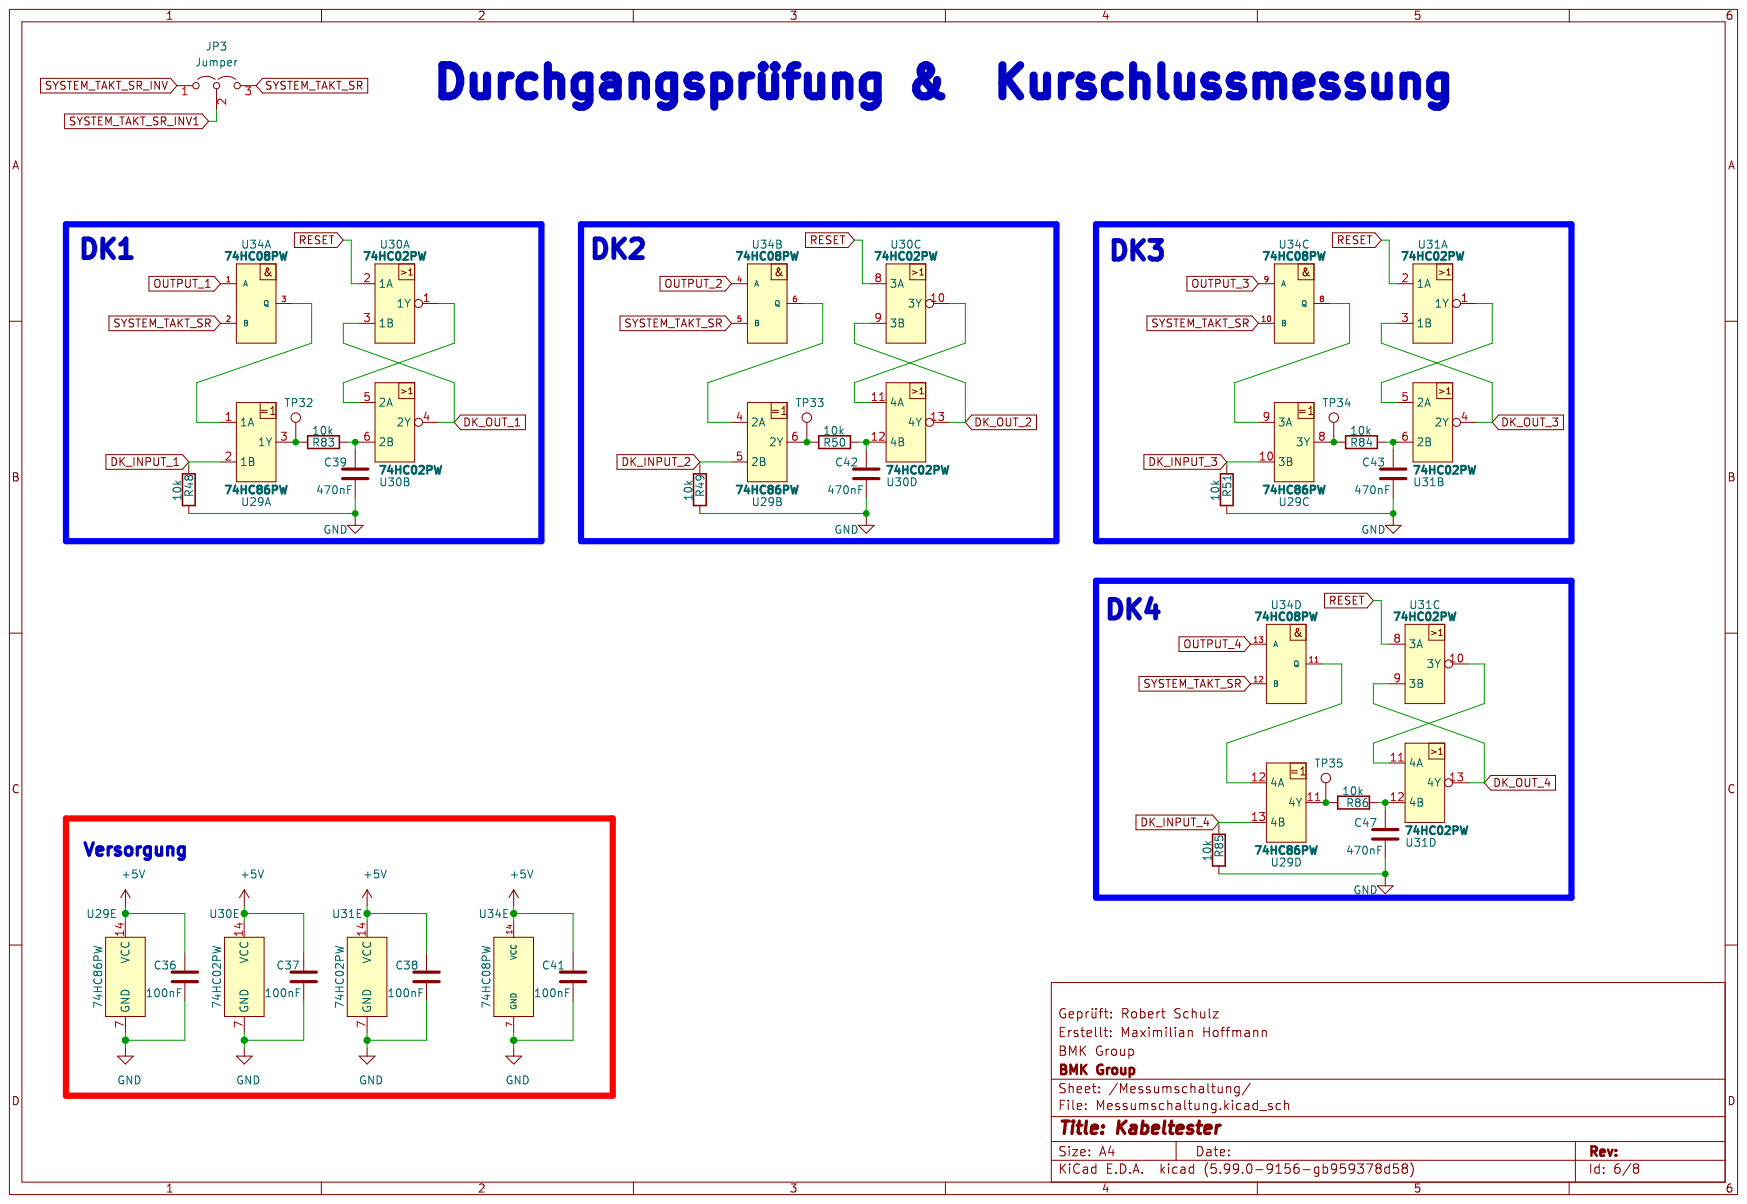
[picture p89: page 6]

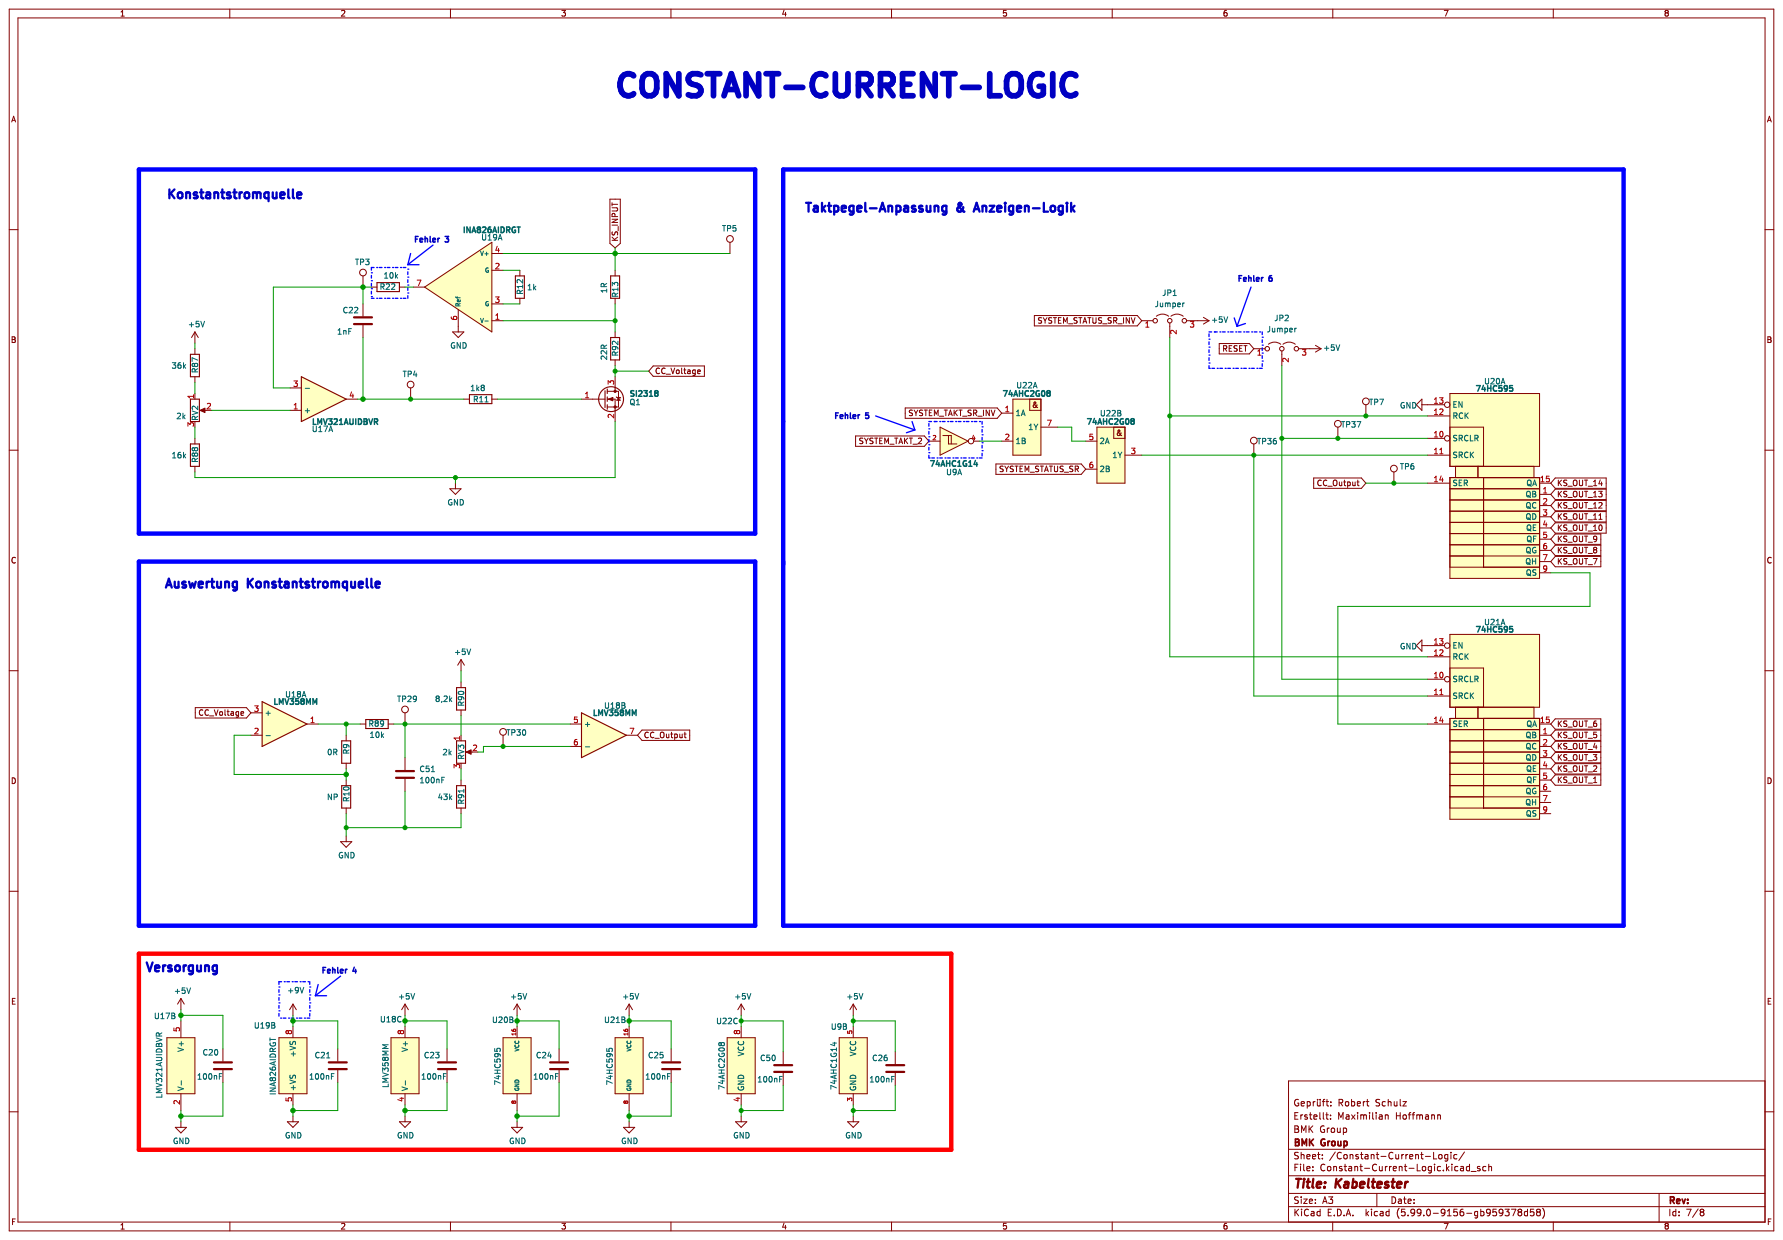
[picture p90: page 7]

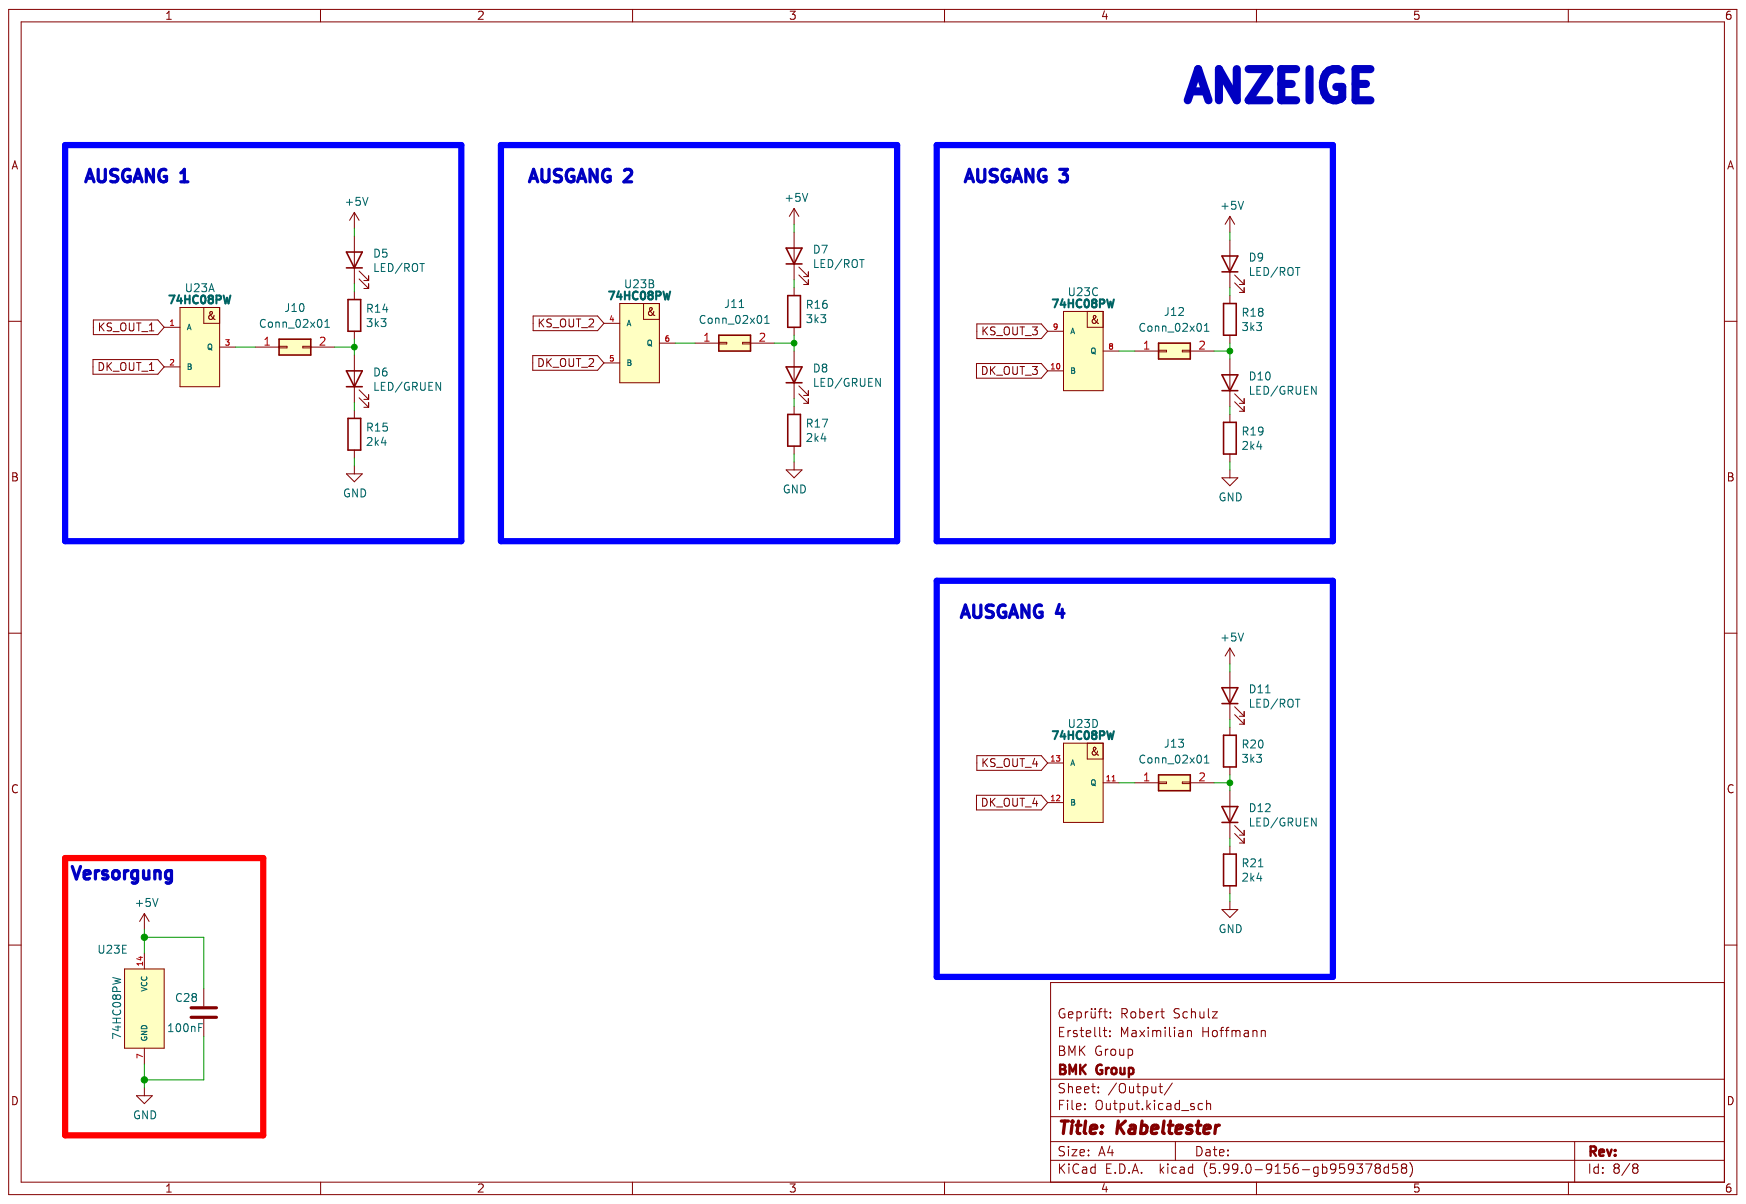
[picture p91: page 8]
