Oszimilian/Kabeltester/04_Simulation/DEC-STAGE/Draft1.asc

M1: nmos; Si7336ADP
M2: pmos; AO6407
R1: res; 1
R2: res; 10k
R4: res; 10k
R5: res; 10R
R10: res; 150R
V1: voltage; 5V
V2: voltage; PULSE(0 5 0 0.0001 0.0001 1 2)
Named nets: 0
.tran 50
