Oszimilian/Kabeltester/04_Simulation/Pegelanpassung/Pegelanpassung.asc

A1: xor
A2: dflop
A3: and
C1: cap; 1µF
C2: cap; 1µF
R1: res; 10k
R2: res; 1k
R3: res; 40k
R4: res; 40k
R5: res; 10k
R6: res; 10k
R7: res; 1k
R8: res; 1k
R10: res; 10k
U1: LTC6079
U2: LTC6079
V1: voltage; PULSE(0 5 0 0.0001 0.0001 1 2 0)
V2: voltage; 5
Named nets: 0
.tran 5s
