Oszimilian/Kabeltester/04_Simulation/Prog-Vorgang/Draft2.asc

C1: cap; 5pF
C2: cap; 20pF
C3: cap; 40pF
C4: cap; 20pF
L1: ind; 0.000000332
R1: res; 1000000
R2: res; 1000
R3: res; 1
V1: voltage; PULSE(0 3.3 0 20ns 20ns 450ns 900ns 0)
Named nets: 0
.tran 1us
