Oszimilian/Kabeltester/04_Simulation/Konstantstromquelle/INA_001/INA_001.asc

C1: cap; 10nF
M1: nmos; Si7336ADP
R2: res; 24.7k
R3: res; 24.7k
R4: res; 50k
R5: res; 50k
R6: res; 50k
R7: res; 50k
R8: res; 10k
R9: res; 1
R10: res; 100R
R11: res; 10k
R13: res; 999
U1: LT1013
U2: LT1013
U3: LT1013
U4: LT1014A
V1: voltage; 9V
V2: voltage; PWL(0 0 0.1 0 0.100001 5)
V3: voltage; PWL(0 0 1 5)
Named nets: 0, VCC
.tran 1s
