Oszimilian/Kabeltester/04_Simulation/DEC-LOGIG/P-Chanal-Diode/Draft1.asc

M1: nmos; Si7336ADP
M2: pmos; Si4427DY
R1: res; 1k
R2: res; 1R
R3: res; 10k
V1: voltage; PULSE(0 5 1ms 0.0000001 0.0000001 5ms 10ms)
V2: voltage; PULSE(0 5 6ms 0.0000001 0.0000001 5ms 10ms)
Named nets: 0
.tran 40ms
