Oszimilian/Kabeltester/04_Simulation/DEC-LOGIG/P-Chanal-Diode/Draft2.asc

A1: and
A2: and
A3: inv
A4: and
R1: res; 1k
V1: voltage; PULSE(0 1 0 0.0000001 0.0000001 1ms 2ms)
V2: voltage; PULSE(0 1 0 0.0000001 0.0000001 2ms 4ms)
V3: voltage; PULSE(0 1 0 0.0000001 0.0000001 8ms 16ms)
Named nets: 0
.tran 20ms
