Oszimilian/Kabeltester/(list of files, drawings)

Other design files:
02_Schaltplan/Altium/Kabeltester.PrjPcb
04_Simulation/DEC-LOGIG/Backup/DEC-LOGIC_005_Backup-Funktioniert/DEC-LOGIC_003.ms14
04_Simulation/DEC-LOGIG/DEC-LOGIC_01.01.ms14
04_Simulation/DEC-LOGIG/DEC-LOGIC_001/DEC-LOGIC_001.ms14
