Oszimilian/Kabeltester/(commit log)

2021-04-08 Upload
    Schaltplan und Libery KiCad
    [Constant-Current-Logic.kicad_sch, Dezimalcounter.kicad_sch, Kabeltester.kicad_pcb, Kabeltester.kicad_sch, Leistungstreiber&Umschaltung.kicad_sch, Messumschaltung.kicad_sch, Output.kicad_sch, Page2_Messumschaltung.kicad_sch]
2021-04-08 Upload
    Weitere Sachen einfach
    [BA_Bestellung_001.ods, Constant-Current-Logic.kicad_sch, Dezimalcounter.kicad_sch, Kabeltester.kicad_pcb, Kabeltester.kicad_sch, Leistungstreiber&Umschaltung.kicad_sch, Messumschaltung.kicad_sch, Output.kicad_sch]
2021-04-08 Upload
    Weitere Sachen
    [BA_Bestellung_001.ods, DEC-LOGIC_001.ms14, DEC-LOGIC_003.ms14, DEC-LOGIC_01.01.ms14]
2021-04-08 Changes
    keine Änderungen
    [Kabeltester.PrjPcb]
2021-04-12 ADD
    -Dokumentation erweitert
    -Schaltplan Fußbeschriftungen
    [BA_Bestellung_002.ods, Constant-Current-Logic.kicad_sch, Dezimalcounter.kicad_sch, Kabeltester.kicad_sch, Leistungstreiber&Umschaltung.kicad_sch, Messumschaltung.kicad_sch, Output.kicad_sch, Taktgeber.kicad_sch]
2021-04-13 Changes & ADD
    +Bestückungsplan
    +Auftragsplannung
    @ Klärung verschiedener Begrifflichkeiten
    [Constant-Current-Logic.kicad_sch, Dezimalcounter.kicad_sch, Kabeltester.kicad_pcb, Kabeltester.kicad_sch, Leistungstreiber&Umschaltung.kicad_sch, Messumschaltung.kicad_sch, Output.kicad_sch, Page2_Messumschaltung.kicad_sch]
2021-04-13 Change
    keine Beschreibung der Herangehensweiße
    vllt einfach Graphisch beschreiben
2021-04-16 Changes
    constant-current
    [Constant-Current-Logic.kicad_sch, Kabeltester.kicad_sch]
2021-04-25 ADD & Changes
    Inbetriebnahme Tex
    [Constant-Current-Logic.kicad_sch, Dezimalcounter.kicad_sch, Kabeltester.kicad_pcb, Kabeltester.kicad_sch, Leistungstreiber&Umschaltung.kicad_sch, Messumschaltung.kicad_sch, Output.kicad_sch, Page2_Messumschaltung.kicad_sch]
2021-04-26 Inbetriebnahme 'Doc
    [Kabeltester.kicad_sch, Taktgeber.kicad_sch]
2021-04-29 Doku
    Schaltplan
    -Versorgung
    -Taktgeber
    [Constant-Current-Logic.kicad_sch, Kabeltester.kicad_sch, Leistungstreiber&Umschaltung.kicad_sch, Taktgeber.kicad_sch, Versorgung.kicad_sch]
2021-05-02 Änderungen
    [Constant-Current-Logic.kicad_sch, Dezimalcounter.kicad_sch, Leistungstreiber&Umschaltung.kicad_sch, Messumschaltung.kicad_sch, Taktgeber.kicad_sch]
2021-05-07 ddd
    ADD's
    Changes
    [Constant-Current-Logic.kicad_sch, Kabeltester.kicad_sch, Leistungstreiber&Umschaltung.kicad_sch, Output.kicad_sch, Taktgeber.kicad_sch, Versorgung.kicad_sch]
